OpenSprinkler/OpenSprinkler-Hardware/OSPi/enclsoure/3Dprint/ospi152/ospi152_transparent_frontpanel_sampel.jpg

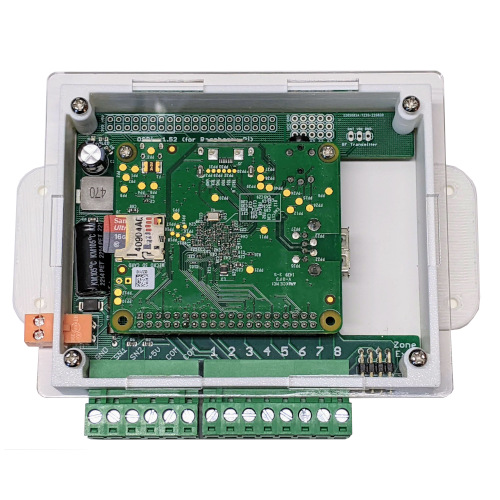
OSPi/enclsoure/3Dprint/ospi152/ospi152_transparent_frontpanel_sampel.jpg
