OpenSprinkler/OpenSprinkler-Hardware/OSPi/enclsoure/3Dprint/ospi152/ospi152_3denc_sample.jpg

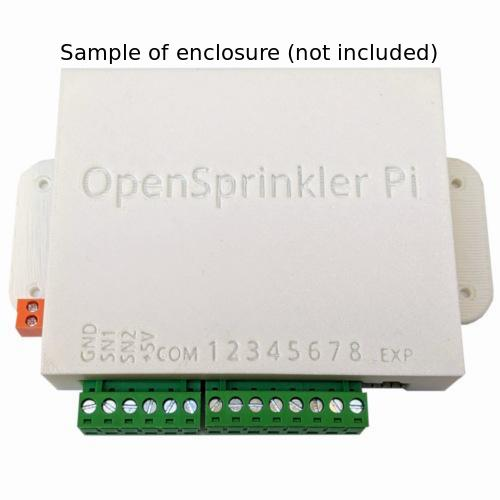
OSPi/enclsoure/3Dprint/ospi152/ospi152_3denc_sample.jpg
