OpenSprinkler/OpenSprinkler-Hardware/README.md

# OpenSprinkler-Hardware
OpenSprinkler Hardware and Enclosure files.
The .sch and .brd files are created in Eagle CAD.
