OpenSprinkler/OpenSprinkler-Hardware/OS/3.0-3.3/README.md

# OpenSprinkler 3.0-3.3
OpenSprinkler 3.0-3.3 used modularized design. It consists of two layers:
- Master Controller, based on ESP8266
- One of three types of drivers: AC, DC, or Latching
