OpenSprinkler/OpenSprinkler-Hardware/OS/3.0-3.3/DC_driver/README.md

- Original DC driver board 3.0 uses PCF8574 (8-channel) IO expander with PNP transistor per channel.

- DC driver 3.1 (i.e. revision 1) uses a PCA9555 (16-channel) IO expander.

- DC driver 3.2 (i.e. revision 2) matches master version 3.2 with support for wired Ethernet module.

- DC driver 3.3 (i.e. revision 3) replaces the 7805 linear regulator with XL2001 switching regulator for higher power conversion efficiency, ideal when using the controller with wired Ethernet.
