OpenSprinkler/OpenSprinkler-Hardware/OSPi/enclsoure/Lasercut/README.txt

The laser cut design assumes 3mm acrylic. 
Details on how the design was generated are in this blog post:
https://rayshobby.net/wordpress/eaglecad-script-for-laser-cut-enclosures/
