OpenSprinkler/OpenSprinkler-Hardware/Expander/3.0/AC/osexp31ac_brd.png

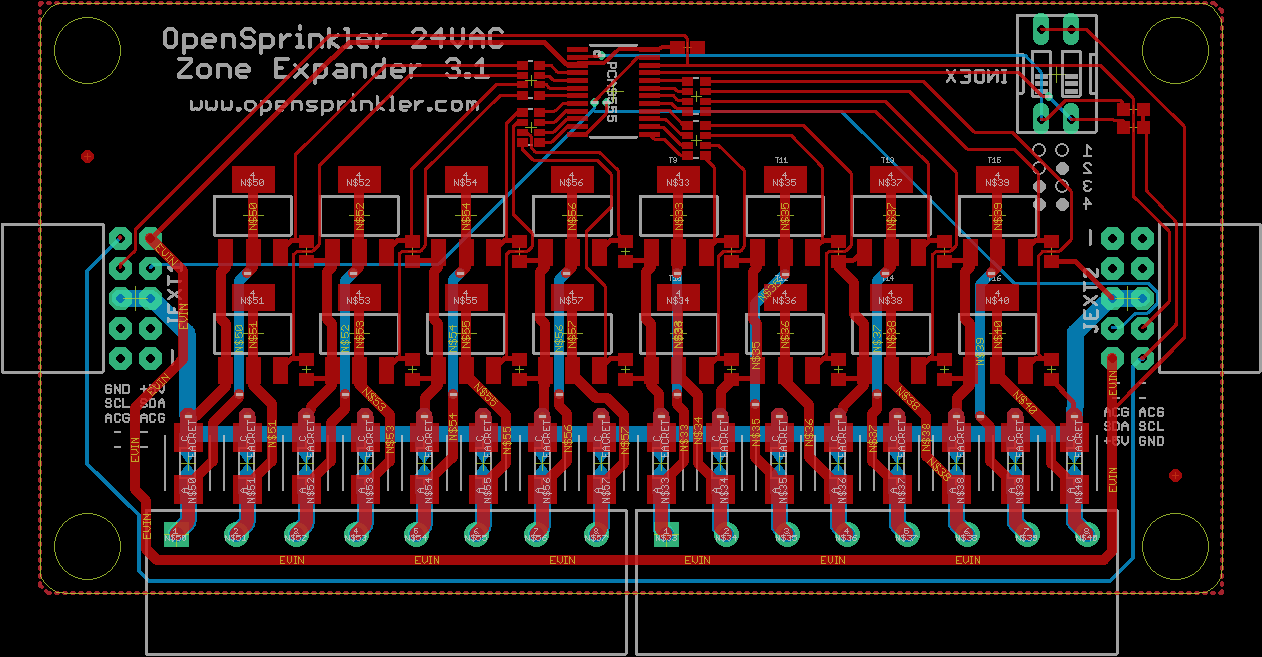
Expander/3.0/AC/osexp31ac_brd.png
