OpenSprinkler/OpenSprinkler-Hardware/Expander/3.0/AC/osexp31ac_sch.png

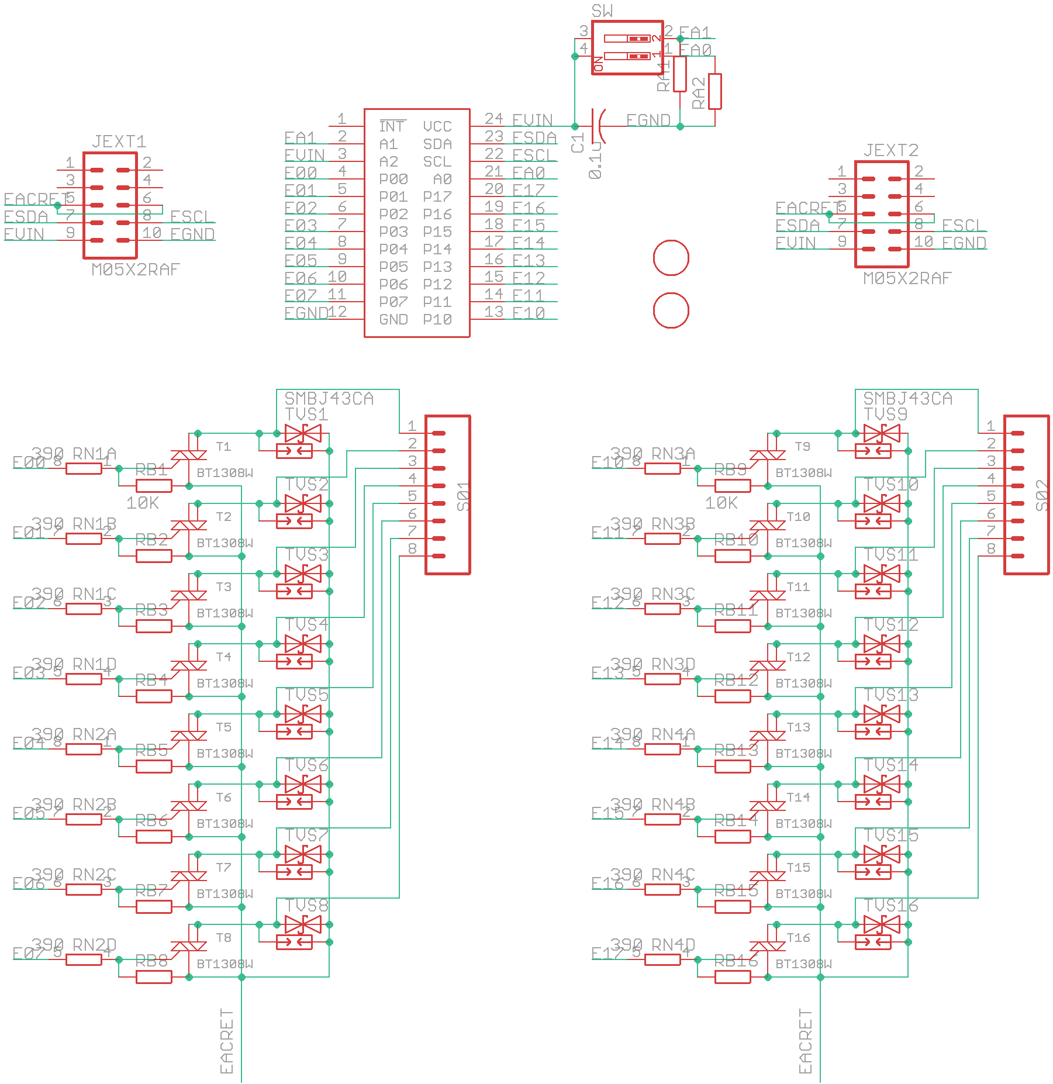
Expander/3.0/AC/osexp31ac_sch.png
