OpenSprinkler/OpenSprinkler-Hardware/Expander/3.0/DC/osexp31dc_brd.png

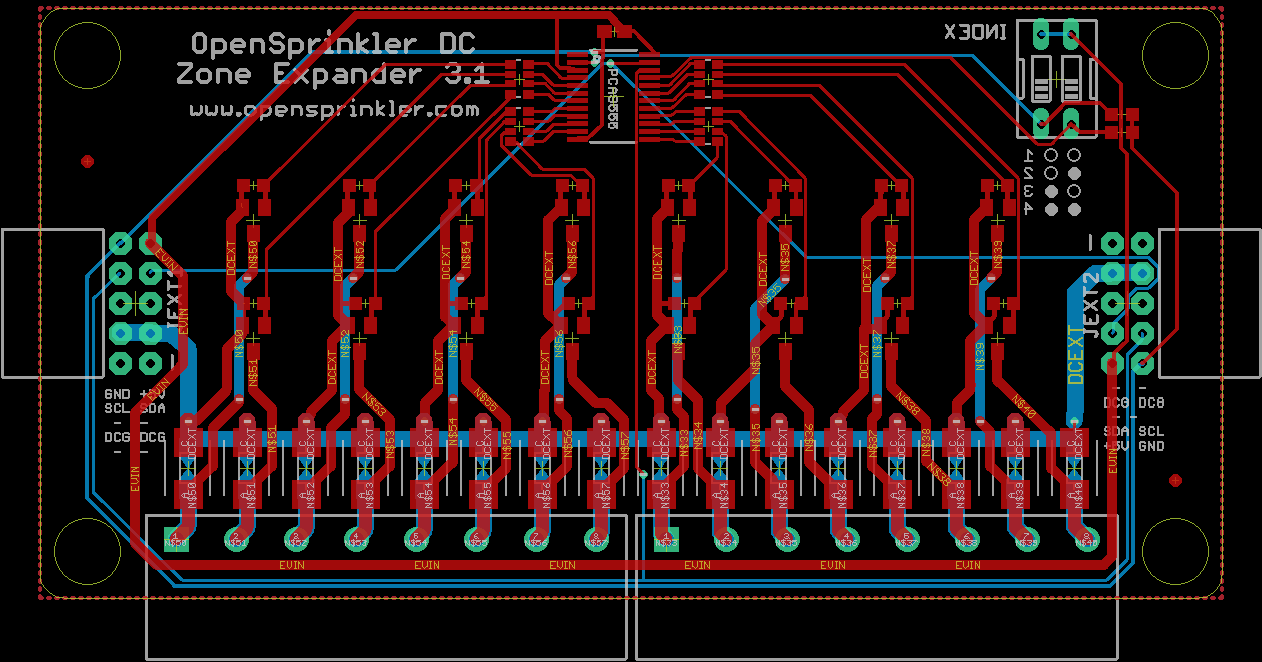
Expander/3.0/DC/osexp31dc_brd.png
