OpenSprinkler/OpenSprinkler-Hardware/Expander/3.0/DC/osexp31dc_sch.png

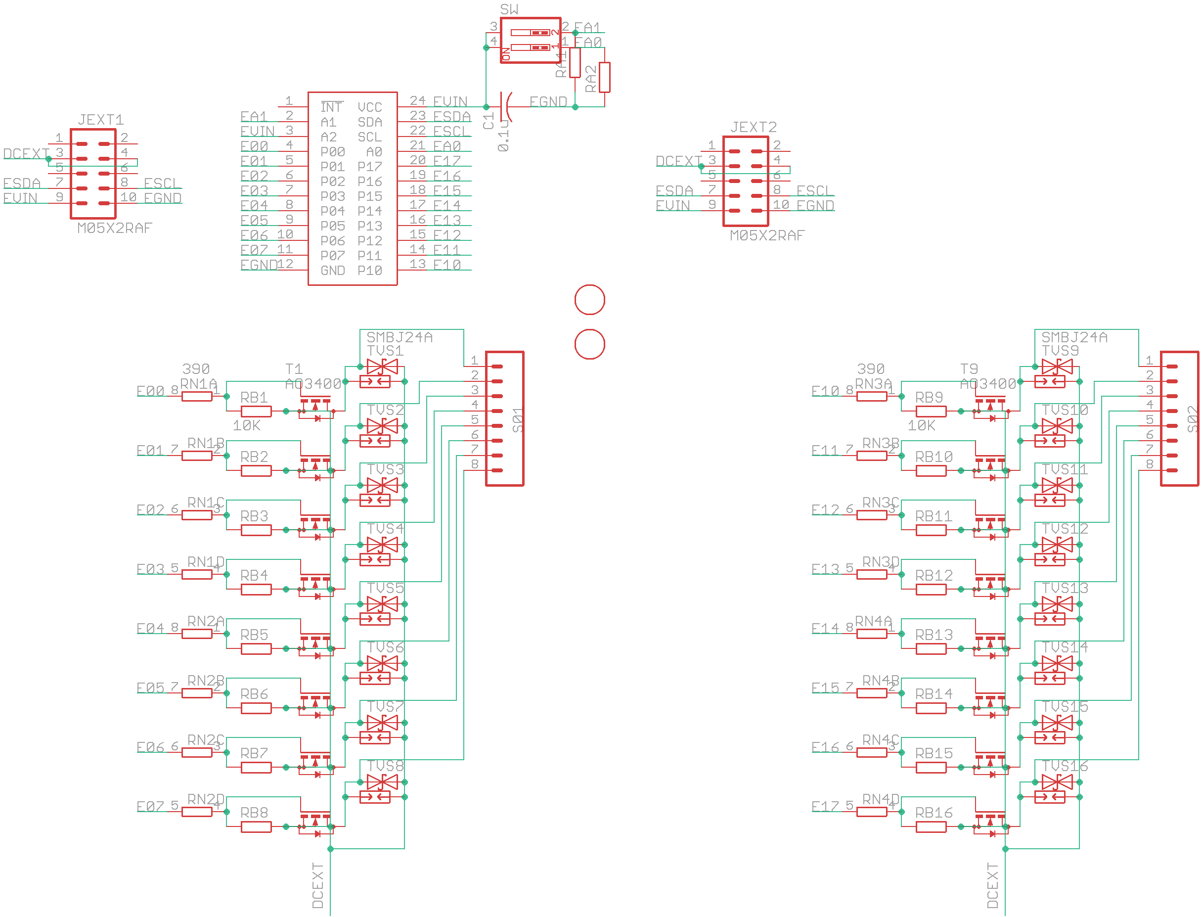
Expander/3.0/DC/osexp31dc_sch.png
