OpenSprinkler/OpenSprinkler-Hardware/OS/2.3/AC/os34ac_sch.png

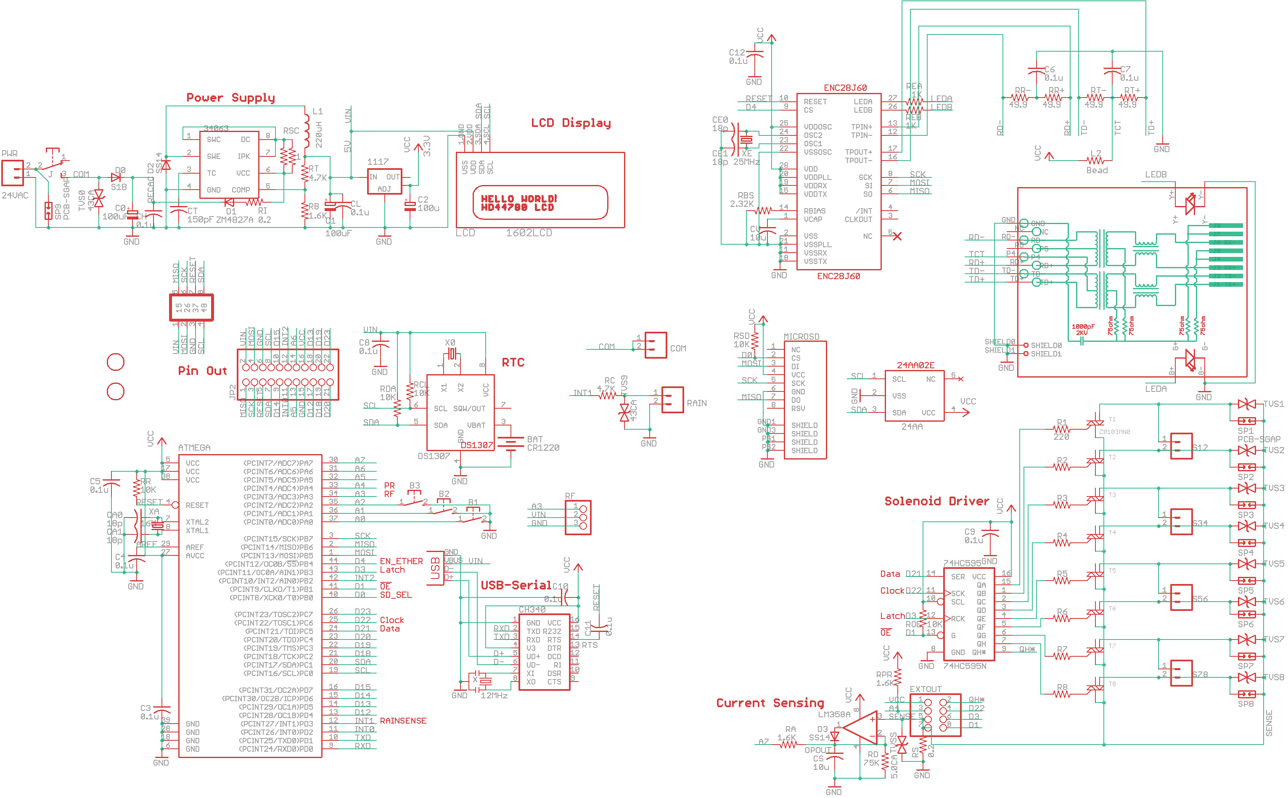
OS/2.3/AC/os34ac_sch.png
