OpenSprinkler/OpenSprinkler-Hardware/OS/2.3/DC/os34dc_sch.png

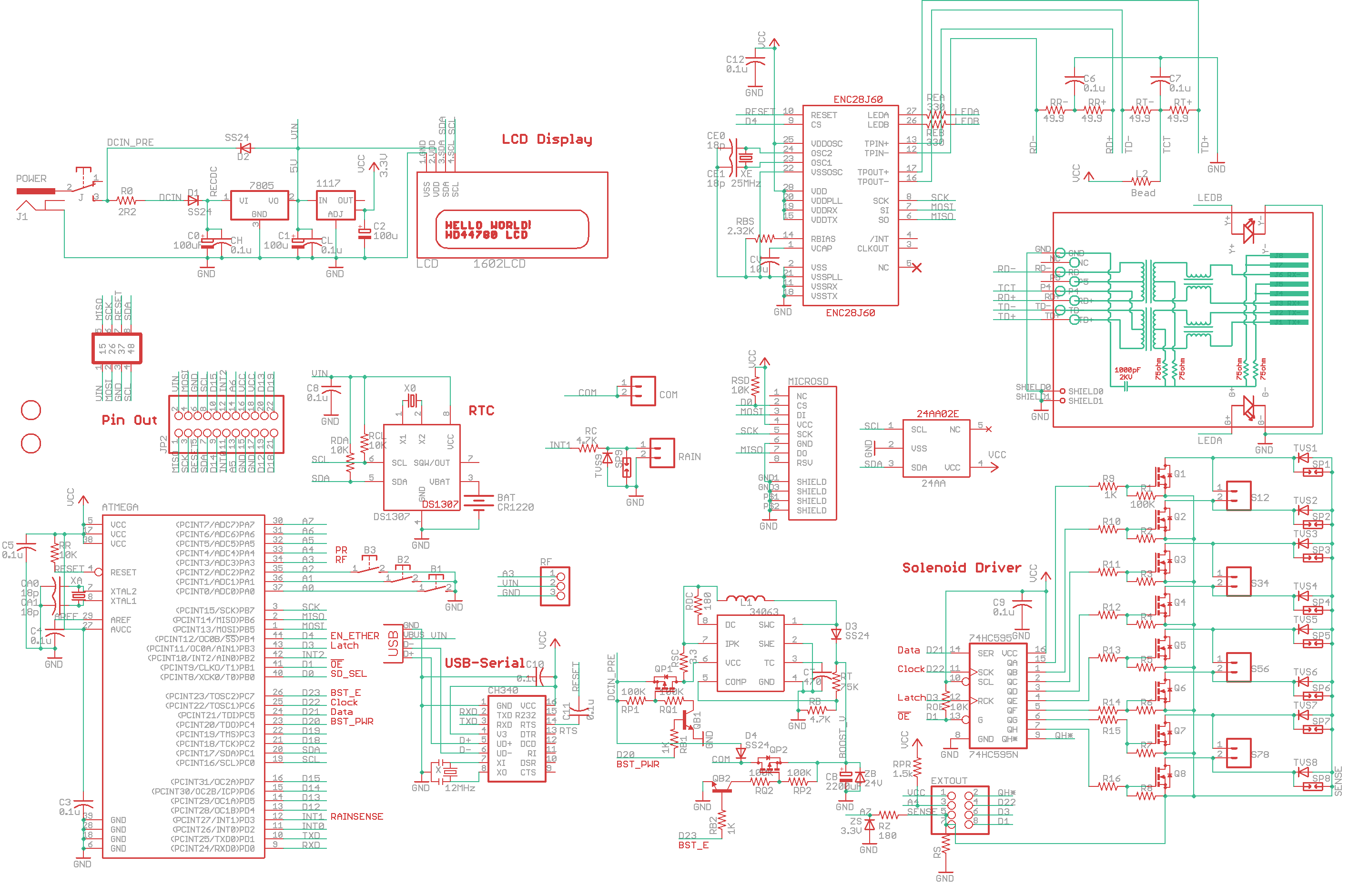
OS/2.3/DC/os34dc_sch.png
