OpenSprinkler/OpenSprinkler-Hardware/OS/3.0-3.3/AC_driver/acdr_3.2.png

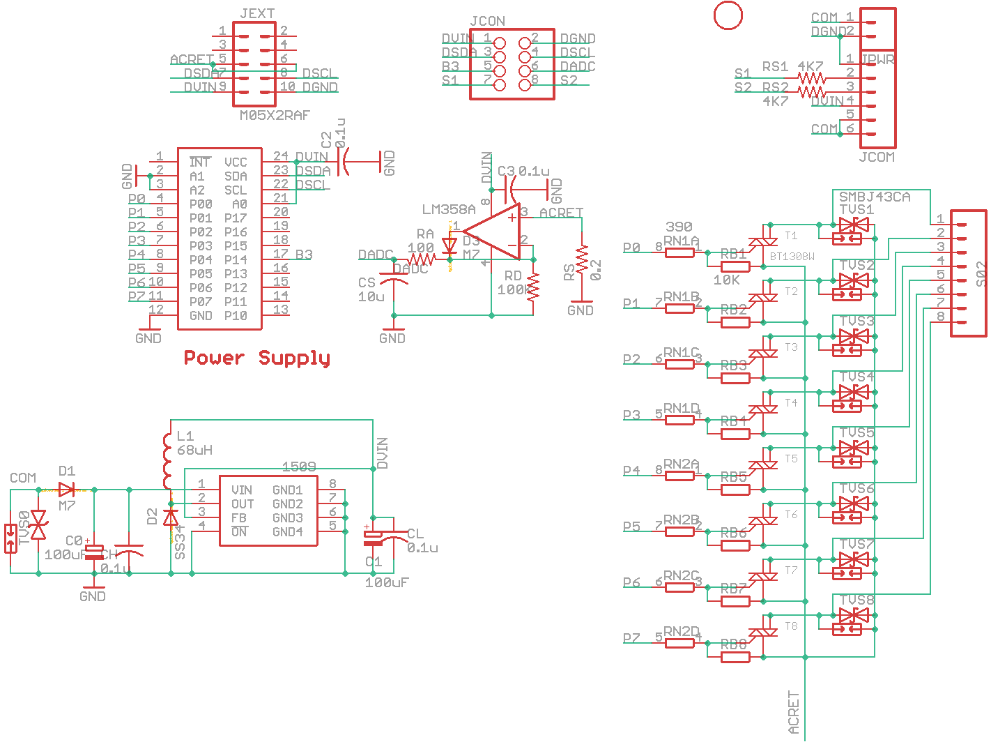
OS/3.0-3.3/AC_driver/acdr_3.2.png
