OpenSprinkler/OpenSprinkler-Hardware/OS/3.0-3.3/DC_driver/dcdr_3.3.png

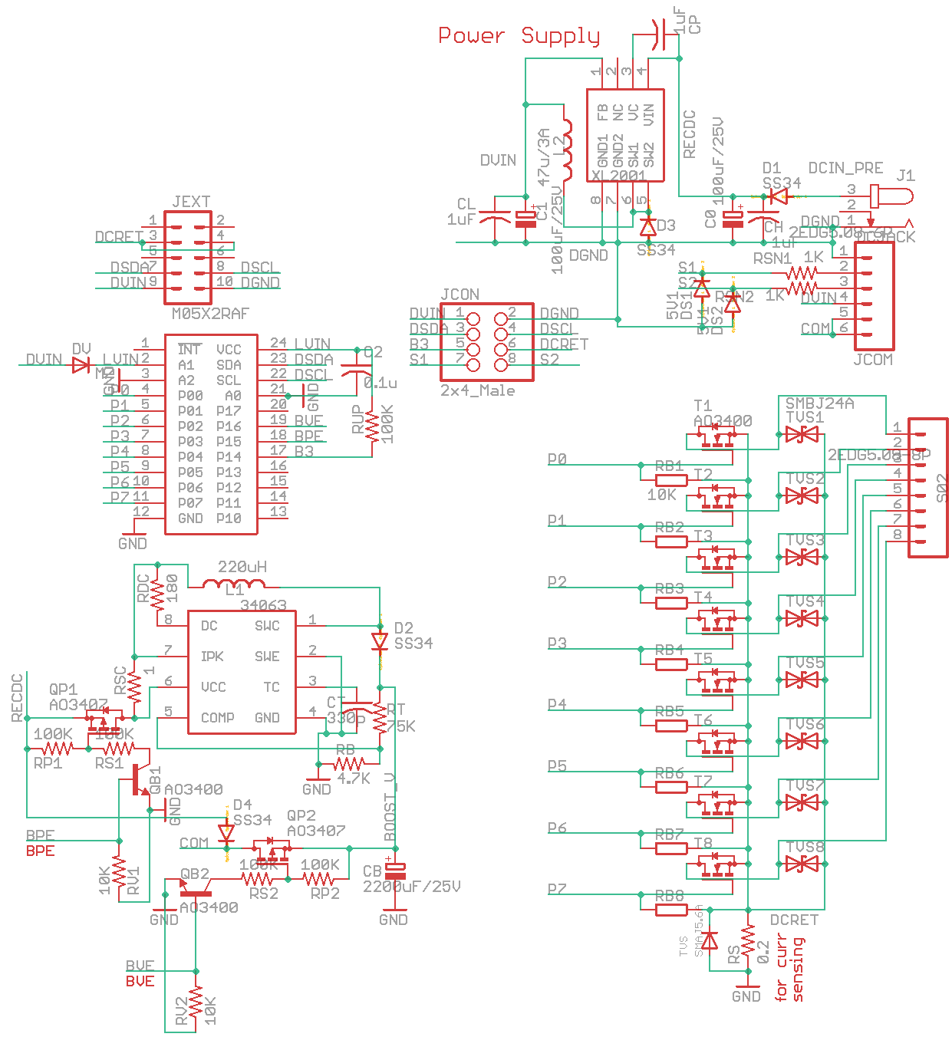
OS/3.0-3.3/DC_driver/dcdr_3.3.png
