OpenSprinkler/OpenSprinkler-Hardware/OS/3.0-3.3/LA_driver/latdr32.png

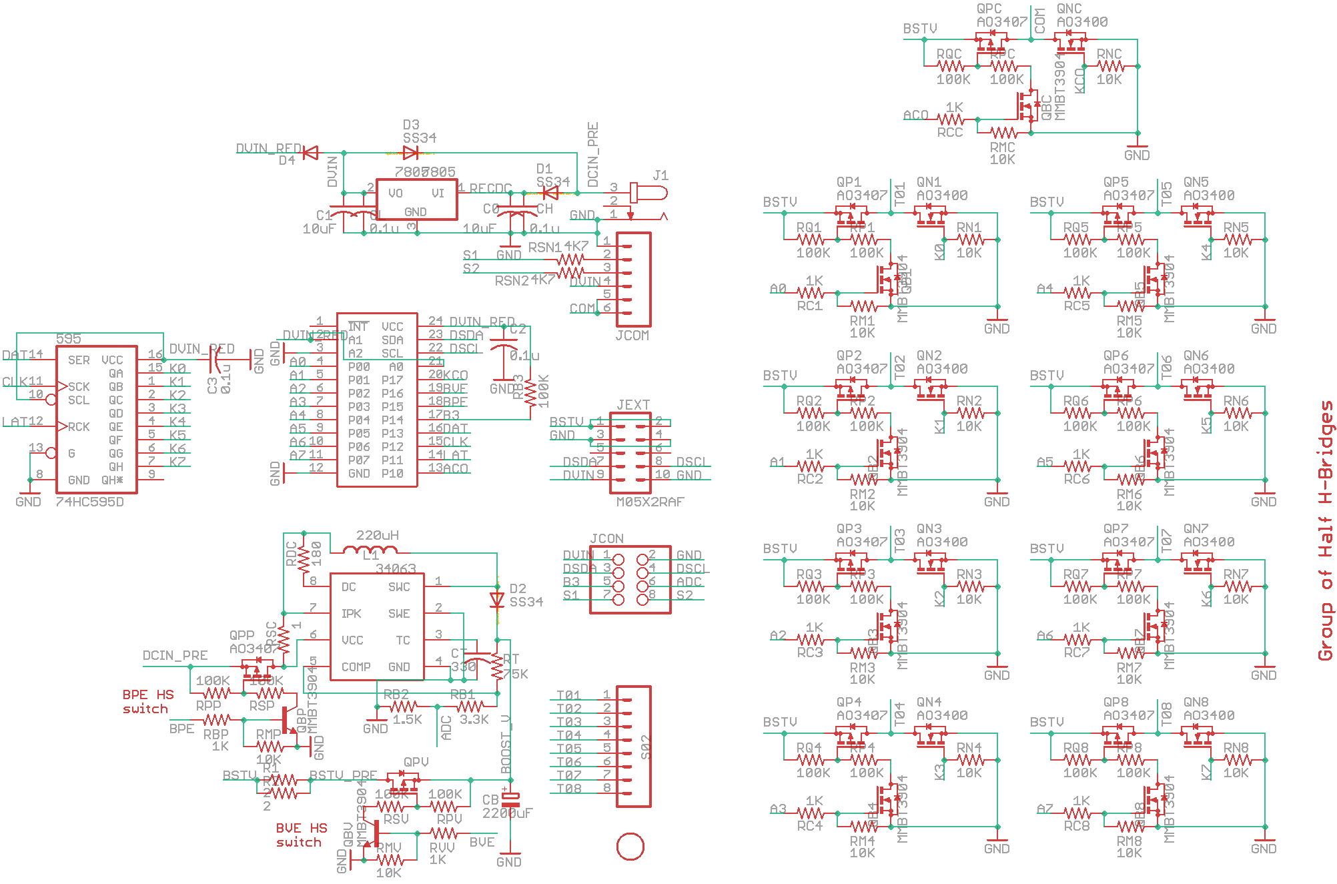
OS/3.0-3.3/LA_driver/latdr32.png
