OpenSprinkler/OpenSprinkler-Hardware/OS/3.0-3.3/Master/os33_master.png

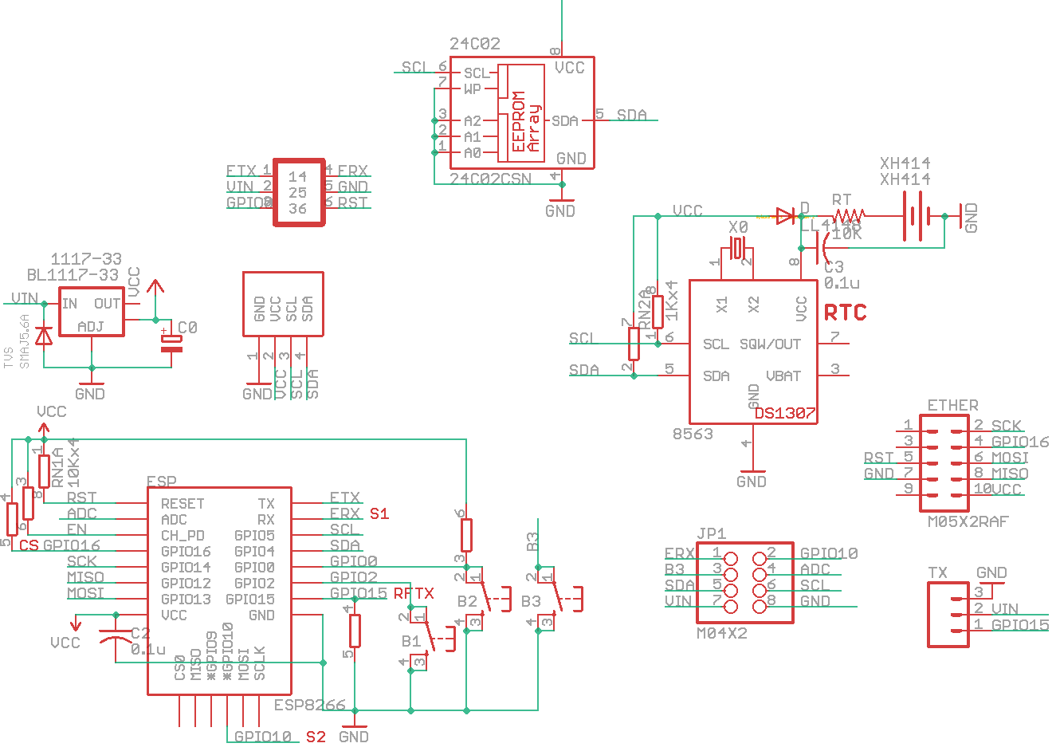
OS/3.0-3.3/Master/os33_master.png
