OpenSprinkler/OpenSprinkler-Hardware/OS/3.4/AC/OS34AC_rendering.png

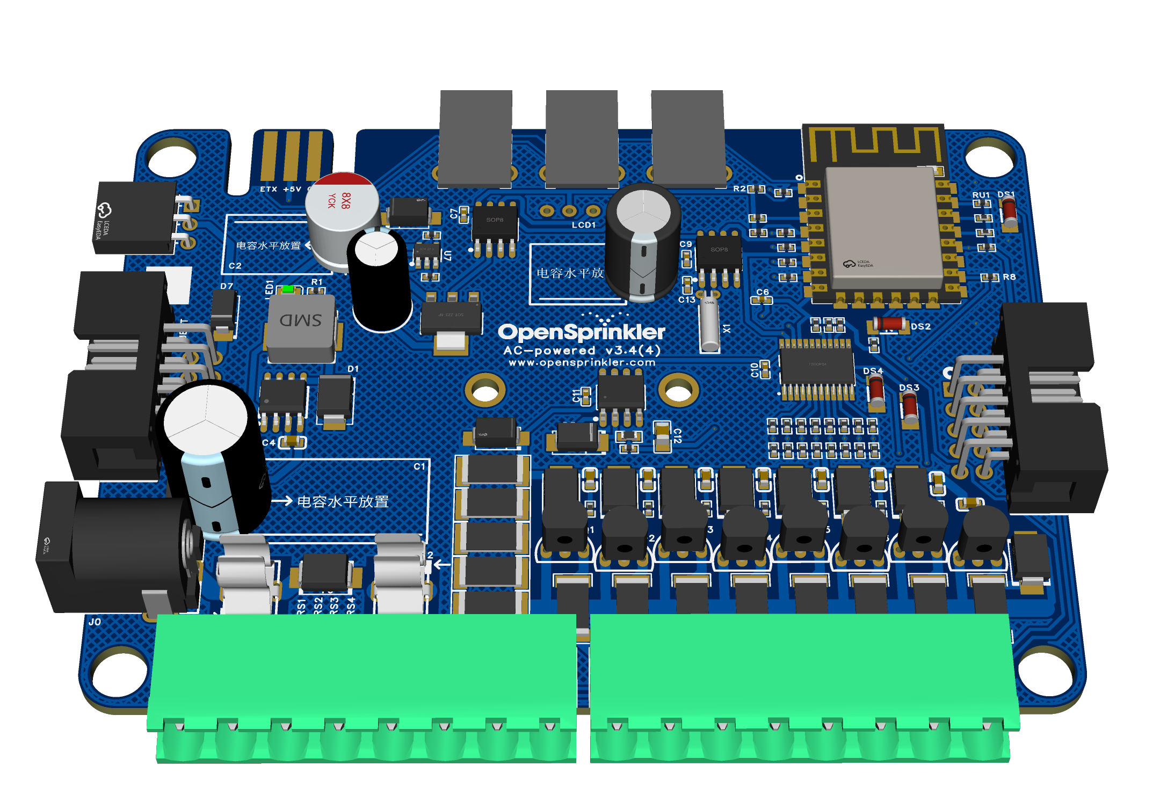
OS/3.4/AC/OS34AC_rendering.png
