OpenSprinkler/OpenSprinkler-Hardware/OS/3.4/DC/OS34DC_rendering.png

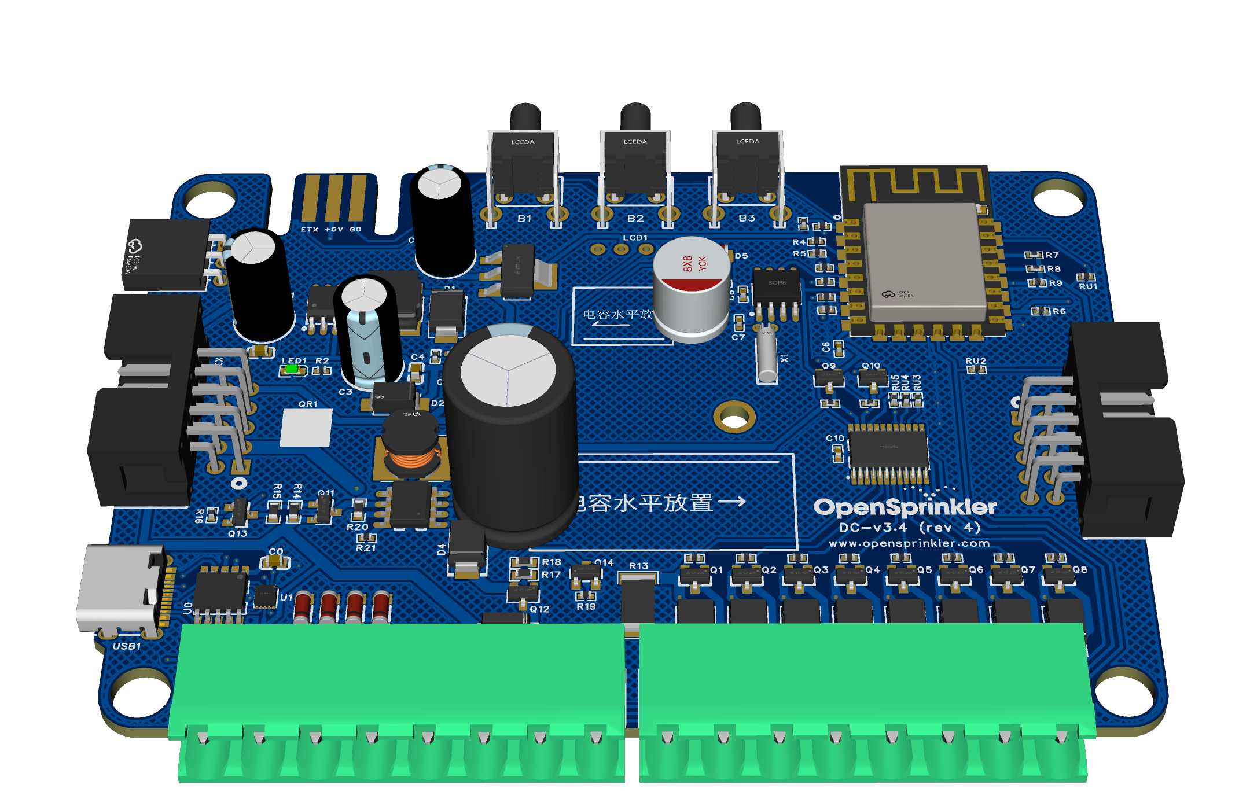
OS/3.4/DC/OS34DC_rendering.png
