OpenSprinkler/OpenSprinkler-Hardware/OSPi/1.51/ospi151_sch.png

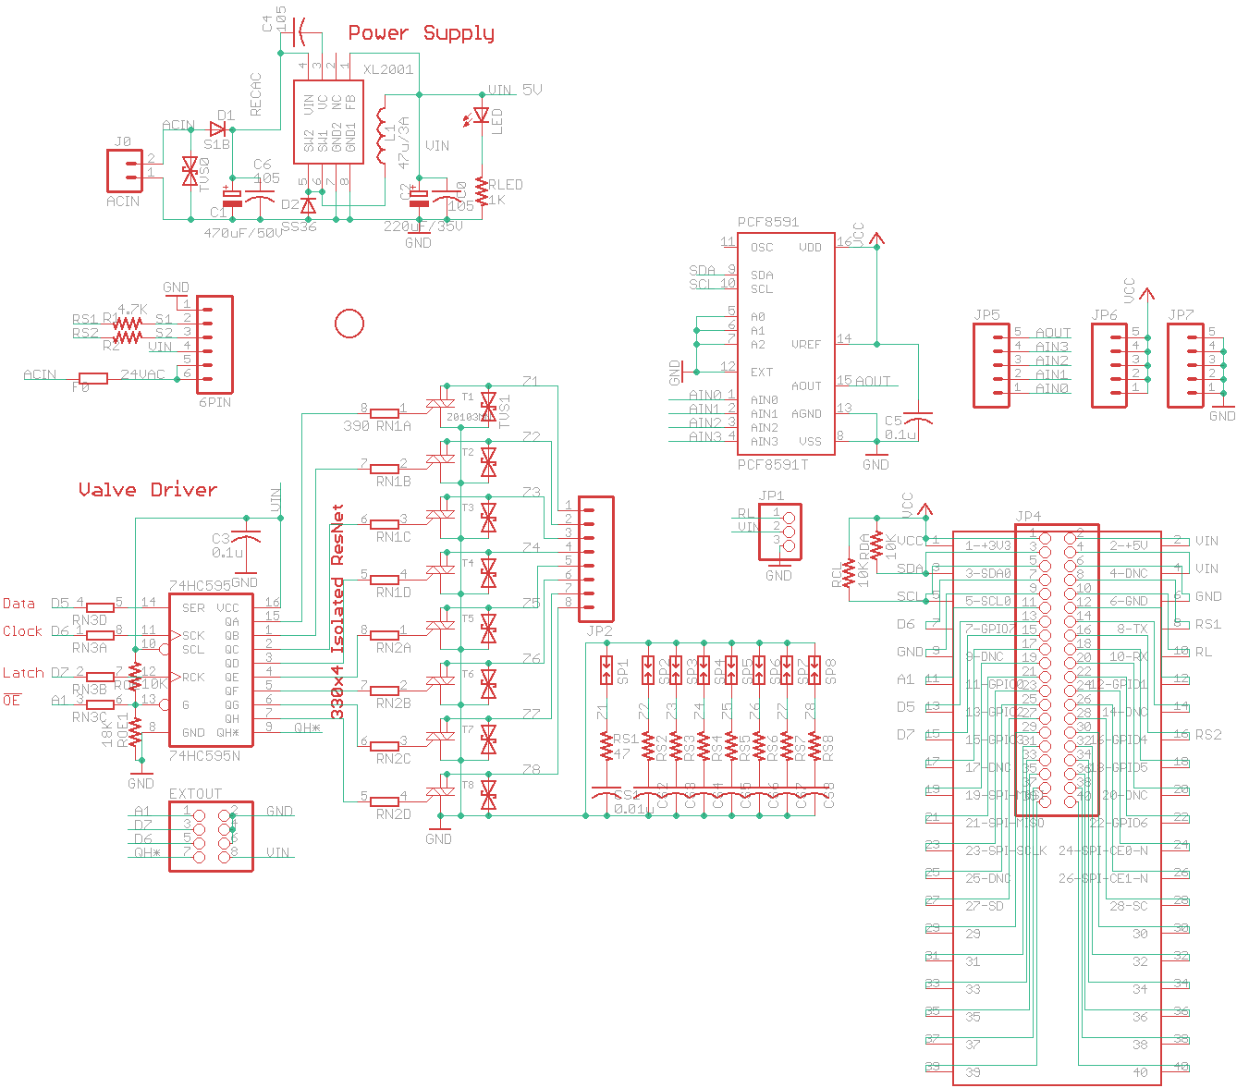
OSPi/1.51/ospi151_sch.png
