OpenSprinkler/OpenSprinkler-Hardware/OSPi/1.52/ospi152_sch.png

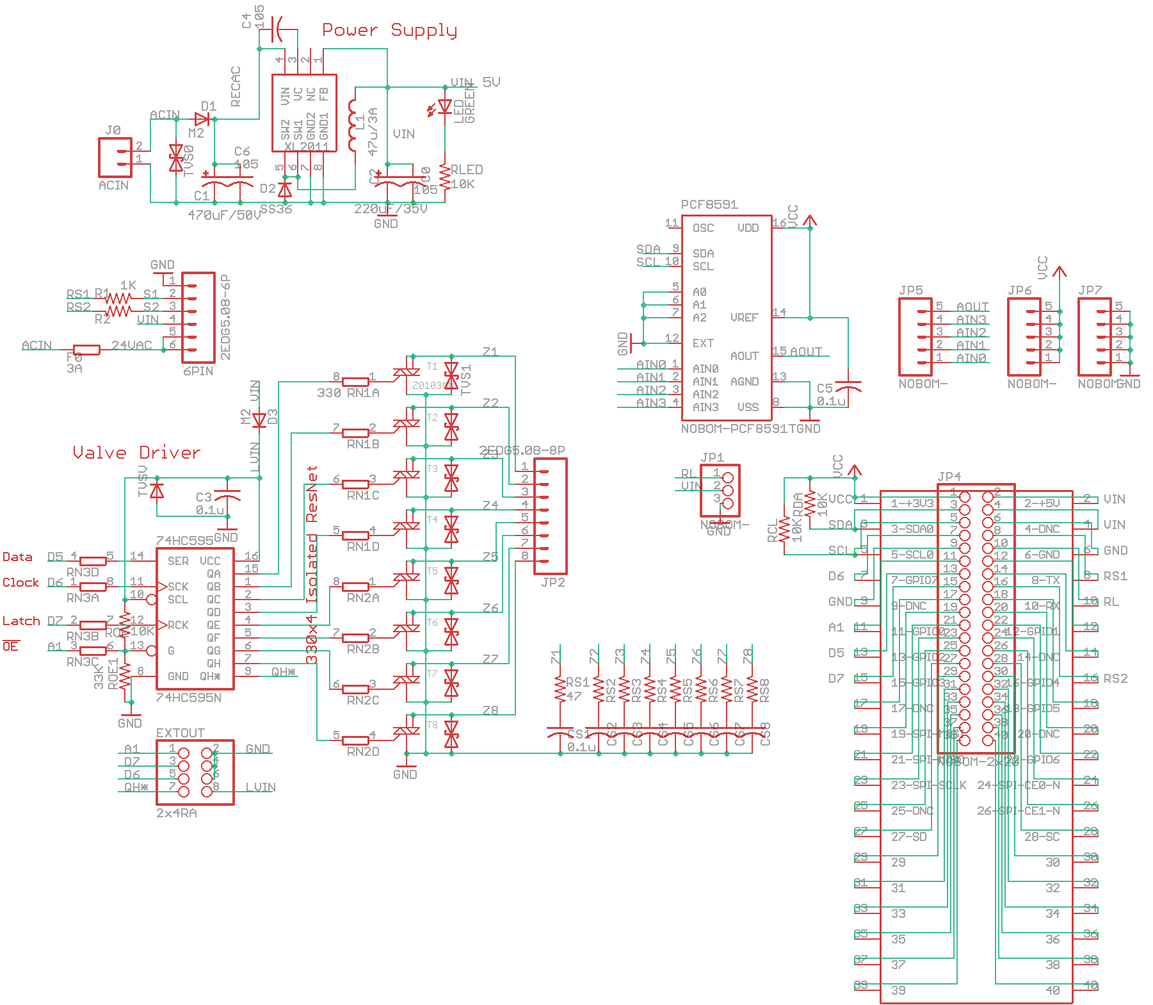
OSPi/1.52/ospi152_sch.png
