OpenSprinkler/OpenSprinkler-Hardware/OSPi/1.60/ospi160_sch.png

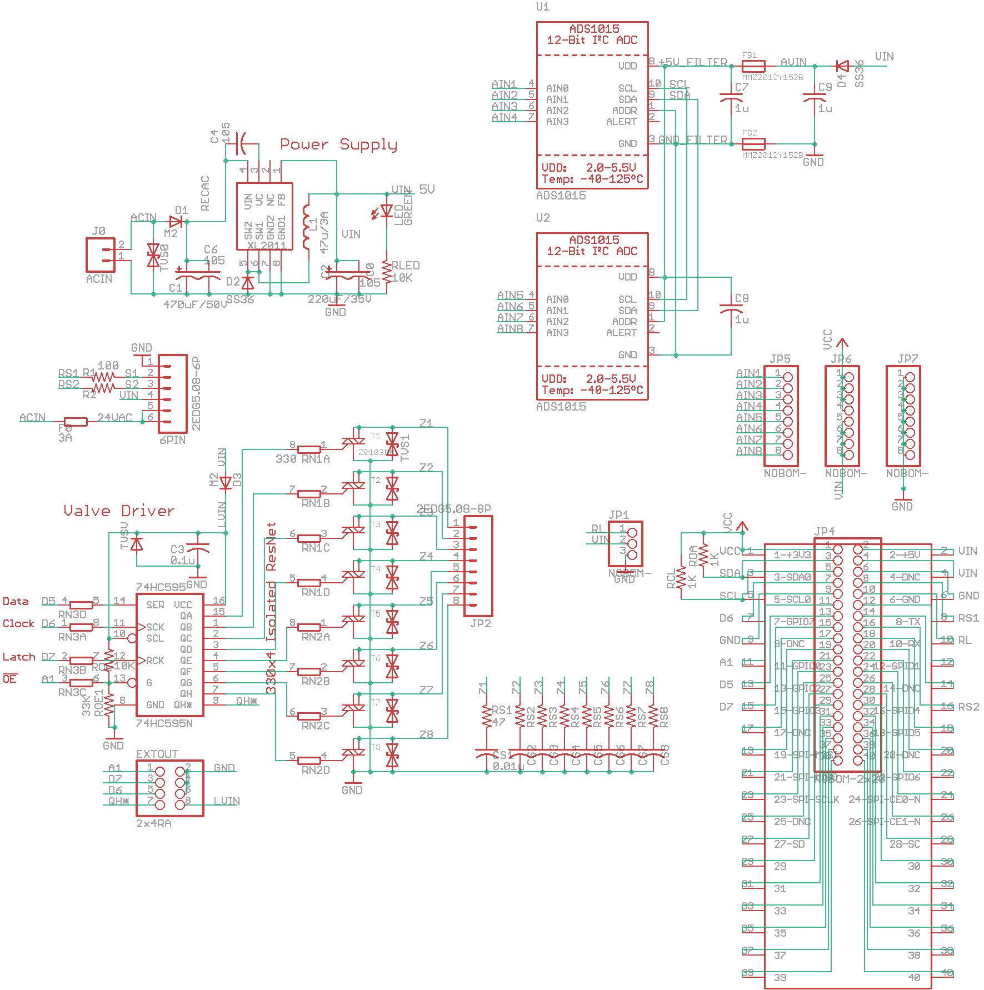
OSPi/1.60/ospi160_sch.png
