OpenSprinkler/OpenSprinkler-Hardware/OSPi/2.0/ospi20_pcb_rendering.png

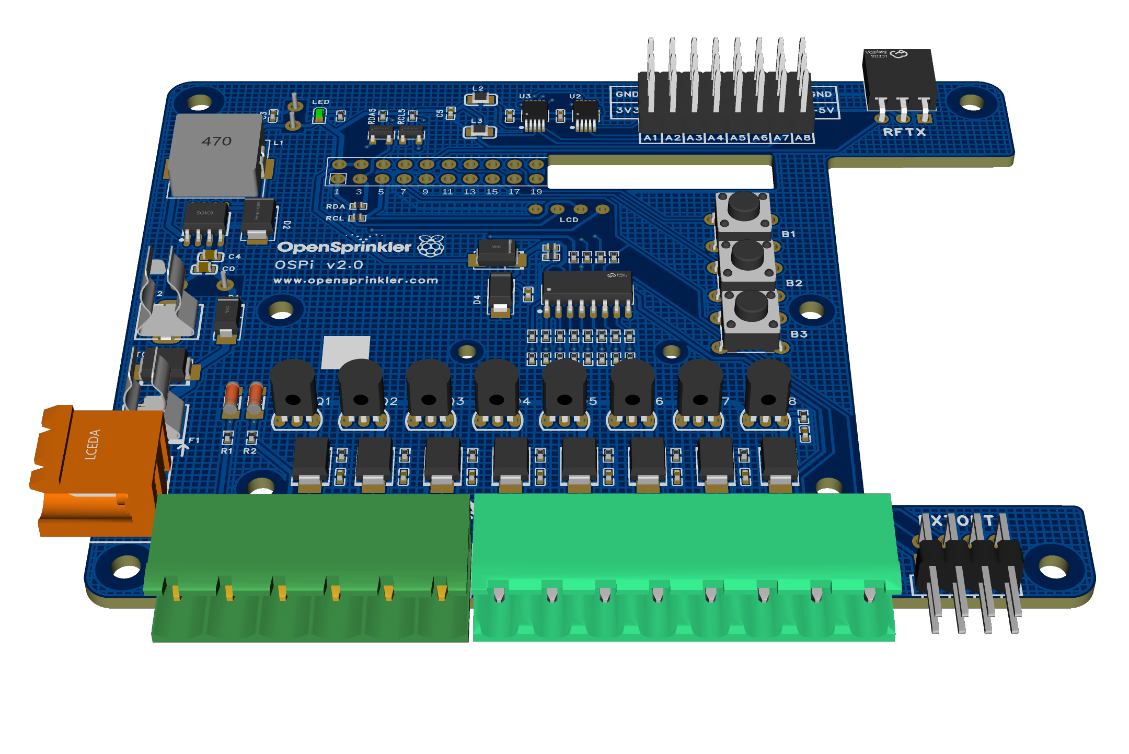
OSPi/2.0/ospi20_pcb_rendering.png
