OpenSprinkler/OpenSprinkler-Hardware/OSPi/2.0/ospi20_bom.xlsx

Designator | Quantity | Comment | Footprint | Value
B1,B2,B3 | 3 | Key_TH_6x6x6 | SW-TH_4P-L6.0-W6.0-P4.50-LS6.5
C0,C4 | 2 | 1uF | C0603 | 1uF
C1 | 1 | 470uF/50V | CAP-TH_BD10.0-P5.00-D1.0-FD | 470uF/50V
C2 | 1 | 220uF/35V | CAP-TH_BD8.0-P3.50-D0.6-FD | 220uF/35V
C3,C5,C6,C7 | 4 | 1u | C0402 | 1u
CC | 1 | 100n | C0402 | 100n
CS1,CS2,CS3,CS4,CS5,CS6,CS7,CS8 | 8 | 10n | C0402 | 10n
D1,D3 | 2 | M7 | SMA_L4.3-W2.6-LS5.2-RD
D2 | 1 | SS36B | SMB_L4.6-W3.6-LS5.3-RD
D4 | 1 | SMAJ6.0A | SMA_L4.3-W2.6-LS5.1-RD
DS1,DS2 | 2 | ZMM5V6 | LL-34_L3.5-W1.5-RD-2
EXTOUT | 1 | 2.54R-8P | HDR-TH_8P-P2.54-H-M-R2-C4-S2.54
F1,F2 | 2 | 5x20Fuse | FUSE-TH_5X20RHOSFUSECLIP-SEAT
H1 | 1 | PZ254V-11-08P | HDR-TH_8P-P2.54-V-M
H2,H3 | 2 | PZ254V-11-08P | HDR-TH_8P-P2.54-V-M
J0 | 1 | 5.08-2P | CONN-TH_2P-P5.08_DB2ER-5.08-2P-OG
J1 | 1 | 2EDGER-5.08-6P | CONN-TH_6P-P5.08_WJ2EDGR-5.08-6P
J2 | 1 | 2EDGR-5.08-8P | CONN-TH_8P-P5.08_WJ2EDGR-5.08-8P
L1 | 1 | 47uH | IND-SMD_L10.8-W10.0_SLO1040H | 47uH
L2,L3 | 2 | MMZ2012Y202BT000 | L0805
LCD | 1 | SSD1306_OLED_I2C_PCB0.75C | SSD1306_OLED_I2C_0.75_C
LED | 1 | LED_0603-G | LED_0603
Q1,Q3,Q5,Q7 | 4 | MAC97 | TO-92-3_L4.8-W3.7-P1.27-L-BT131
Q2,Q4,Q6,Q8 | 4 | MAC97A8_C2831712 | TO-92-3_L4.8-W3.7-P1.27-L-BT131
R1,R2,RCK,RDT,RLA,ROE | 6 | 100 | R0402 | 100
RCL,RCL5,RDA,RDA5 | 4 | 1k | R0402 | 1k
RD1,RD2,RD3,RD4,RD5,RD6,RD7,RD8,RE1 | 9 | 10k | R0402 | 10k
RE2 | 1 | 33k | R0402 | 33k
RFTX | 1 | 254R-3 | HDR-TH_3P-P2.54-H-F-W10.3-N
RG1 | 1 | 330 | R0402 | 330
RG2,RG3,RG4,RG5,RG6,RG7,RG8 | 7 | Res_0402 | R0402
RLED | 1 | 4.7k | R0402 | 4.7k
RPI | 1 | RPIB+10_ | RPIB+-10
RS1,RS2,RS3,RS4,RS5,RS6,RS7,RS8 | 8 | 47 | R0402 | 47
T0,T1,T2,T3,T4,T5,T6,T7 | 8 | SMBJ43CA | SMB_L4.6-W3.6-LS5.3-BI
T8 | 1 | SMBJ43CA | SMB_L4.6-W3.6-LS5.3-BI | SMBJ43CA
T9,T10 | 2 | BSS138 | SOT-23-3_L2.9-W1.3-P1.90-LS2.4-BR
U1 | 1 | XL2011 | SOIC-8_L5.0-W4.0-P1.27-LS6.0-BL
U2,U3 | 2 | ADS1115IDGSR | MSOP-10_L3.0-W3.0-P0.50-LS5.0-BL
U4 | 1 | 74HC595D | SOIC-16_L9.9-W3.9-P1.27-LS6.0-BL
