OpenSprinkler/OpenSprinkler-Hardware/OS/3.0-3.3/Enclosure/os33_top.stl

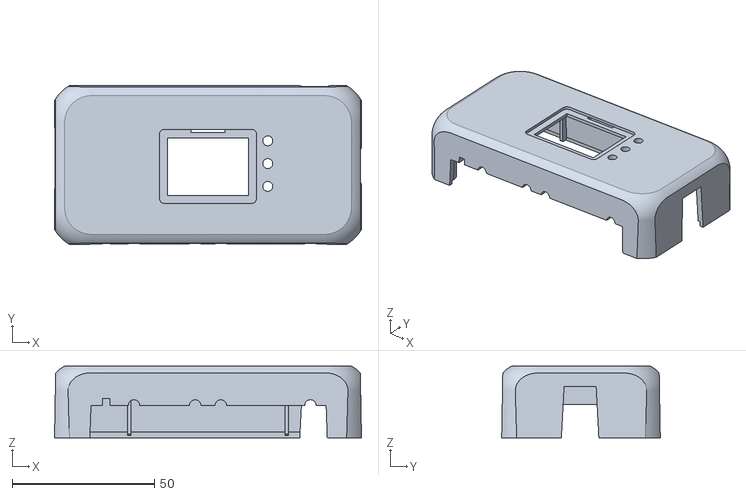
[picture p21: CAD file, 2025-09-22]
OS/3.0-3.3/Enclosure/os33_top.stl
107.9 x 55.7 x 25.2
