OpenSprinkler/OpenSprinkler-Hardware/OSPi/enclsoure/3Dprint/ospi152/OSPi152.stl

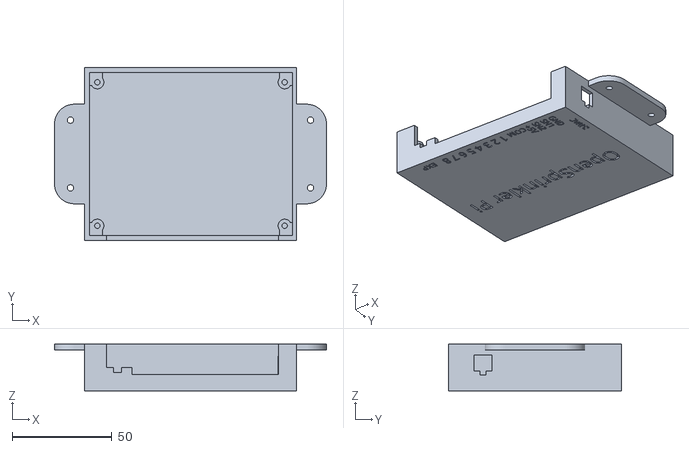
[picture p22: CAD file, 2022-09-12]
OSPi/enclsoure/3Dprint/ospi152/OSPi152.stl
136.5 x 87.0 x 23.5
