OpenSprinkler/OpenSprinkler-Hardware/OSPi/enclsoure/3Dprint/ospi20/ospi20_tight.stl

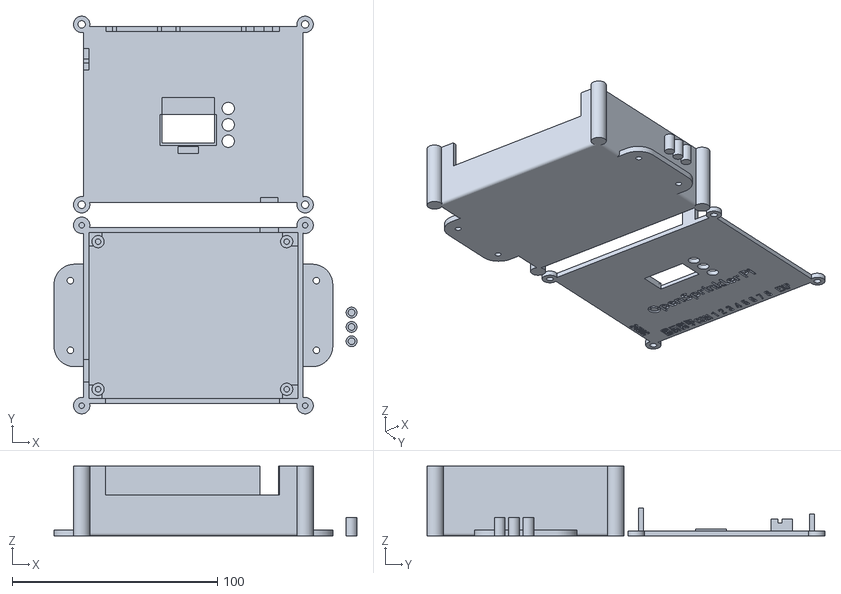
[picture p23: CAD file, 2024-09-27]
OSPi/enclsoure/3Dprint/ospi20/ospi20_tight.stl
147.8 x 194.0 x 34.1
