OpenSprinkler/OpenSprinkler-Hardware/OS/3.0-3.3/Enclosure/os33_bottom.stl

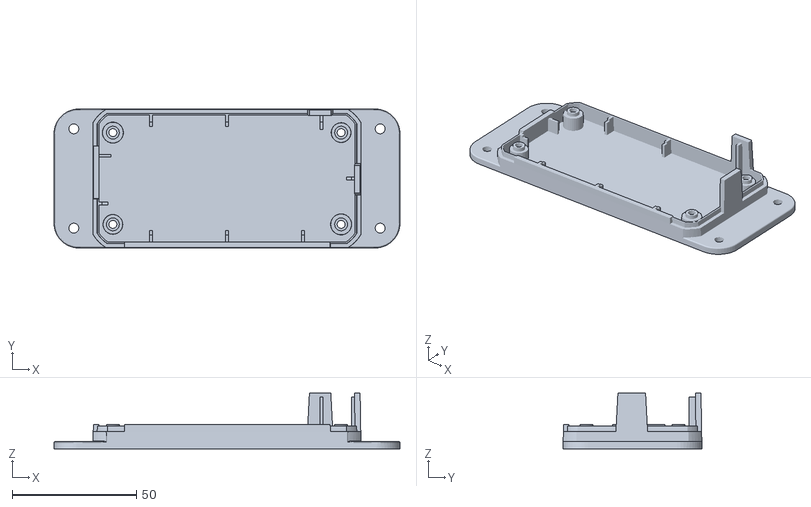
[picture p24: CAD file, 2025-09-22]
OS/3.0-3.3/Enclosure/os33_bottom.stl
139.5 x 56.0 x 22.4
