OpenSprinkler/OpenSprinkler-Hardware/OSPi/enclsoure/3Dprint/ospi152/OSPi152_no_frontpanel.stl

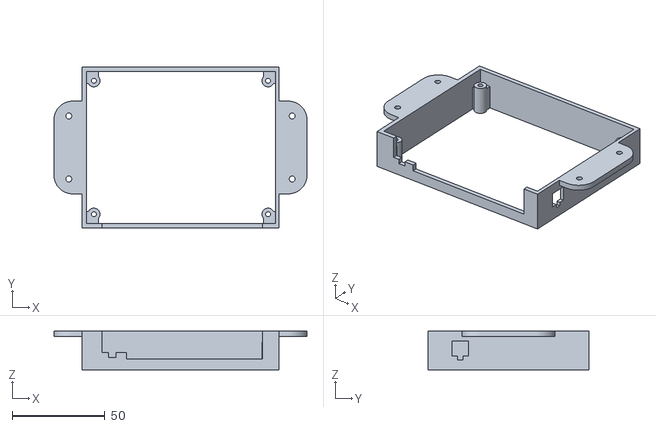
[picture p25: CAD file, 2022-09-12]
OSPi/enclsoure/3Dprint/ospi152/OSPi152_no_frontpanel.stl
136.5 x 87.0 x 21.0
