OpenSprinkler/OpenSprinkler-Hardware/OSPi/enclsoure/3Dprint/ospi20/ospi20_colored_print.3mf

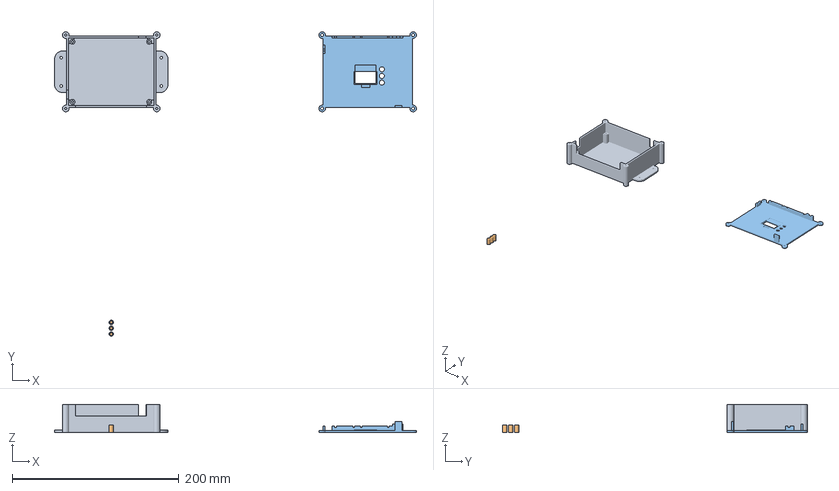
[picture p26: CAD file, 2024-09-27]
OSPi/enclsoure/3Dprint/ospi20/ospi20_colored_print.3mf
433.7 x 364.8 x 34.1 mm
OSPiv20ENC.stl
OSPiv20ENC (1).stl
OSPiv20ENC (3)
