OpenSprinkler/OpenSprinkler-Hardware/(threads)

Thread 1 (2017-10-07):

Able to include a BOM?

dwjp, 2017-10-07:
Is it possible to include a BOM with component manufacturer and part numbers (and ideally distributor, e.g. Digikey, part number) for V3? I can probably figure out most details from schematic, but it'd be great to have something concrete.

adrian78666, 2017-10-07:
I second this request.

giig1967g, 2018-04-02:
i would like it too

laurentopia, 2018-08-21:
Have you folks figured out the BOM?

rubengr, 2019-12-09:
Is not public the BOM?

laurentopia, 2019-12-14:
here is the BOM so far, I gave up
https://docs.google.com/spreadsheets/d/11xkz92zQxZZgTctV5IspjD9BH1N4TvmNcIJ9ATqKawM/edit?usp=sharing

Egyras, 2020-01-17:
who can share AC ver. gerber file ?

Egyras, 2020-01-30:
> here is the BOM so far, I gave up
> https://docs.google.com/spreadsheets/d/11xkz92zQxZZgTctV5IspjD9BH1N4TvmNcIJ9ATqKawM/edit?usp=sharing

Hi, who has AC ver. BOM file ?

rayshobby, 2024-05-15:
1) We use a Chinese factory to manufacture the boards and they source the parts for us locally from China. So we don't have parts numbers in Digikey or Mouser because they don't buy parts from them.
2) The schematic has part values. Almost all parts are very common resistors, capacitors, diodes, transistors. A few ICs are not as common (like XL2001 switching regulator), but those parts are also clearly defined in the schematic.

Thread 2 (2018-08-04):

It would be great to have photos of how things look.

laurentopia, 2018-08-04:
I will build this project as a way to learn how to build circuits.
I can create a BOM in eagle but some items are not recognized, the switches and the plugs for example, that would be great to have your BOM in .csv format that mouser recognizes. Or maybe you use another store for your SMD? Also it would be great to have photos of how the parts fit.

laurentopia, 2018-08-04:
I tried to auto BOM->excell cleanup->mouser and got this list ;)
https://www.mouser.com/bom/edit?bomId=f5f01cde-92ca-4a33-b411-7b9ec5b9296c

rayshobby, 2020-06-19:
this cart link is your private link and is not publicly accessible.

laurentopia, 2020-06-19:
this works:
https://www.mouser.com/ProjectManager/ProjectDetail.aspx?AccessID=b38ef469f6

Closed 2020-06-19.

Thread 4 (2019-09-16):

Files unreadable in current version of Eagle 9.5.0

bdlabitt, 2019-09-16:
Eagle-9.5.0 (linux) downloaded today cannot read either the brd or sch files.  Message is:

Loading /home/bruce/Apps/eagle-9.5.0/ospi143.sch ...
Error:
line 8, column 16: This is not an EAGLE file.

Loading /home/bruce/Apps/eagle-9.5.0/ospi143.brd ...
Error:
line 8, column 16: This is not an EAGLE file.

Is there a reader that can view these files?  Otherwise, this HW repo may not be useful anymore, except to those with old versions of SW.

bdlabitt, 2019-09-16:
Closed.  Can import into KiCad.  Had a bad download from github.  It downloaded the html on the page, not the file contents.

bdlabitt, 2019-09-16:
my mistake for not actually opening the files and seeing it was a bad download.

Closed 2019-09-16.

Thread 6 (2020-10-15):

Schematics in PDF?

ilium007, 2020-10-15:
Hi - I don't have or use Eagle. Would it be possible to see the schematics in PDF format? Cheers.

ilium007, 2021-06-22:
Came here looking for PDF's schematics again and realised I already raised an issue for them! Any chance of PDF schematics?

lbussy, 2021-06-22:
Eagle has a [free version](https://www.autodesk.com/products/eagle/free-download) which I use for all of my designs.  You can [download it](https://www.autodesk.com/products/eagle/free-download), install, and [print the schematic to PDF](https://www.digitaltrends.com/computing/print-pdf-windows/) (part of Windows) in about as much time as it took me to respond to this.

ilium007, 2021-06-29:
I realise this but the schematic had no parts values, I just thought it might be easier to have a PDF included in the source files as is done on so many other projects I follow. I use KiCAD not Eagle so I don't have it installed locally.

rob040, 2022-07-19:
I second the request.
Or better, add PNG of schematic and pcb's and add full BOM, especially when schematic don't come with component values.

The @[lbussy](https://github.com/lbussy) suggestion to download Eagle yourself is not as straightforward as it sounds. First, you have to register at Autodesk and part with your privacy to be able to use it. Next, there is issue #6, where it is reported that files can't be opened.

Therefore, the request to the team to make schematics, PCB prints and bom also available in general readable formats.

rayshobby, 2024-05-15:
All current versions of board designs have PNG exports included in the folders.

Closed 2024-05-15.

Thread 7 (2021-02-15):

Can't open .brd or .sch files

martinpala, 2021-02-15:
Using EAGLE 9.6.2. education
Error when opening dcdr_3.2.brd
Error when opening other files as well
errorcode:
line 8, column 16: This is not an EAGLE file.

Thanks.

DKCroCo, 2021-02-25:
I have the same issue.

WhiteCarcosa, 2021-09-20:
> I have the same issue.

You may need be altering the file during the save process like i was. Right clicking the RAW button and saving fixed the issue for me.

rayshobby, 2024-05-15:
I just tried opening these files in Eagle 9.6.2. They opened just fine. No problem with them. You can try to download the entire repository and unzip it, instead of downloading a single file.

Thread 10 (2022-10-31):

Enhancement suggestion for OSPi152.stl

daz10000, 2022-10-31:
Small suggestion but making a perforation or opening for the ethernet port would be handy - I guess people just deploy these things on wifi, but if you want to do a wired connection you need a drill :) - I should have thought of this before printing and just made a hole - my bad.
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

Sputnick85, 2024-01-03:
It would be great to have access to the USB Ports as well :)

rayshobby, 2024-09-07:
I will have to leave this for the user to modify the 3D model themselves. Different RPis may have different ports and positions (for example, the USB and Ethernet jack on RPi 4 and RPi 5 are not the same). Since I don't own all versions of RPis, I won't be able to create one variant for each RPi.

Closed 2024-09-07.

Thread 11 (2023-01-14):

Burned Transistor Reeplacement

PipeDeveloper, 2023-01-14:
Hello @rayshobby

Yesterday one of the station of my OpenSprinkler Pi stopped working suddenly.
After check the wiring and the valve then i move to check the OSPi board and i see a burned component on the board. (evident)

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

After some measuring 24v (AC) and a average consumtion of 0.23 - 0.25 A (per valve individually) i have no idea what could happen.
I dont know if the time of use is important on that case but specifically most of valves works about 20minutes per day except that station that usuay works for 3hours per day.

I would like to reeplace that component, but i could not find any information bout the part number, model, etc...
I apreciate your help in provide that information and maybe an alternative (that supports more current) to extend the life of the board.

Thank you in advance!

Henrik99, 2023-05-16:
By some google search I believe the component is the ST Z0103MN 6AA4. You can see the ST logo on the Triac, ST uses the Z3M as the marking for it (see page 14 https://www.mouser.de/datasheet/2/389/z01-1594011.pdf) I could be wrong tho.

rayshobby, 2024-05-15:
The triac is of type Z0103MN. There are several subtypes, but Z0103MN 5AA4 are quite common and widely available. If your hardware order was within 1 year, it's covered under warranty and we can replace it free of charge. For support questions please go to support.openspirnkler.com and file a support ticket there.

Closed 2024-05-15.

Thread 12 (2024-09-01):

v1.6 missing?

themikem, 2024-09-01:
Hi,

I recently purchased an OpenSprinkler Pi board which is labeled as v1.60. However I don’t see the v1.60 schematics in this repo.

I’m trying to determine how to disconnect the voltage regulator that feeds the pi, as when both the USB-C and 24v ac connectors are attached, the Pi will not boot. (Using a pi 5)

is there somewhere else I should look for a newer version? Having a matching schematic would be a big help at the moment.

Thanks!

rayshobby, 2024-09-07:
I've just added v1.60 design files. The main difference is v1.6 has changed the ADC chip from the previous PCF8591 (obsolete part) to ADS1115. That said, the OpenSprinkler firmware doesn't support OSPi ADC at the moment yet, so this change is really only meant for the future when ADS support will be added.

I am a bit surprised that your RPi can't boot when having both USB-C and 24V connected. Generally this should work just fine. If you want to disconnect OSPi's 5V to RPi, there are a few possible approaches:

1. On the OSPi board, cut the +5V trace that goes to the two +5V pins on the 2x20 female pin header (this trace is on the back of the board).
2. If you'd rather not cut the trace, here is another way: at the 24VAC orange terminal block, the top pin is GND, the bottom pin is 24VAC. Remove the bottom pin from the orange terminal block, also remove the common wire from the COM terminal, then directly connect these two wires together (i.e. the original 24VAC wire goes straight to common wire without any terminal block). This way, the OSPi board won't be powered from 24VAC, but 24VAC will still be used to power the solenoids.

Closed 2024-09-07.

Thread 13 (2025-04-06):

Updated Eagle Files or migrate to KiCad

AUPoolUser, 2025-04-06:
Hi

it appears that the eagle files for the hardware are in the old binary format which are no longer supported by autodesk. Nor does KiCad appear to be able to import them into its latest version.

Any chance that the files can be updated to the latest format now that Eagle is practically dead unless you buy the full Fusion subscription. Alternatively kiCad would be great.

Or can you point me to an eagle download that is compatible?

Thanks + Regards

rayshobby, 2025-05-12:
Which specific hardware design files is this referring to? Most of the recent hardware designs are in ASCII/human-readable formats.

rayshobby, 2025-05-14:
https://eagle-updates.circuits.io/downloads/latest.html
Version 9.6.2 does not require a paid license. It has limitations but the OpenSprinkler circuits are all below the limitations so can open just fine.

Closed 2025-05-14.
