OpenSprinkler/OpenSprinkler-Hardware/OSPi/2.0/ospi20_schematic.pdf

# Power Supply ADC

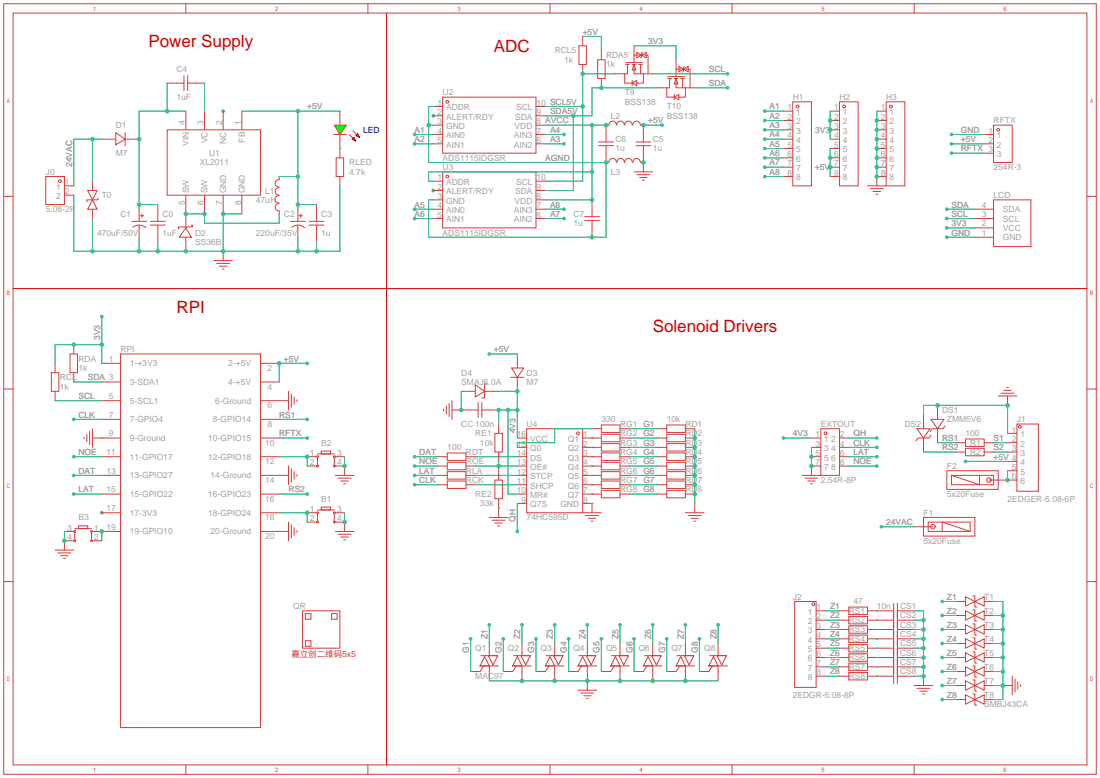
[picture p27: page 1]

7-GPIO4 7 | RS1
9-Ground 9 | RFTX

MR# 10 SHCP 11 STCP 12 OE# 13 DS 14 Q0 15 VCC 16
