OpenSprinkler/OpenSprinkler-Hardware/OS/3.4/AC/OS34AC_Schematic.pdf

# Power Supply ESP8266

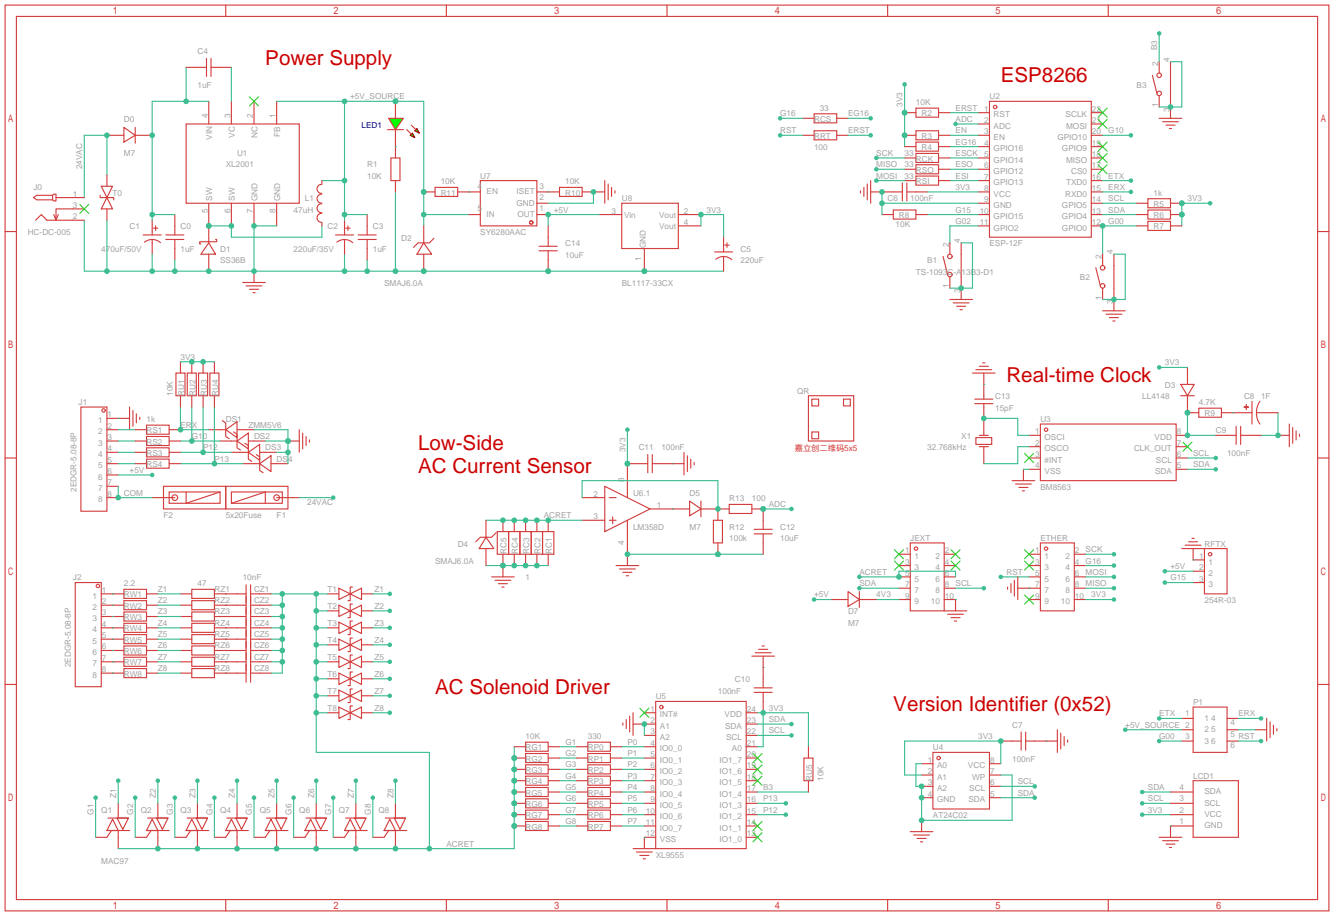
[picture p28: page 1]
