OpenSprinkler/OpenSprinkler-Hardware/OS/3.4/DC/OS34DC_schematic.pdf

# Power Supply

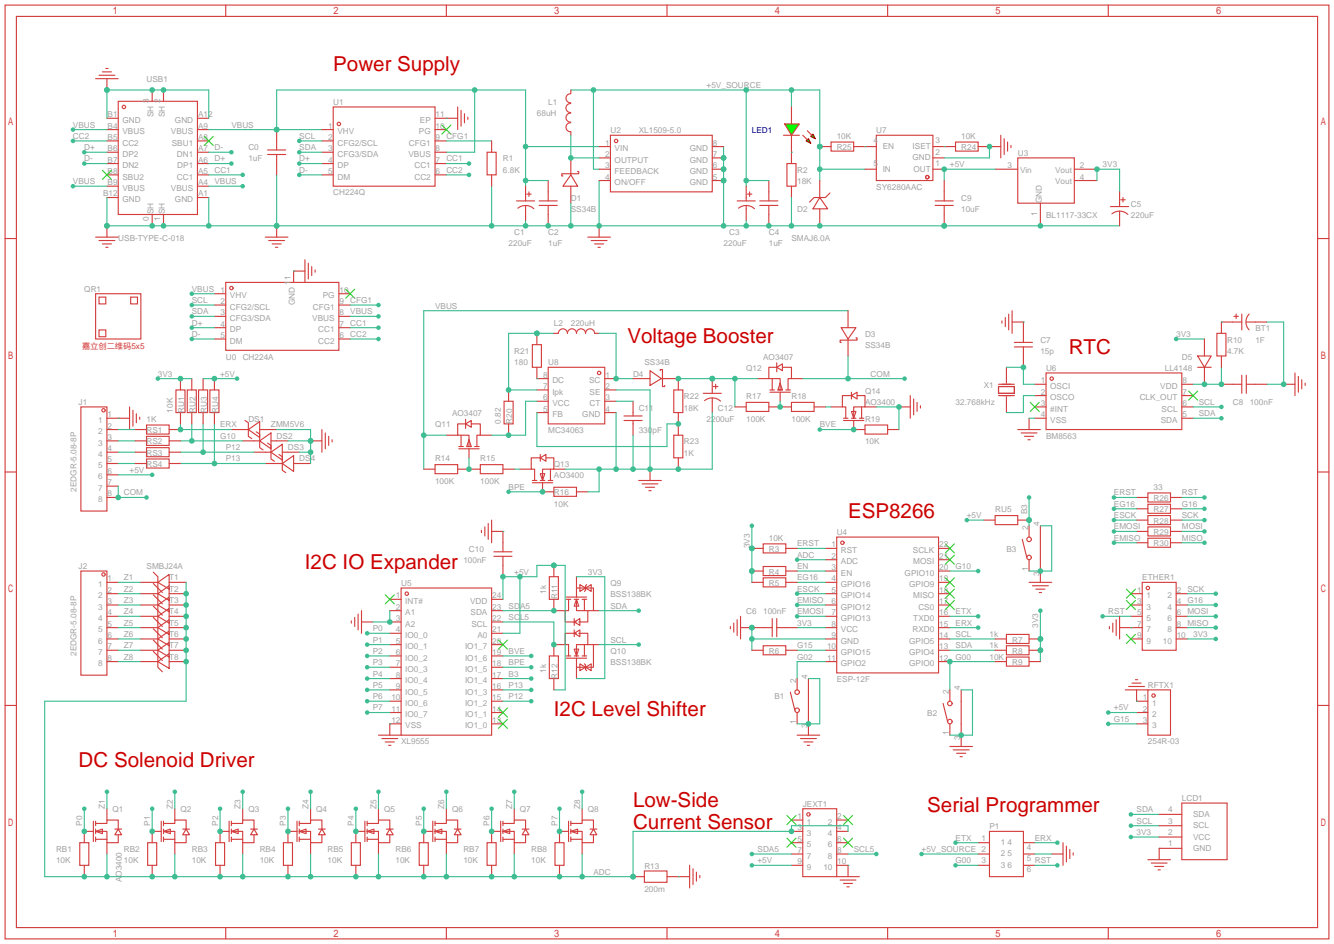
[picture p29: page 1]
