OpenSprinkler/OpenSprinkler-Hardware/OSPi/2.0/ospi20_pcb.pdf

## RFTX

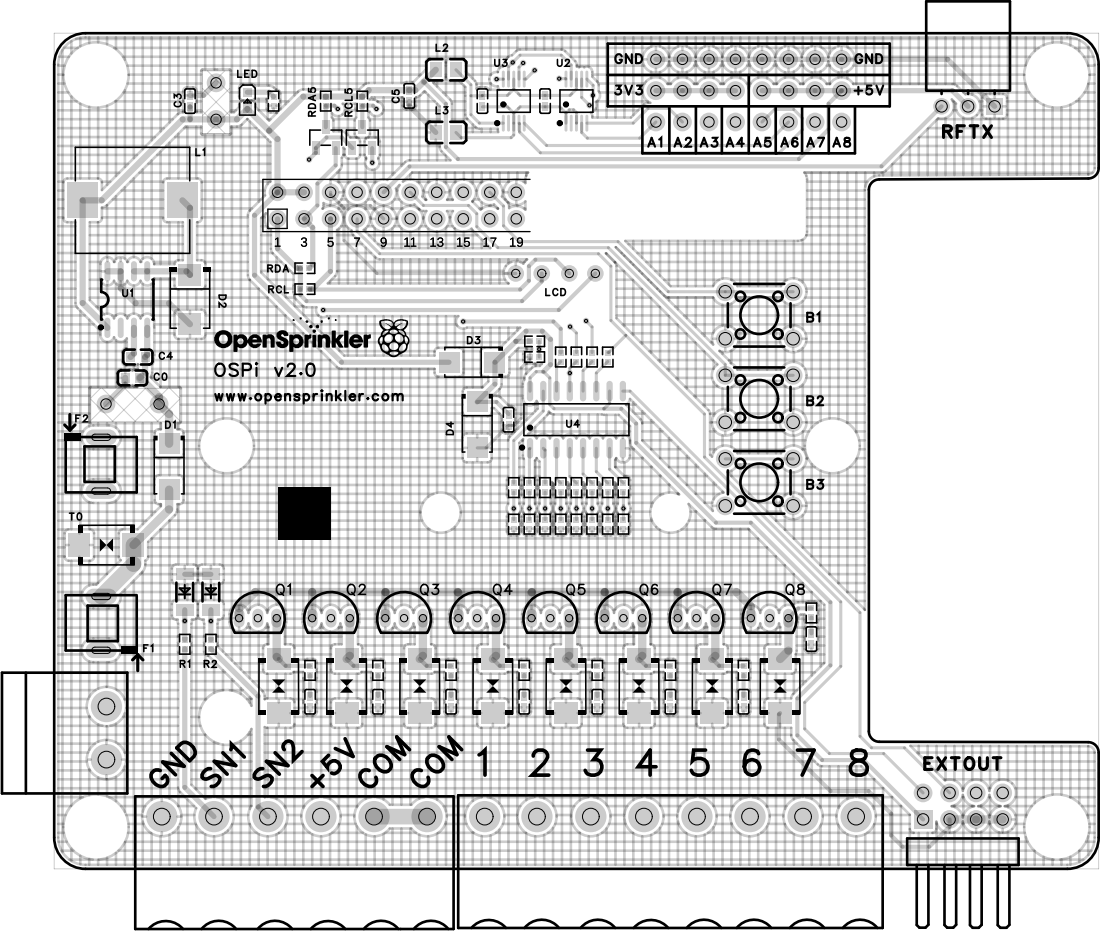
[picture p30: page 1]

GND | GND
3V3 | +5V

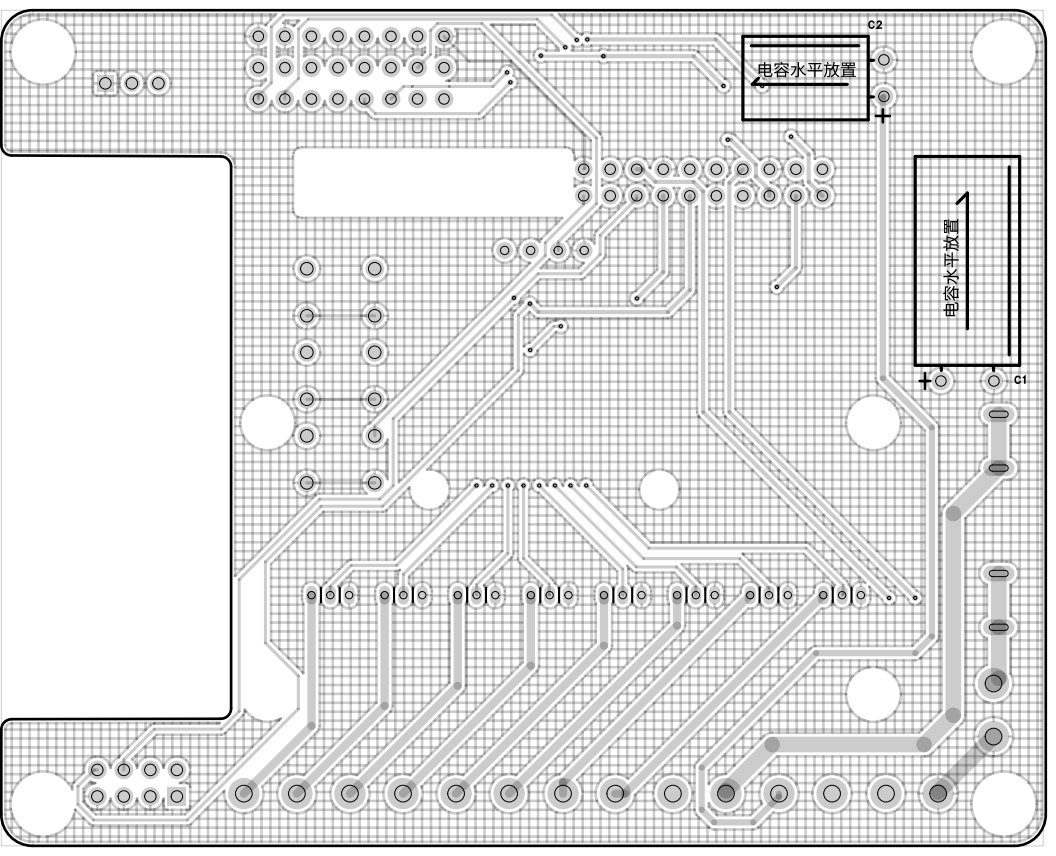
[picture p31: page 2]

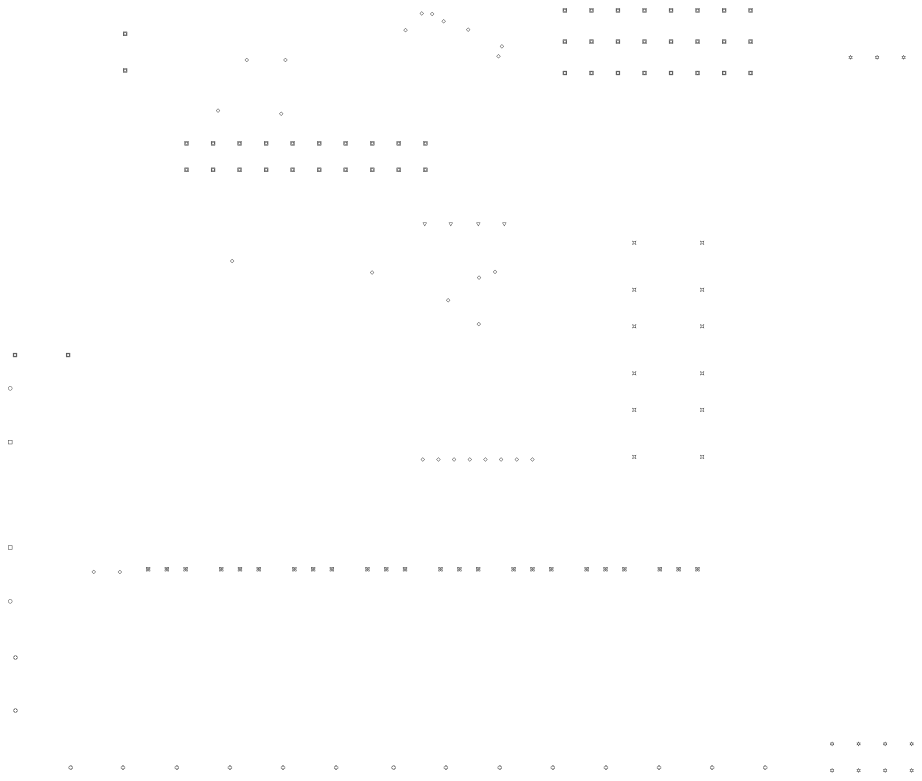
[picture p32: page 3]
