OpenSprinkler/OpenSprinkler-Hardware/OS/3.4/AC/OS34AC_pcb.pdf

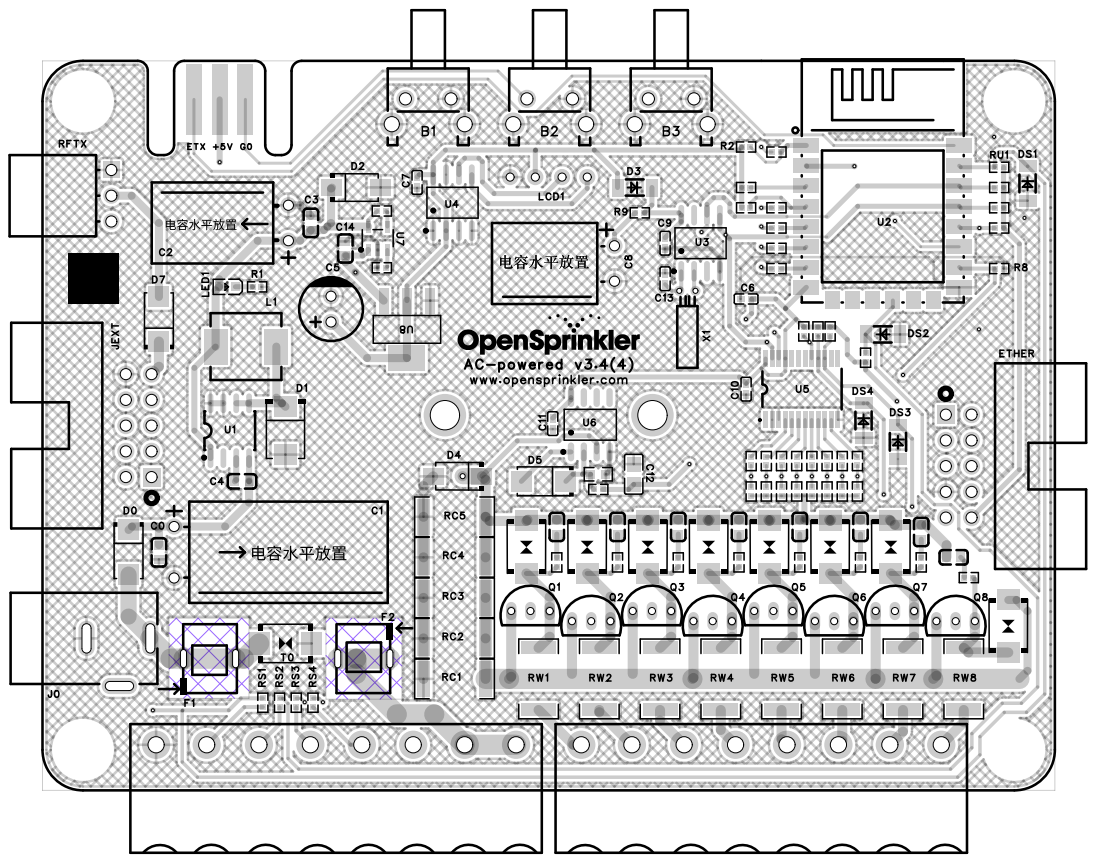
[picture p33: page 1]
