OpenSprinkler/OpenSprinkler-Hardware/OS/3.4/DC/OS34DC_pcb.pdf

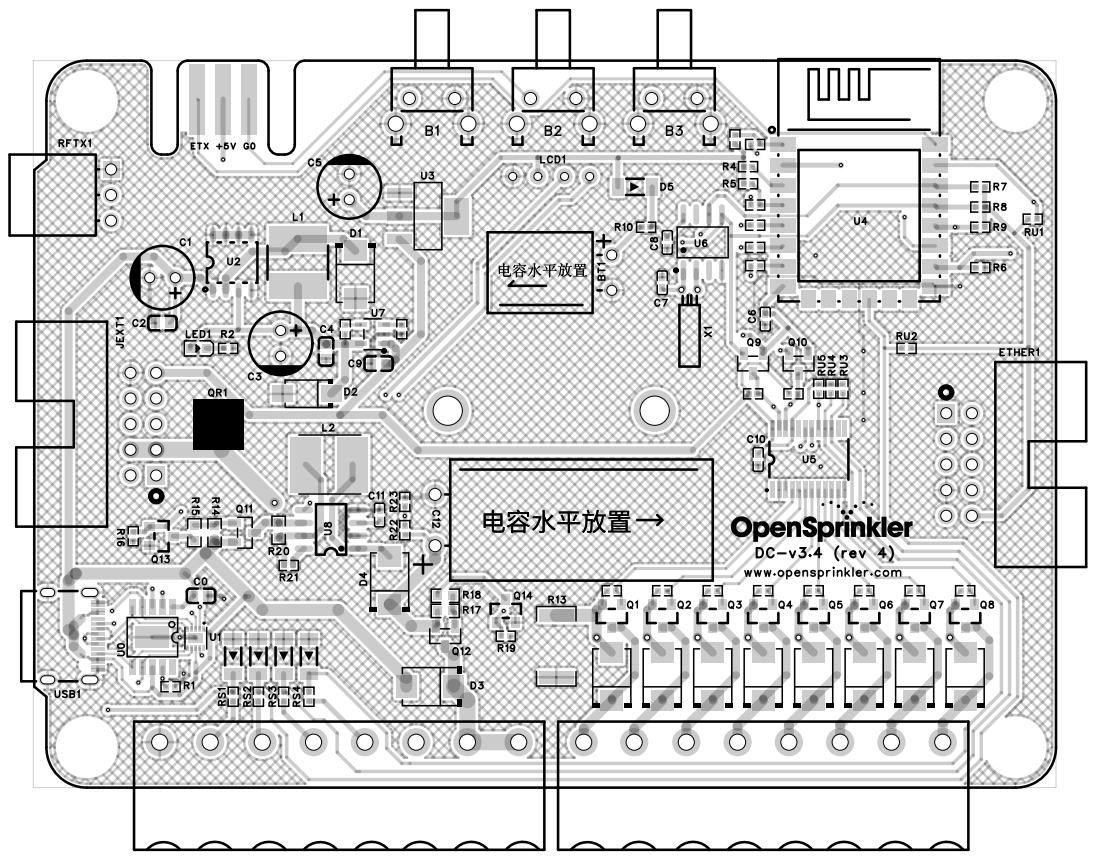
[picture p34: page 1]
