OpenSprinkler/OpenSprinkler-Hardware/OS/3.0-3.3/Master/os32_master.brd

## EAGLE design OS/3.0-3.3/Master/os32_master.brd (2019-06-13)

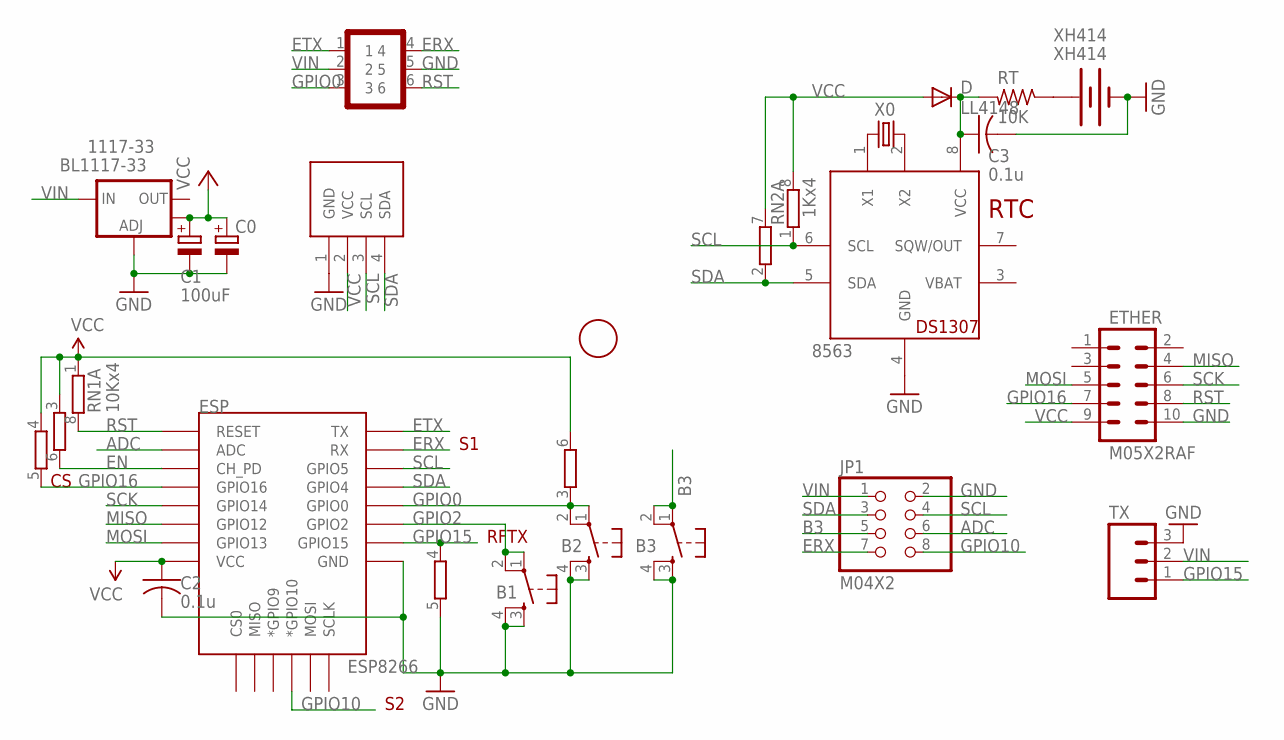
[picture p37: schematic os32_master.sch]

Parts:
1F: FIDUCIAL; FIDUCIAL_1MM
1117-33: BL1117-33; SOT223
8563: PCF8563; SO08
B1, B2, B3: SPST_TACTEVQQ2; EVQ-Q2
C0: CPOL-EUE2.5-5; E2,5-5
C1: 100uF; CT3528
C2, C3: 0.1u; C0603
D: LL4148; MINIMELF
ESP: ESP8266; ESP12E-SMD
ETHER: M05X2RAF; 2X5-RAF
JP1: M04X2; 2X04
LCD: SSD1306_OLED_I2CSMD3; SSD1306_OLED_I2C_SMD3
RN1: 10Kx4; EXB38V
RN2: 1Kx4; EXB38V
RT: 10K; R0603
TX: M03LOCK; 1X03_LOCK
U$3: GOLDFINGER_2X3
X0: 32.768kHz; MM20SS1
XH414: XH414; BATTCON_XH414

Connections:
ADC: ESP.ADC, JP1.6
B3: B3.1, B3.2, JP1.5
EN: ESP.CH_PD, RN1.6 (2)
ERX: ESP.RXD0 (RX), JP1.7, U$3.4
ETX: ESP.TXD0 (TX), U$3.1
GND: 1117-33.1 (ADJ), 8563.4 (GND), B1.3, B1.4, B2.3, B2.4, B3.3, B3.4, C0.-, C1.+ (-), C2.2, C3.2, ESP.GND, ETHER.10, JP1.2, LCD.1 (GND), RN2.5 (2), TX.3, U$3.5, XH414.P$1 (-)
GPIO0: B2.1, B2.2, ESP.GPIO0, RN2.3 (1), U$3.3
GPIO2: B1.1, B1.2, ESP.GPIO2
GPIO10: ESP.GPIO10 (*GPIO10), JP1.8
GPIO15: ESP.GPIO15, RN2.4 (1), TX.1
GPIO16: ESP.GPIO16, ETHER.7, RN1.5 (2)
MISO: ESP.GPIO12, ETHER.4
MOSI: ESP.GPIO13, ETHER.5
unnamed: 8563.1 (X1), X0.1
unnamed: 8563.8 (VCC), C3.1, D.C, RT.2
unnamed: 8563.2 (X2), X0.4 (2)
unnamed: RT.1, XH414.P$2 (+)
RST: ESP.RESET, ETHER.8, RN1.8 (2), U$3.6
SCK: ESP.GPIO14, ETHER.6
SCL: 8563.6 (SCL), ESP.GPIO5, JP1.4, LCD.3 (SCL), RN2.1
SDA: 8563.5 (SDA), ESP.GPIO4, JP1.3, LCD.4 (SDA), RN2.2 (1)
VBAT: 8563.3 (VBAT)
VCC: 1117-33.4 (OUT), C0.+, C1.- (+), C2.1, D.A, ESP.VCC, ETHER.9, LCD.2 (VCC), RN1.1, RN1.3 (1), RN1.4 (1), RN2.6 (2), RN2.7 (2), RN2.8 (2)
VIN: 1117-33.3 (IN), JP1.1, TX.2, U$3.2

Notes on the sheet:
RTC
RFTX

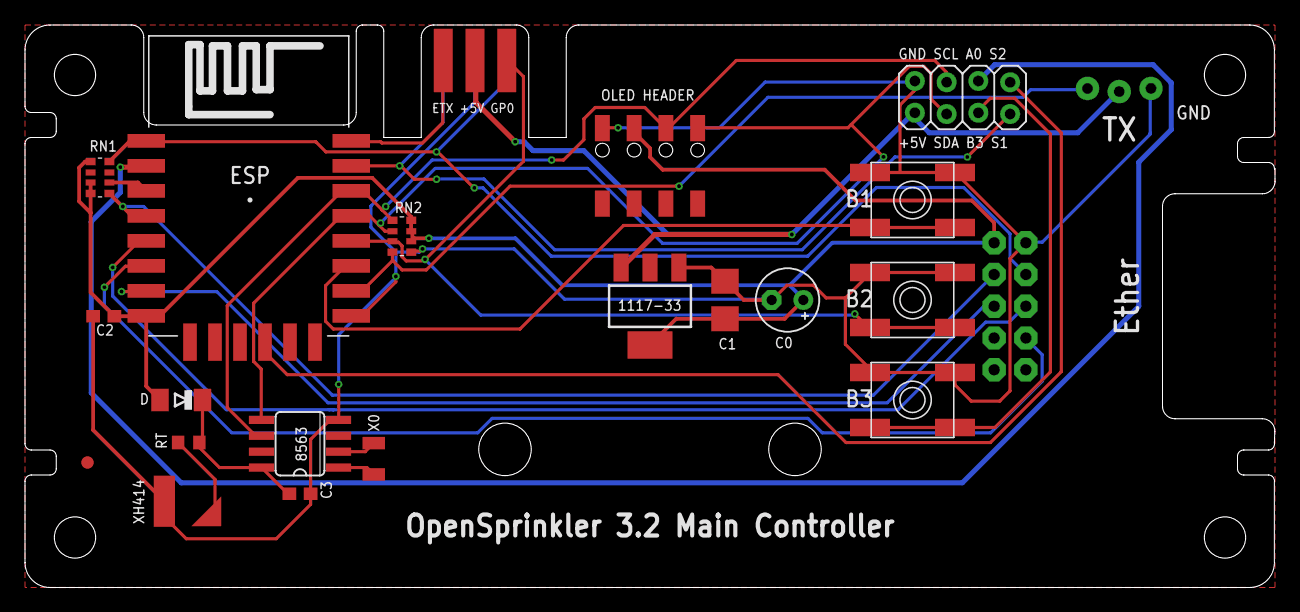
[picture p38: board os32_master.brd from above]

Board: 2 copper layers, 100.0 x 45.0 mm, 22 parts (1 on the bottom side), 23 nets.
