OpenSprinkler/OpenSprinkler-Hardware/OS/3.0-3.3/LA_driver/latdr32.brd

## EAGLE design OS/3.0-3.3/LA_driver/latdr32.brd (2025-05-08)

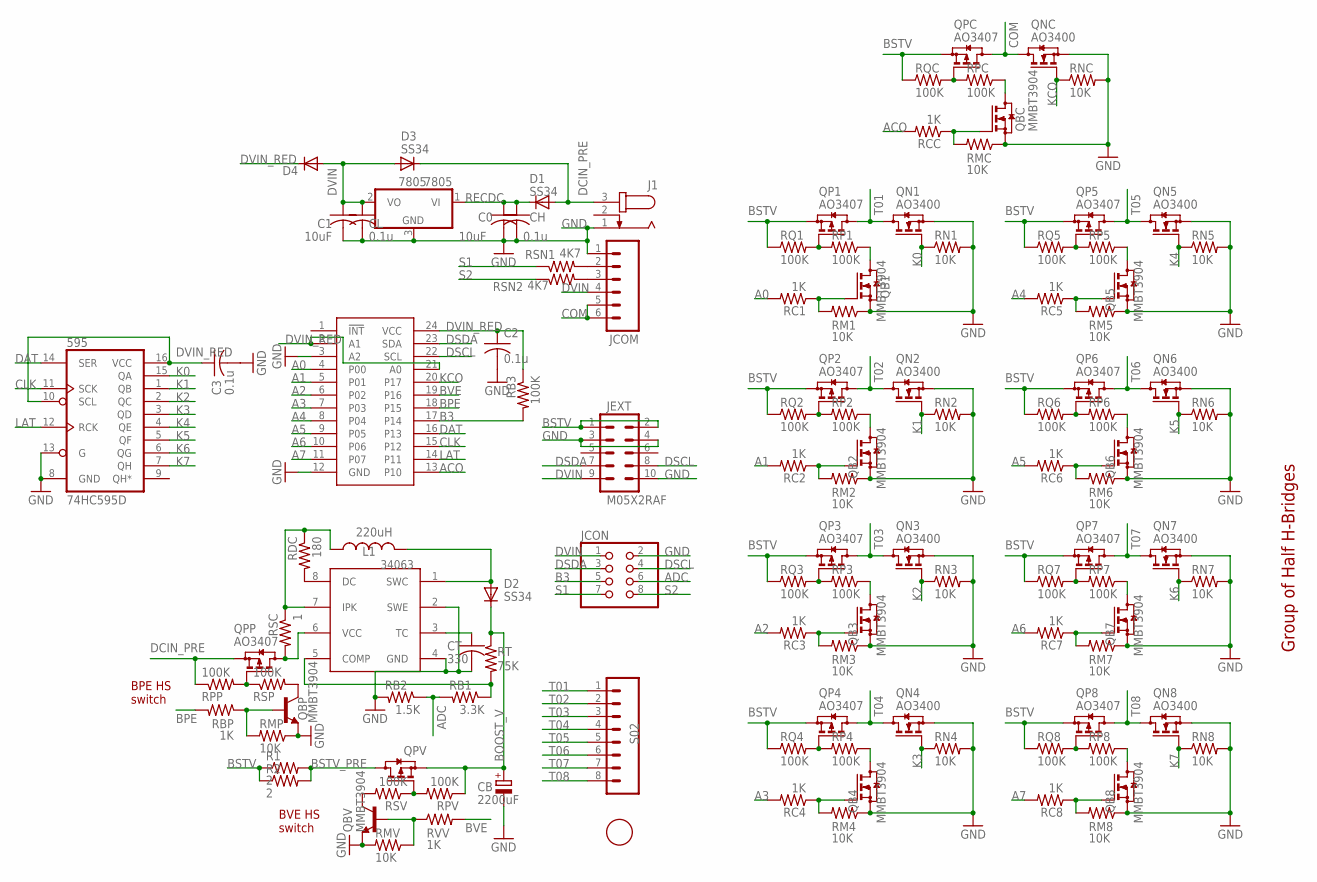
[picture p39: schematic latdr32.sch]

Parts:
1F: FIDUCIAL; FIDUCIAL_1MM
595: 74HC595D; SO16
7805: 7805; TO252
34063: MC34063; SO08
C0, C1: 10uF; C0805K
C2, C3: 0.1u; C0603
CB: 2200uF; E7,5-16
CH: 0.1u; C0603
CL: 0.1u; C0603
CT: 330; C0603K
D1, D2, D3: SS34; SMB
D4: DIODESMA; SMA-DIODE
J1: JACK-PLUG0; SPC4077
JCOM: M065MM; SCREWTERMINAL-5MM-6
JCON: PINHD-2X4; 2X04
JEXT: M05X2RAF; 2X5-RAF
L1: 220uH; CR54
PCA9555: PCA9555; TSSOP24
QB1, QB2, QB3, QB4, QB5, QB6, QB7, QB8: MMBT3904; SOT23
QBC: MMBT3904; SOT23
QBP: MMBT3904; SOT23-3
QBV: MMBT3904; SOT23-3
QN1, QN2, QN3, QN4, QN5, QN6, QN7, QN8: AO3400; SOT23
QNC: AO3400; SOT23
QP1, QP2, QP3, QP4, QP5, QP6, QP7, QP8: AO3407; SOT23
QPC: AO3407; SOT23
QPP: AO3407; SOT23
QPV: AO3407; SOT23
R1, R2: 2; R2512
RB1: 3.3K; R0603
RB2: 1.5K; R0603
RB3: 100K; R0603
RBP: 1K; R0603
RC1, RC2, RC3, RC4, RC5, RC6, RC7, RC8: 1K; R0603
RCC: 1K; R0603
RDC: 180; R0603
RM1, RM2, RM3, RM4, RM5, RM6, RM7, RM8: 10K; R0603
RMC: 10K; R0603
RMP: 10K; R0603
RMV: 10K; R0603
RN1, RN2, RN3, RN4, RN5, RN6, RN7, RN8: 10K; R0603
RNC: 10K; R0603
RP1, RP2, RP3, RP4, RP5, RP6, RP7, RP8: 100K; R0603
RPC: 100K; R0603
RPP: 100K; R0603
RPV: 100K; R0603
RQ1, RQ2, RQ3, RQ4, RQ5, RQ6, RQ7, RQ8: 100K; R0603
RQC: 100K; R0603
RSC: 1; R0603
RSN1, RSN2: 4K7; R0603
RSP: 100K; R0603
RSV: 100K; R0603
RT: 75K; R0603
RVV: 1K; R0603
S02: M085MM-8; SCREWTERMINAL-5MM-8

Connections:
A0: PCA9555.4 (P00), RC1.2
A1: PCA9555.5 (P01), RC2.2
A2: PCA9555.6 (P02), RC3.2
A3: PCA9555.7 (P03), RC4.2
A4: PCA9555.8 (P04), RC5.2
A5: PCA9555.9 (P05), RC6.2
A6: PCA9555.10 (P06), RC7.2
A7: PCA9555.11 (P07), RC8.2
ACO: PCA9555.13 (P10), RCC.2
ADC: JCON.6, RB1.2, RB2.1
B3: JCON.5, PCA9555.17 (P14), RB3.2
BOOST_V: CB.+, D2.C, QPV.2 (S), RPV.1, RT.1
BPE: PCA9555.18 (P15), RBP.2
BSTV: JEXT.1, JEXT.2, QP1.2 (S), QP2.2 (S), QP3.2 (S), QP4.2 (S), QP5.2 (S), QP6.2 (S), QP7.2 (S), QP8.2 (S), QPC.2 (S), R1.1, R2.1, RQ1.1, RQ2.1, RQ3.1, RQ4.1, RQ5.1, RQ6.1, RQ7.1, RQ8.1, RQC.1
BSTV_PRE: QPV.3 (D), R1.2, R2.2
BVE: PCA9555.19 (P16), RVV.2
CLK: 595.11 (SCK), PCA9555.15 (P12)
COM: JCOM.5, JCOM.6, QNC.3 (D), QPC.3 (D)
DAT: 595.14 (SER), PCA9555.16 (P13)
DCIN_PRE: D1.A, D3.C, J1.3, QPP.2 (S), RPP.1
DSCL: JCON.4, JEXT.8, PCA9555.22 (SCL)
DSDA: JCON.3, JEXT.7, PCA9555.23 (SDA)
DVIN: 7805.2 (VO), C1.1, CL.1, D3.A, D4.A, JCOM.4, JCON.1, JEXT.9
DVIN_RED: 595.10 (SCL), 595.16 (VCC), C2.1, C3.1, D4.C, PCA9555.2 (A1), PCA9555.21 (A0), PCA9555.24 (VCC), RB3.1
GND: 595.8 (GND), 595.13 (G), 7805.3 (GND), 34063.2 (SWE), 34063.4 (GND), C0.2, C1.2, C2.2, C3.2, CB.-, CH.2, CL.2, CT.2, J1.1, JCOM.1, JCON.2, JEXT.3, JEXT.4, JEXT.10, PCA9555.3 (A2), PCA9555.12 (GND), QB1.2 (S), QB2.2 (S), QB3.2 (S), QB4.2 (S), QB5.2 (S), QB6.2 (S), QB7.2 (S), QB8.2 (S), QBC.2 (S), QBP.2 (E), QBV.2 (E), QN1.2 (S), QN2.2 (S), QN3.2 (S), QN4.2 (S), QN5.2 (S), QN6.2 (S), QN7.2 (S), QN8.2 (S), QNC.2 (S), RB2.2, RM1.1, RM2.1, RM3.1, RM4.1, RM5.1, RM6.1, RM7.1, RM8.1, RMC.1, RMP.1, RMV.2, RN1.2, RN2.2, RN3.2, RN4.2, RN5.2, RN6.2, RN7.2, RN8.2, RNC.2
K0: 595.15 (QA), QN1.1 (G), RN1.1
K1: 595.1 (QB), QN2.1 (G), RN2.1
K2: 595.2 (QC), QN3.1 (G), RN3.1
K3: 595.3 (QD), QN4.1 (G), RN4.1
K4: 595.4 (QE), QN5.1 (G), RN5.1
K5: 595.5 (QF), QN6.1 (G), RN6.1
K6: 595.6 (QG), QN7.1 (G), RN7.1
K7: 595.7 (QH), QN8.1 (G), RN8.1
KCO: PCA9555.20 (P17), QNC.1 (G), RNC.1
LAT: 595.12 (RCK), PCA9555.14 (P11)
unnamed: 34063.1 (SWC), D2.A, L1.P$2 (2)
unnamed: JCOM.2, RSN1.2
unnamed: JCOM.3, RSN2.2
unnamed: QBC.3 (D), RPC.1
unnamed: QB1.3 (D), RP1.1
unnamed: QB2.1 (G), RC2.1, RM2.2
unnamed: QBC.1 (G), RCC.1, RMC.2
unnamed: QB5.3 (D), RP5.1
unnamed: QB2.3 (D), RP2.1
unnamed: QB3.3 (D), RP3.1
unnamed: QB1.1 (G), RC1.1, RM1.2
unnamed: QB4.1 (G), RC4.1, RM4.2
unnamed: QB3.1 (G), RC3.1, RM3.2
unnamed: QB6.3 (D), RP6.1
unnamed: QB7.3 (D), RP7.1
unnamed: QB4.3 (D), RP4.1
unnamed: 34063.3 (TC), CT.1
unnamed: QB8.3 (D), RP8.1
unnamed: QB5.1 (G), RC5.1, RM5.2
unnamed: QB6.1 (G), RC6.1, RM6.2
unnamed: 34063.8 (DC), RDC.2
unnamed: 34063.7 (IPK), L1.P$1 (1), RDC.1, RSC.1
unnamed: 34063.6 (VCC), QPP.3 (D), RSC.2
unnamed: QBP.1 (B), RBP.1, RMP.2
unnamed: 34063.5 (COMP), RB1.1, RT.2
unnamed: QPP.1 (G), RPP.2, RSP.1
unnamed: QB7.1 (G), RC7.1, RM7.2
unnamed: QBV.3 (C), RSV.2
unnamed: QBP.3 (C), RSP.2
unnamed: QPV.1 (G), RPV.2, RSV.1
unnamed: QB8.1 (G), RC8.1, RM8.2
unnamed: QBV.1 (B), RMV.1, RVV.1
unnamed: QPC.1 (G), RPC.2, RQC.2
unnamed: QP1.1 (G), RP1.2, RQ1.2
unnamed: QP2.1 (G), RP2.2, RQ2.2
unnamed: QP3.1 (G), RP3.2, RQ3.2
unnamed: QP4.1 (G), RP4.2, RQ4.2
unnamed: QP5.1 (G), RP5.2, RQ5.2
unnamed: QP6.1 (G), RP6.2, RQ6.2
unnamed: QP7.1 (G), RP7.2, RQ7.2
unnamed: QP8.1 (G), RP8.2, RQ8.2
RECDC: 7805.1 (VI), C0.1, CH.1, D1.C
S1: JCON.7, RSN1.1
S2: JCON.8, RSN2.1
T01: QN1.3 (D), QP1.3 (D), S02.1
T02: QN2.3 (D), QP2.3 (D), S02.2
T03: QN3.3 (D), QP3.3 (D), S02.3
T04: QN4.3 (D), QP4.3 (D), S02.4
T05: QN5.3 (D), QP5.3 (D), S02.5
T06: QN6.3 (D), QP6.3 (D), S02.6
T07: QN7.3 (D), QP7.3 (D), S02.7
T08: QN8.3 (D), QP8.3 (D), S02.8

Notes on the sheet:
BPE HS switch
BVE HS switch
Group of Half H-Bridges

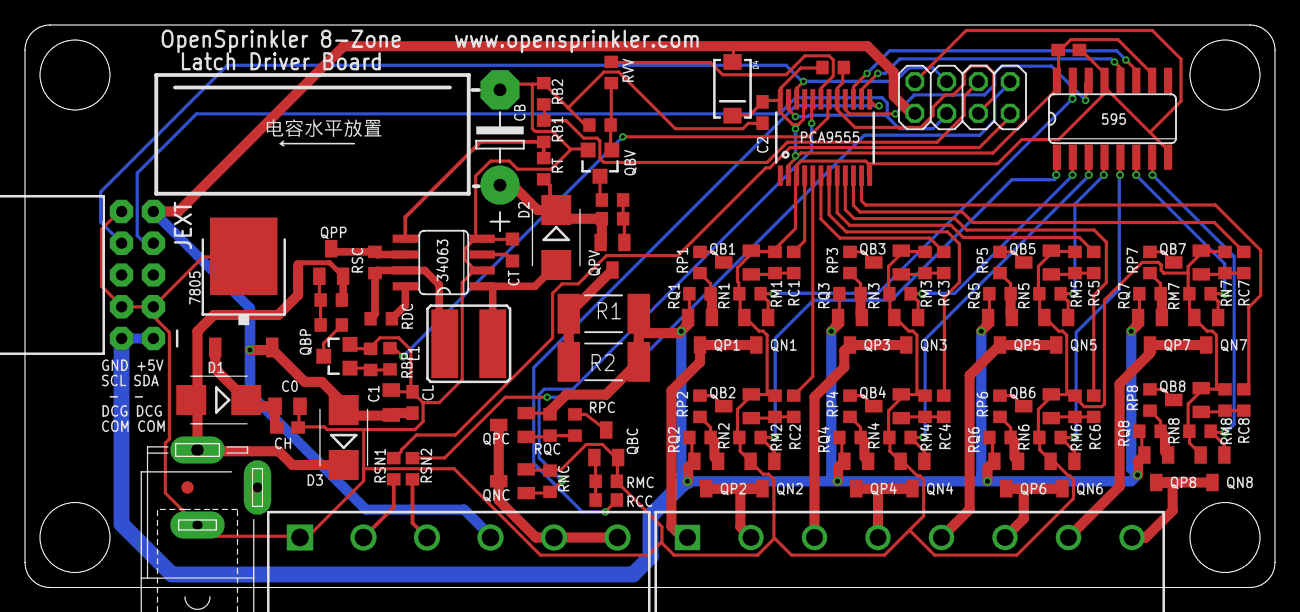
[picture p40: board latdr32.brd from above]

Board: 2 copper layers, 100.0 x 45.0 mm, 117 parts (0 on the bottom side), 87 nets.
