OpenSprinkler/OpenSprinkler-Hardware/OS/3.0-3.3/Master/os30_master.brd

## EAGLE design OS/3.0-3.3/Master/os30_master.brd (2017-06-06)

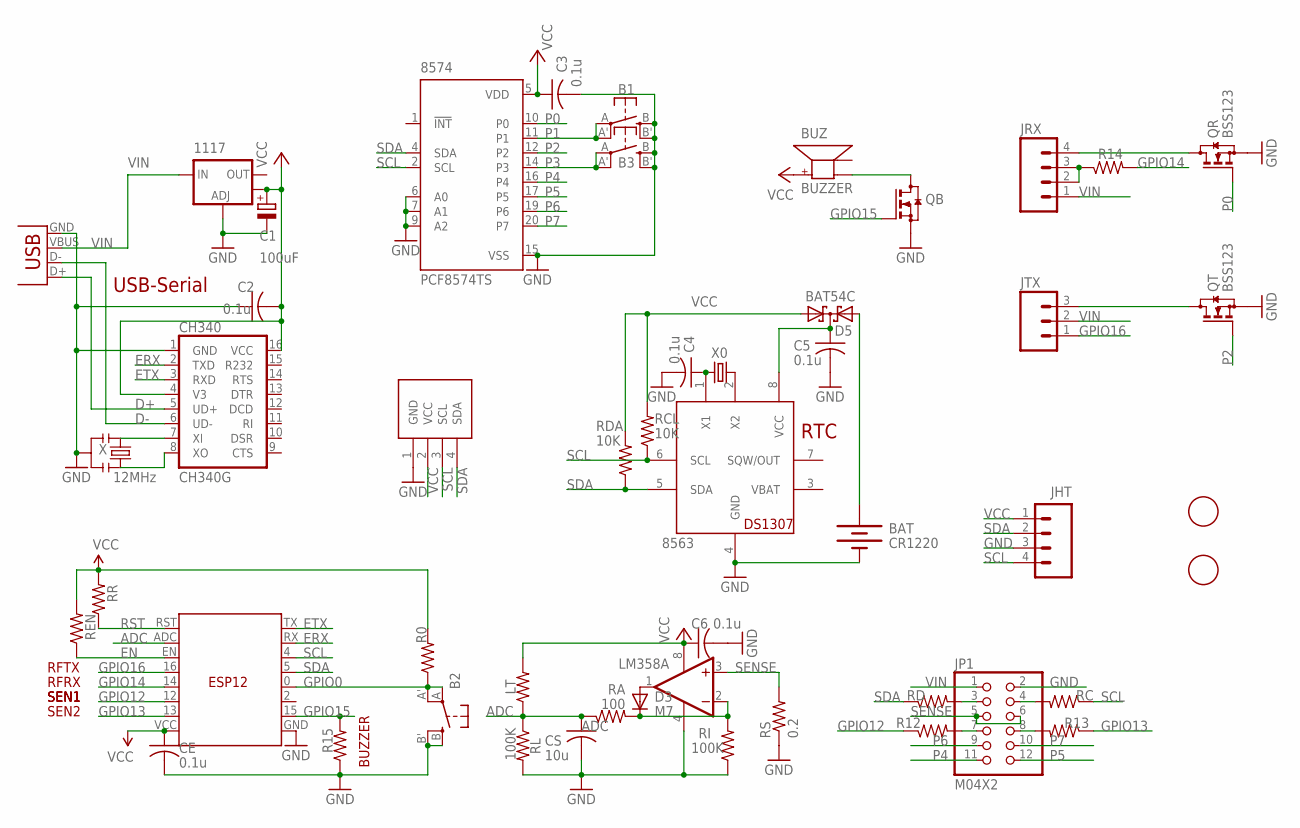
[picture p41: schematic os30_master.sch]

Parts:
1117: V_REG_LM1117SOT223; SOT223
8563: PCF8563; SO08
8574: PCF8574TS; SSOP20
B1, B2, B3: SPST_TACT-EVQQ2; EVQ-Q2
BAT: CR1220; BATTCON_12MM_SMT
BUZ: BUZZER; SMT-8585-BUZZER
C1: 100uF; PANASONIC_D
C2, C3, C4, C5, C6: 0.1u; C0603
CE: 0.1u; C0603
CH340: CH340G; SO16
CS: 10u; C0805K
D3: M7; DO-214AC
D5: BAT54C; SOT23
ESP: ESP; ESP12_WES
JHT: M04NARROW; 1X04-NARROW
JP1: M04X2; 2X06
JRX: M04PTH; 1X04
JTX: M03PTH; 1X03
LCD: SSD1306_OLED_I2CSMD3; SSD1306_OLED_I2C_SMD3
LM358: OP262D; SO08
LT: 100K; R1206
QB: AO3400; SOT23
QR: BSS123; SOT23
QT: BSS123; SOT23
R0: 10k; R0603
R12, R13: 4.7k; R0603
R14: 1K; R0603
R15: 10K; R0603
RA: 100; R0603
RC: 4.7k; R0603
RCL: 10K; R0603
RD: 330; R0603
RDA: 10K; R0603
REN: 10k; R0603
RI: 100K; R0603
RL: 100K; R0603
RR: 10k; R0603
RS: 0.2; R2512
U$1, U$2: FIDUCIAL; FIDUCIAL_1MM
USB: USBMICROB2; USB-MICROB2
X: 12MHz; RESONATOR-SMD
X0: 32.768kHz; MM20SS1

Connections:
ADC: CS.1, ESP.ADC, LT.1, RA.1, RL.1
D+: CH340.5 (UD+), USB.D+
D-: CH340.6 (UD-), USB.D-
EN: ESP.EN, REN.1
ERX: CH340.2 (TXD), ESP.RX
ETX: CH340.3 (RXD), ESP.TX
GND: 1117.1 (ADJ), 8563.4 (GND), 8574.6 (A0), 8574.7 (A1), 8574.9 (A2), 8574.15 (VSS), B1.B (S), B1.B' (S1), B2.B (S), B2.B' (S1), B3.B (S), B3.B' (S1), BAT.P$1 (-), C1.-, C2.1, C3.2, C4.2, C5.2, C6.2, CE.2, CH340.1 (GND), CS.2, ESP.GND, JHT.3, JP1.2, LCD.1 (GND), LM358.4 (V-), QB.2 (S), QR.2 (S), QT.2 (S), R15.1, RI.1, RL.2, RS.1, USB.GND, X.2
GPIO0: B2.A, B2.A' (P1), ESP.0 (G0), R0.1
GPIO12: ESP.12 (G12), R12.1
GPIO13: ESP.13 (G13), R13.1
GPIO14: ESP.14 (G14), R14.2
GPIO15: ESP.15 (G15), QB.1 (G), R15.2
GPIO16: ESP.16 (G16), JTX.1
unnamed: 8563.1 (X1), C4.1, X0.1
unnamed: BUZ.-, QB.3 (D)
unnamed: JP1.3, RD.2
unnamed: JP1.4, RC.2
unnamed: JP1.7, R12.2
unnamed: JP1.8, R13.2
unnamed: D3.C, LM358.2 (-IN), RA.2, RI.2
unnamed: 8563.8 (VCC), C5.1, D5.3 (CC)
unnamed: CH340.7 (XI), X.1
unnamed: JRX.2, JRX.3, R14.1
unnamed: JTX.3, QT.3 (D)
unnamed: JRX.4, QR.3 (D)
unnamed: 8563.2 (X2), X0.4 (2)
unnamed: BAT.P$2 (+), D5.2 (A2)
unnamed: CH340.8 (XO), X.3
unnamed: D3.A, LM358.1 (OUT)
P0: 8574.10 (P0), QR.1 (G)
P1: 8574.11 (P1), B1.A, B1.A' (P1)
P2: 8574.12 (P2), QT.1 (G)
P3: 8574.14 (P3), B3.A, B3.A' (P1)
P4: 8574.16 (P4), JP1.11
P5: 8574.17 (P5), JP1.12
P6: 8574.19 (P6), JP1.9
P7: 8574.20 (P7), JP1.10
RST: ESP.RST, RR.1
SCL: 8563.6 (SCL), 8574.2 (SCL), ESP.4 (G4), JHT.4, LCD.3 (SCL), RC.1, RCL.1
SDA: 8563.5 (SDA), 8574.4 (SDA), ESP.5 (G5), JHT.2, LCD.4 (SDA), RD.1, RDA.1
SENSE: JP1.5, JP1.6, LM358.3 (+IN), RS.2
VBAT: 8563.3 (VBAT)
VCC: 1117.4 (OUT), 8574.5 (VDD), BUZ.+, C1.+, C2.2, C3.1, C6.1, CE.1, CH340.4 (V3), CH340.16 (VCC), D5.1 (A1), ESP.VCC, JHT.1, LCD.2 (VCC), LM358.8 (V+), LT.2, R0.2, RCL.2, RDA.2, REN.2, RR.2
VIN: 1117.3 (IN), JP1.1, JRX.1, JTX.2, USB.VBUS

Notes on the sheet:
RTC
USB-Serial
SEN1
SEN2
RFRX
BUZZER
RFTX

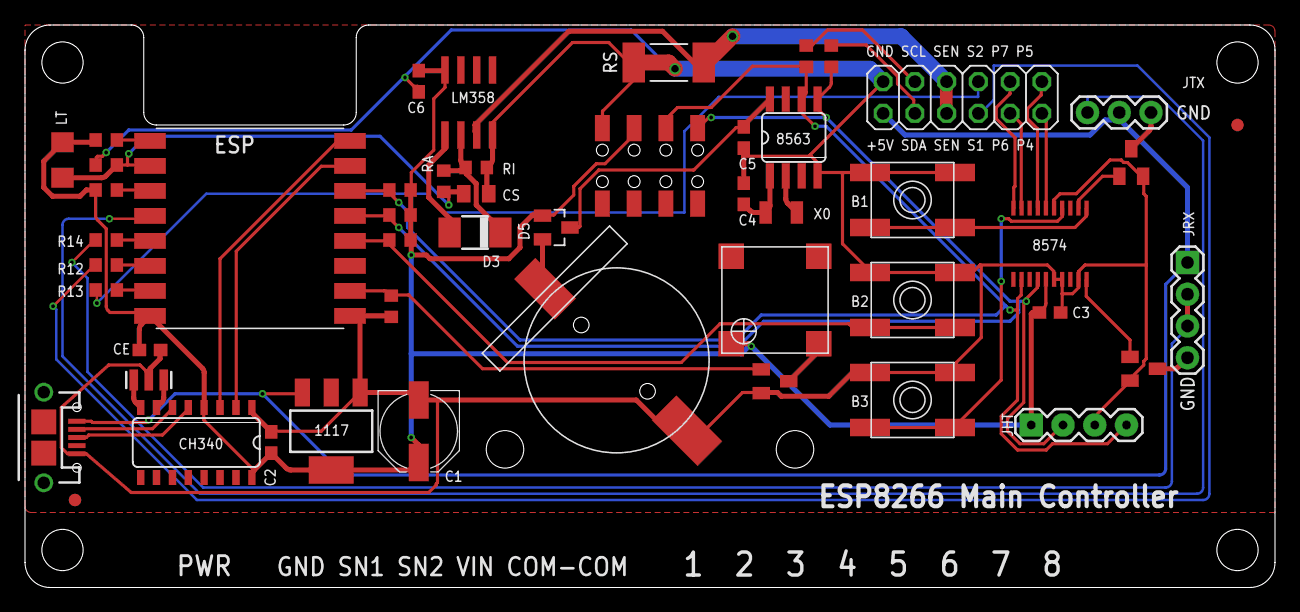
[picture p42: board os30_master.brd from above]

Board: 2 copper layers, 100.0 x 45.0 mm, 50 parts (0 on the bottom side), 43 nets.
