OpenSprinkler/OpenSprinkler-Hardware/OS/3.0-3.3/Master/os33_master.brd

## EAGLE design OS/3.0-3.3/Master/os33_master.brd (2023-12-19)

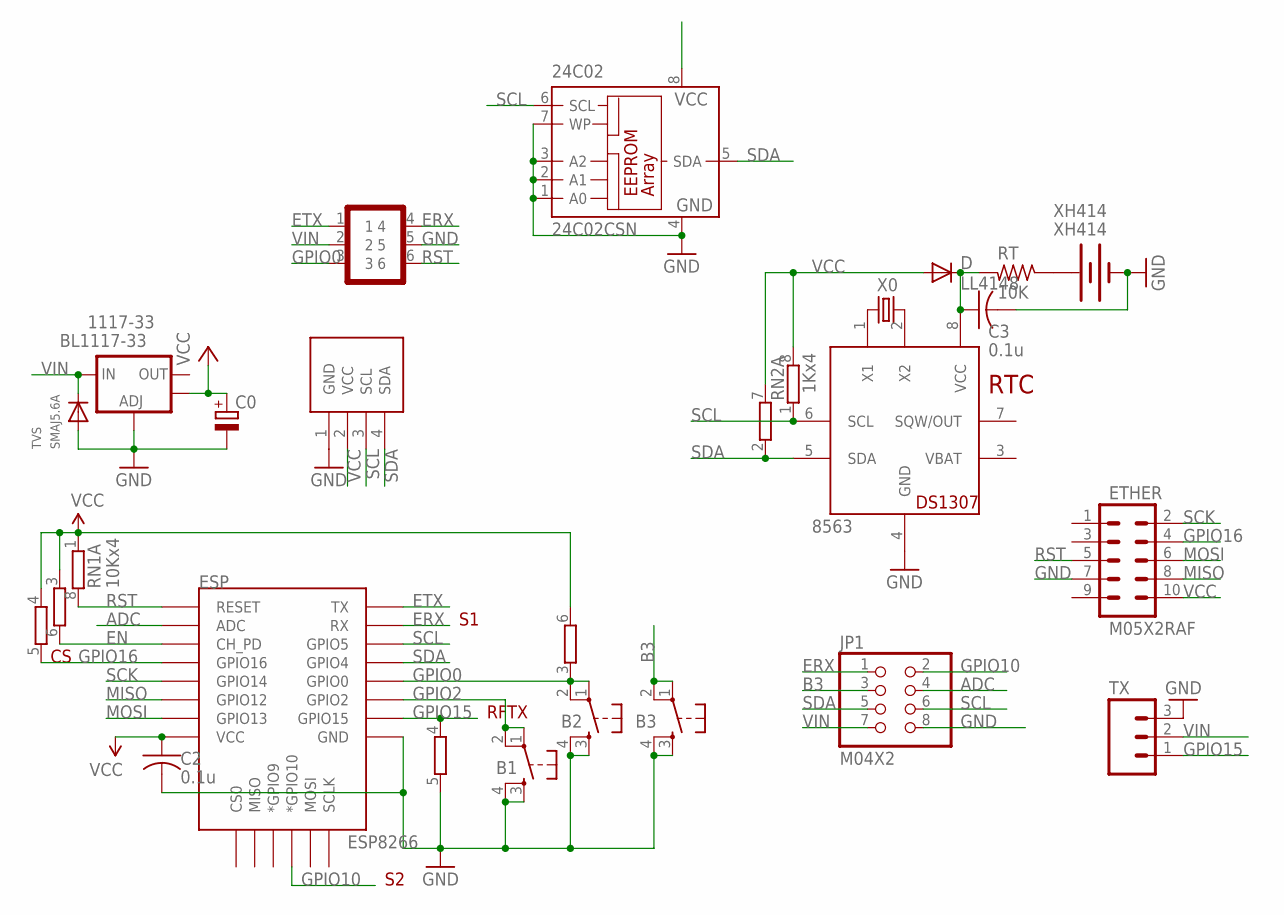
[picture p43: schematic os33_master.sch]

Parts:
24C02: 24C02CSN; SO-08
1117-33: BL1117-33; SOT223
8563: PCF8563; SO08
B1, B2, B3: SPST_TACTEVQQ2; EVQ-Q2
C0: CPOL-EUC; PANASONIC_C
C2, C3: 0.1u; C0603
D: LL4148; MINIMELF
ESP: ESP8266; ESP12E-SMD
ETHER: M05X2RAF; 2X5-RAF
JP1: M04X2; 2X04
LCD: SSD1306_OLED_I2CPCB0.75BB; SSD1306_OLED_I2C_PCB_0.75BB
RN1: 10Kx4; EXB38V
RN2: 1Kx4; EXB38V
RT: 10K; R0603
TVS: SMAJ5.6A; SMADIODE
TX: M03LOCK; 1X03_LOCK
U$3: GOLDFINGER_2X3
X0: 32.768kHz; TC26H
XH414: XH414; BATTCON_XH414

Connections:
ADC: ESP.ADC, JP1.4
B3: B3.1, B3.2, JP1.3
EN: ESP.CH_PD, RN1.6 (2)
ERX: ESP.RXD0 (RX), JP1.1, U$3.4
ETX: ESP.TXD0 (TX), U$3.1
GND: 24C02.1 (A0), 24C02.2 (A1), 24C02.3 (A2), 24C02.4 (GND), 24C02.7 (WP), 1117-33.1 (ADJ), 8563.4 (GND), B1.3, B1.4, B2.3, B2.4, B3.3, B3.4, C0.-, C2.2, C3.2, ESP.GND, ETHER.7, JP1.8, LCD.1 (GND), RN2.5 (2), TVS.A, TX.3, U$3.5, XH414.P$1 (-)
GPIO0: B2.1, B2.2, ESP.GPIO0, RN2.3 (1), U$3.3
GPIO2: B1.1, B1.2, ESP.GPIO2
GPIO10: ESP.GPIO10 (*GPIO10), JP1.2
GPIO15: ESP.GPIO15, RN2.4 (1), TX.1
GPIO16: ESP.GPIO16, ETHER.4, RN1.5 (2)
MISO: ESP.GPIO12, ETHER.8
MOSI: ESP.GPIO13, ETHER.6
unnamed: 8563.1 (X1), X0.2
unnamed: 8563.2 (X2), X0.1
unnamed: 8563.8 (VCC), C3.1, D.C, RT.2
unnamed: RT.1, XH414.P$2 (+)
RST: ESP.RESET, ETHER.5, RN1.8 (2), U$3.6
SCK: ESP.GPIO14, ETHER.2
SCL: 24C02.6 (SCL), 8563.6 (SCL), ESP.GPIO5, JP1.6, LCD.3 (SCL), RN2.1
SDA: 24C02.5 (SDA), 8563.5 (SDA), ESP.GPIO4, JP1.5, LCD.4 (SDA), RN2.2 (1)
VBAT: 8563.3 (VBAT)
VCC: 24C02.8 (VCC), 1117-33.4 (OUT), C0.+, C2.1, D.A, ESP.VCC, ETHER.10, LCD.2 (VCC), RN1.1, RN1.3 (1), RN1.4 (1), RN2.6 (2), RN2.7 (2), RN2.8 (2)
VIN: 1117-33.3 (IN), JP1.7, TVS.C, TX.2, U$3.2

Notes on the sheet:
RTC
RFTX

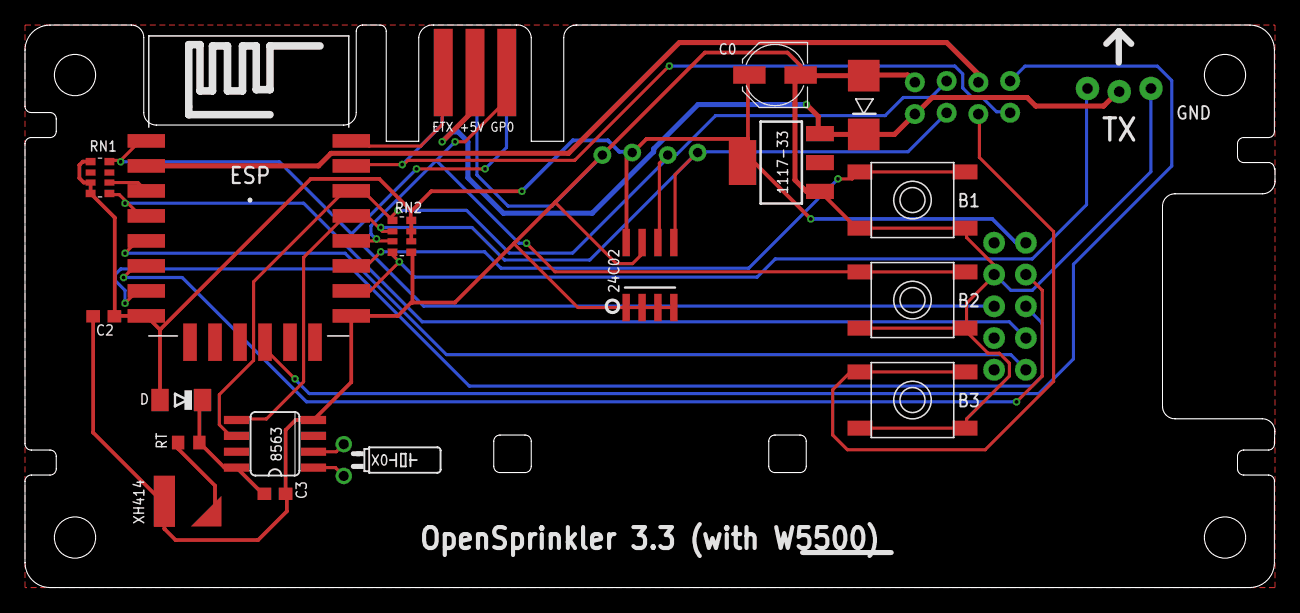
[picture p44: board os33_master.brd from above]

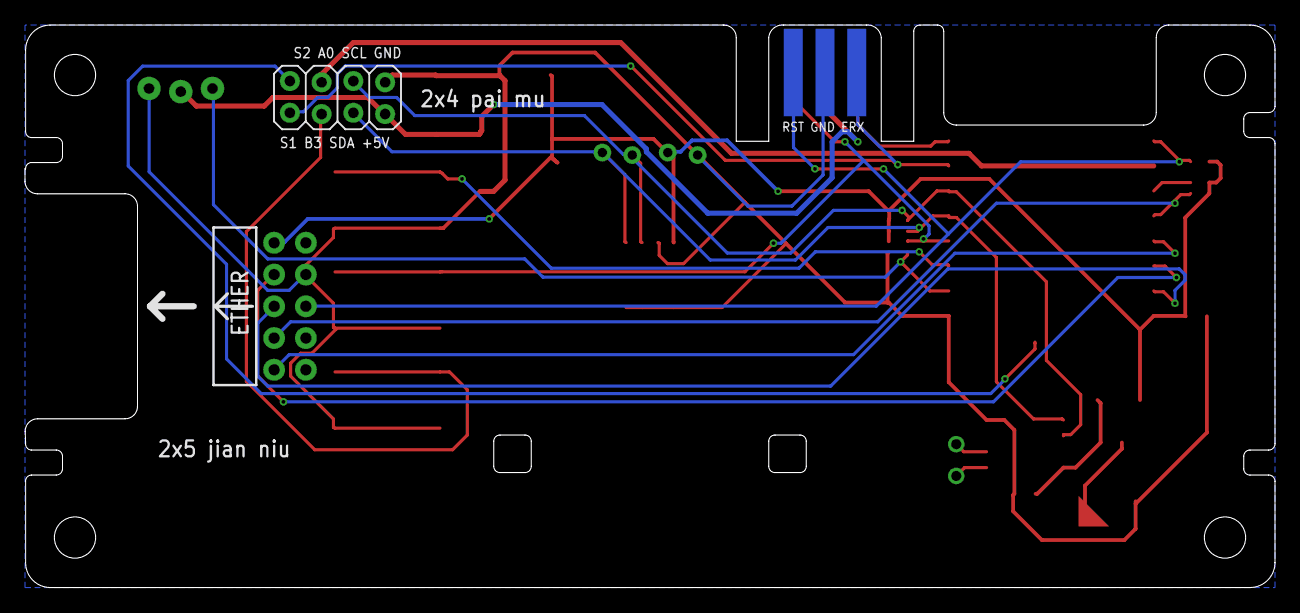
[picture p45: board os33_master.brd from below]

Board: 2 copper layers, 100.0 x 45.0 mm, 22 parts (2 on the bottom side), 23 nets.
