OpenSprinkler/OpenSprinkler-Hardware/OS/3.0-3.3/DC_driver/dcdr_3.2.brd

## EAGLE design OS/3.0-3.3/DC_driver/dcdr_3.2.brd (2021-10-09)

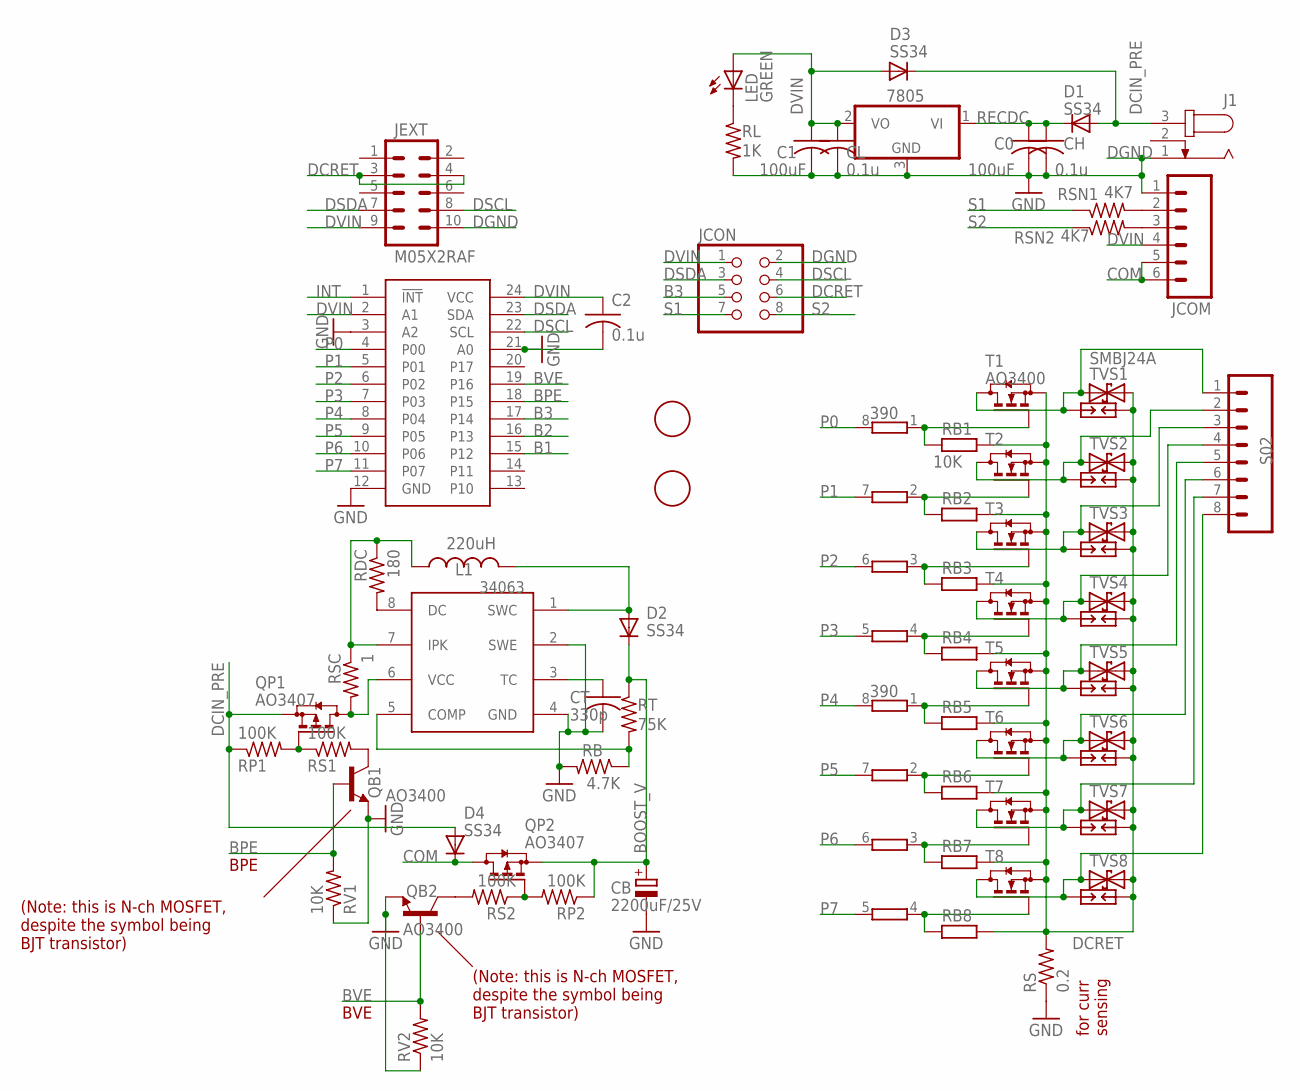
[picture p46: schematic dcdr_3.2.sch]

Parts:
7805: 7805DT; TO252
34063: MC34063; SO08
C0, C1: 100uF; C0805K
C2: 0.1u; C0603
CB: 2200uF/25V; E7,5-16
CH: 0.1u; C0603
CL: 0.1u; C0603
CT: 330p; C0603K
D1, D2, D3, D4: SS34; SMB
J1: JACK-PLUG0; SPC4077
JCOM: M065MM; SCREWTERMINAL-5MM-6
JCON: PINHD-2X4; 2X04
JEXT: M05X2RAF; 2X5-RAF
L1: 220uH; CR54
LED: GREEN; CHIPLED_0805
PCA9555: PCA9555; TSSOP24
QB1, QB2: AO3400; SOT23-3
QP1, QP2: AO3407; SOT23
RB: 4.7K; R0603
RB1, RB2, RB3, RB4, RB5, RB6, RB7, RB8: 10K; R0603
RDC: 180; R0603
RL: 1K; R0603
RN1, RN2: 390; EXB38V
RP1, RP2: 100K; R0603
RS: 0.2; R2512
RS1, RS2: 100K; R0603
RSC: 1; R0603
RSN1, RSN2: 4K7; R0603
RT: 75K; R0603
RV1, RV2: 10K; R0603
S02: M085MM-8; SCREWTERMINAL-5MM-8
SP1, SP2, SP3, SP4, SP5, SP6, SP7, SP8: PCB-SGAP
T1, T2, T3, T4, T5, T6, T7, T8: AO3400; SOT23
TVS1, TVS2, TVS3, TVS4, TVS5, TVS6, TVS7, TVS8: SMBJ24A; SMB
U$1, U$2: FIDUCIAL; FIDUCIAL_1MM

Connections:
B1: PCA9555.15 (P12)
B2: PCA9555.16 (P13)
B3: JCON.5, PCA9555.17 (P14)
BOOST_V: CB.+, D2.C, QP2.2 (S), RP2.1, RT.1
BPE: PCA9555.18 (P15), QB1.1 (B), RV1.2
BVE: PCA9555.19 (P16), QB2.1 (B), RV2.2
COM: D4.C, JCOM.5, JCOM.6, QP2.3 (D)
DCIN_PRE: D1.A, D3.C, D4.A, J1.3, QP1.2 (S), RP1.1
DCRET: JCON.6, JEXT.3, JEXT.4, RB1.1, RB2.1, RB3.1, RB4.1, RB5.1, RB6.1, RB7.1, RB8.1, RS.2, SP1.1, SP2.1, SP3.1, SP4.1, SP5.1, SP6.1, SP7.1, SP8.1, T1.2 (S), T2.2 (S), T3.2 (S), T4.2 (S), T5.2 (S), T6.2 (S), T7.2 (S), T8.2 (S), TVS1.C, TVS2.C, TVS3.C, TVS4.C, TVS5.C, TVS6.C, TVS7.C, TVS8.C
DGND: 7805.3 (GND), 34063.2 (SWE), 34063.4 (GND), C0.2, C1.2, C2.2, CB.-, CH.2, CL.2, CT.2, J1.1, JCOM.1, JCON.2, JEXT.10, PCA9555.3 (A2), PCA9555.12 (GND), PCA9555.21 (A0), QB1.2 (E), QB2.2 (E), RB.2, RL.2, RS.1, RV1.1, RV2.1
DSCL: JCON.4, JEXT.8, PCA9555.22 (SCL)
DSDA: JCON.3, JEXT.7, PCA9555.23 (SDA)
DVIN: 7805.2 (VO), C1.1, C2.1, CL.1, D3.A, JCOM.4, JCON.1, JEXT.9, LED.A, PCA9555.2 (A1), PCA9555.24 (VCC)
INT: PCA9555.1 (!INT)
unnamed: 34063.1 (SWC), D2.A, L1.P$2 (2)
unnamed: JCOM.2, RSN1.2
unnamed: JCOM.3, RSN2.2
unnamed: RB1.2, RN1.1, T1.1 (G)
unnamed: RB2.2, RN1.2 (1), T2.1 (G)
unnamed: RB3.2, RN1.3 (1), T3.1 (G)
unnamed: RB4.2, RN1.4 (1), T4.1 (G)
unnamed: 34063.3 (TC), CT.1
unnamed: RB5.2, RN2.1, T5.1 (G)
unnamed: RB6.2, RN2.2 (1), T6.1 (G)
unnamed: RB7.2, RN2.3 (1), T7.1 (G)
unnamed: RB8.2, RN2.4 (1), T8.1 (G)
unnamed: 34063.8 (DC), RDC.2
unnamed: 34063.7 (IPK), L1.P$1 (1), RDC.1, RSC.1
unnamed: 34063.6 (VCC), QP1.3 (D), RSC.2
unnamed: LED.C, RL.1
unnamed: 34063.5 (COMP), RB.1, RT.2
unnamed: QP1.1 (G), RP1.2, RS1.1
unnamed: QB2.3 (C), RS2.2
unnamed: QB1.3 (C), RS1.2
unnamed: QP2.1 (G), RP2.2, RS2.1
unnamed: S02.1, SP1.2, T1.3 (D), TVS1.A
unnamed: S02.2, SP2.2, T2.3 (D), TVS2.A
unnamed: S02.3, SP3.2, T3.3 (D), TVS3.A
unnamed: S02.4, SP4.2, T4.3 (D), TVS4.A
unnamed: S02.5, SP5.2, T5.3 (D), TVS5.A
unnamed: S02.6, SP6.2, T6.3 (D), TVS6.A
unnamed: S02.7, SP7.2, T7.3 (D), TVS7.A
unnamed: S02.8, SP8.2, T8.3 (D), TVS8.A
P0: PCA9555.4 (P00), RN1.8 (2)
P1: PCA9555.5 (P01), RN1.7 (2)
P2: PCA9555.6 (P02), RN1.6 (2)
P3: PCA9555.7 (P03), RN1.5 (2)
P4: PCA9555.8 (P04), RN2.8 (2)
P5: PCA9555.9 (P05), RN2.7 (2)
P6: PCA9555.10 (P06), RN2.6 (2)
P7: PCA9555.11 (P07), RN2.5 (2)
RECDC: 7805.1 (VI), C0.1, CH.1, D1.C
S1: JCON.7, RSN1.1
S2: JCON.8, RSN2.1

Notes on the sheet:
BPE
BVE
for curr sensing
(Note: this is N-ch MOSFET, despite the symbol being BJT transistor)

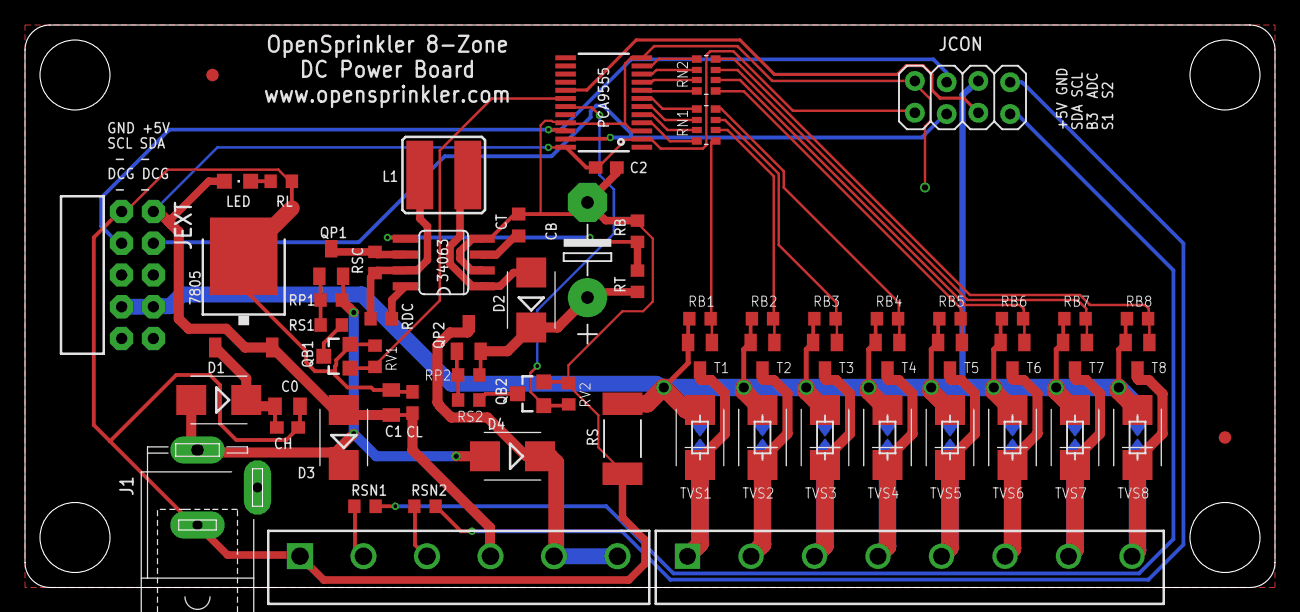
[picture p47: board dcdr_3.2.brd from above]

Board: 2 copper layers, 100.0 x 45.0 mm, 75 parts (0 on the bottom side), 51 nets.
