OpenSprinkler/OpenSprinkler-Hardware/OS/3.0-3.3/AC_driver/acdr_3.2.brd

## EAGLE design OS/3.0-3.3/AC_driver/acdr_3.2.brd (2021-09-10)

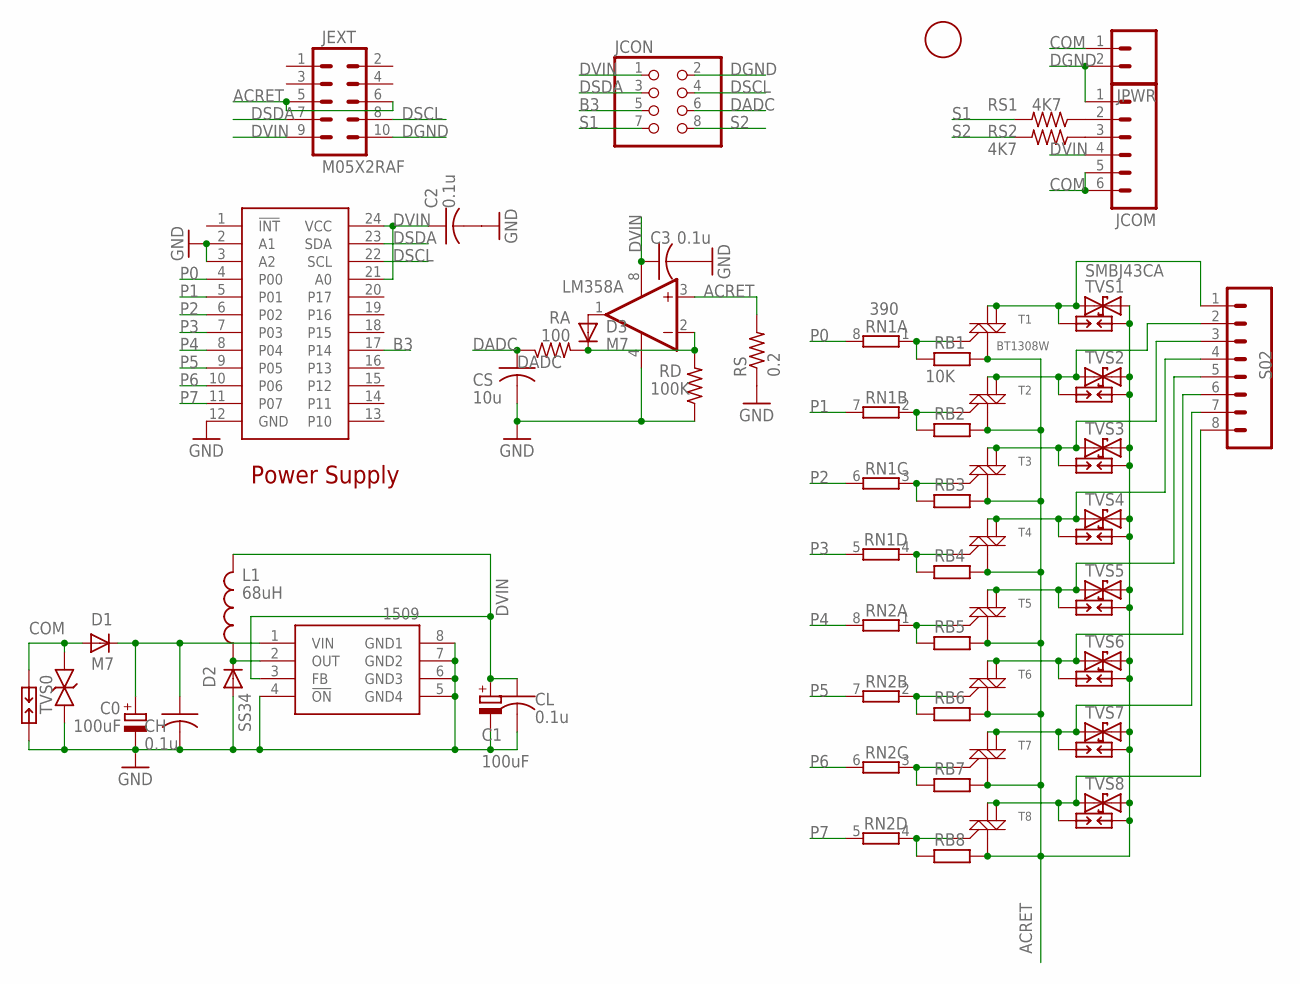
[picture p48: schematic acdr_3.2.sch]

Parts:
1F: FIDUCIAL; FIDUCIAL_1MM
1509: 34063; SO08
C0: 100uF; PANASONIC_E
C1: 100uF; PANASONIC_D
C2, C3: 0.1u; C0603
CH: 0.1u; C0603
CL: 0.1u; C0603
CS: 10u; C0805K
D1, D3: M7; DO-214AC
D2: SS34; SMB
JCOM: M065MM; SCREWTERMINAL-5MM-6
JCON: PINHD-2X4; 2X04
JEXT: M05X2RAF; 2X5-RAF
JPWR: M024MM-X; SCREWTERMINAL-4MM-2-X
L1: 68uH; CDRH125
LM358: OP262D; SO08
PCA9555: PCA9555; TSSOP24
RA: 100; R0603
RB1, RB2, RB3, RB4, RB5, RB6, RB7, RB8: 10K; R0603
RD: 100K; R0603
RN1: 390; EXB38V
RN2: 4R-NEXB38V; EXB38V
RS: 0.2; R2512
RS1, RS2: 4K7; R0603
S02: M085MM-8; SCREWTERMINAL-5MM-8
SP0, SP1, SP2, SP3, SP4, SP5, SP6, SP7, SP8: PCB-SGAP
T1: BT1308W; SOT223
T2, T3, T4, T5, T6, T7, T8: MAC97SOT223; SOT223
TVS0: 43CA; SMB
TVS1: SMBJ43CA; SMB
TVS2, TVS3, TVS4, TVS5, TVS6, TVS7, TVS8: TVSSMB; SMB

Connections:
ACRET: JEXT.5, JEXT.6, LM358.3 (+IN), RB1.1, RB2.1, RB3.1, RB4.1, RB5.1, RB6.1, RB7.1, RB8.1, RS.2, SP1.1, SP2.1, SP3.1, SP4.1, SP5.1, SP6.1, SP7.1, SP8.1, T1.1 (M1), T2.1 (M1), T3.1 (M1), T4.1 (M1), T5.1 (M1), T6.1 (M1), T7.1 (M1), T8.1 (M1), TVS1.C, TVS2.C, TVS3.C, TVS4.C, TVS5.C, TVS6.C, TVS7.C, TVS8.C
B3: JCON.5, PCA9555.17 (P14)
COM: D1.A, JCOM.5, JCOM.6, JPWR.1, SP0.1, TVS0.C
DADC: CS.1, JCON.6, RA.1
DGND: 1509.4 (!ON), 1509.5 (GND4), 1509.6 (GND3), 1509.7 (GND2), 1509.8 (GND1), C0.-, C1.-, C3.2, CH.2, CL.2, CS.2, D2.A, JCOM.1, JCON.2, JEXT.10, JPWR.2, LM358.4 (V-), PCA9555.2 (A1), PCA9555.3 (A2), PCA9555.12 (GND), RD.1, RS.1, SP0.2, TVS0.A
DSCL: JCON.4, JEXT.8, PCA9555.22 (SCL)
DSDA: JCON.3, JEXT.7, PCA9555.23 (SDA)
DVIN: 1509.3 (FB), C1.+, C2.1, C3.1, CL.1, JCOM.4, JCON.1, JEXT.9, L1.2, LM358.8 (V+), PCA9555.21 (A0), PCA9555.24 (VCC)
GND: C2.2
unnamed: JCOM.2, RS1.1
unnamed: JCOM.3, RS2.1
unnamed: D3.C, LM358.2 (-IN), RA.2, RD.2
unnamed: RB1.2, RN1.1, T1.3 (G)
unnamed: RB2.2, RN1.2 (1), T2.3 (G)
unnamed: RB3.2, RN1.3 (1), T3.3 (G)
unnamed: RB4.2, RN1.4 (1), T4.3 (G)
unnamed: RB5.2, RN2.1, T5.3 (G)
unnamed: RB6.2, RN2.2 (1), T6.3 (G)
unnamed: RB7.2, RN2.3 (1), T7.3 (G)
unnamed: RB8.2, RN2.4 (1), T8.3 (G)
unnamed: 1509.2 (OUT), D2.C, L1.1
unnamed: D3.A, LM358.1 (OUT)
unnamed: S02.1, SP1.2, T1.2 (M2), T1.4 (M2-4), TVS1.A
unnamed: S02.2, SP2.2, T2.2 (M2), T2.4 (M2-4), TVS2.A
unnamed: S02.3, SP3.2, T3.2 (M2), T3.4 (M2-4), TVS3.A
unnamed: S02.4, SP4.2, T4.2 (M2), T4.4 (M2-4), TVS4.A
unnamed: S02.5, SP5.2, T5.2 (M2), T5.4 (M2-4), TVS5.A
unnamed: S02.6, SP6.2, T6.2 (M2), T6.4 (M2-4), TVS6.A
unnamed: S02.7, SP7.2, T7.2 (M2), T7.4 (M2-4), TVS7.A
unnamed: S02.8, SP8.2, T8.2 (M2), T8.4 (M2-4), TVS8.A
P0: PCA9555.4 (P00), RN1.8 (2)
P1: PCA9555.5 (P01), RN1.7 (2)
P2: PCA9555.6 (P02), RN1.6 (2)
P3: PCA9555.7 (P03), RN1.5 (2)
P4: PCA9555.8 (P04), RN2.8 (2)
P5: PCA9555.9 (P05), RN2.7 (2)
P6: PCA9555.10 (P06), RN2.6 (2)
P7: PCA9555.11 (P07), RN2.5 (2)
RECAC: 1509.1 (VIN), C0.+, CH.1, D1.C
S1: JCON.7, RS1.2
S2: JCON.8, RS2.2

Notes on the sheet:
Power Supply

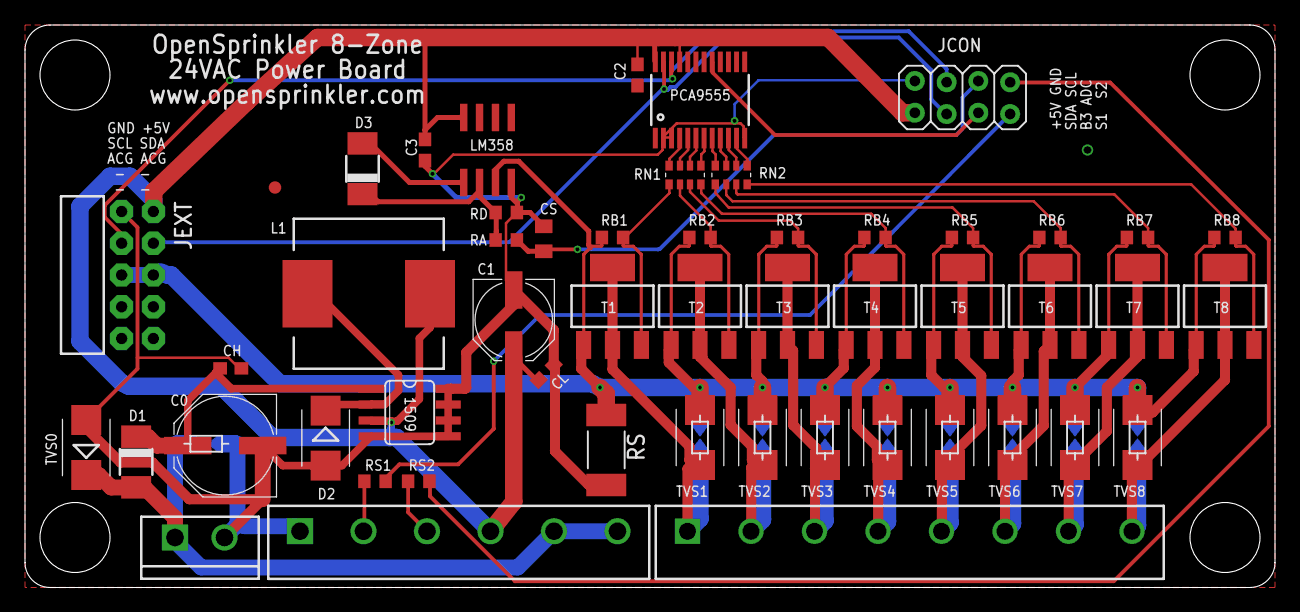
[picture p49: board acdr_3.2.brd from above]

Board: 2 copper layers, 100.0 x 45.0 mm, 61 parts (0 on the bottom side), 40 nets.
