OpenSprinkler/OpenSprinkler-Hardware/OS/3.0-3.3/AC_driver/acdr_3.2_updated.brd

## EAGLE design OS/3.0-3.3/AC_driver/acdr_3.2_updated.brd (2024-04-23)

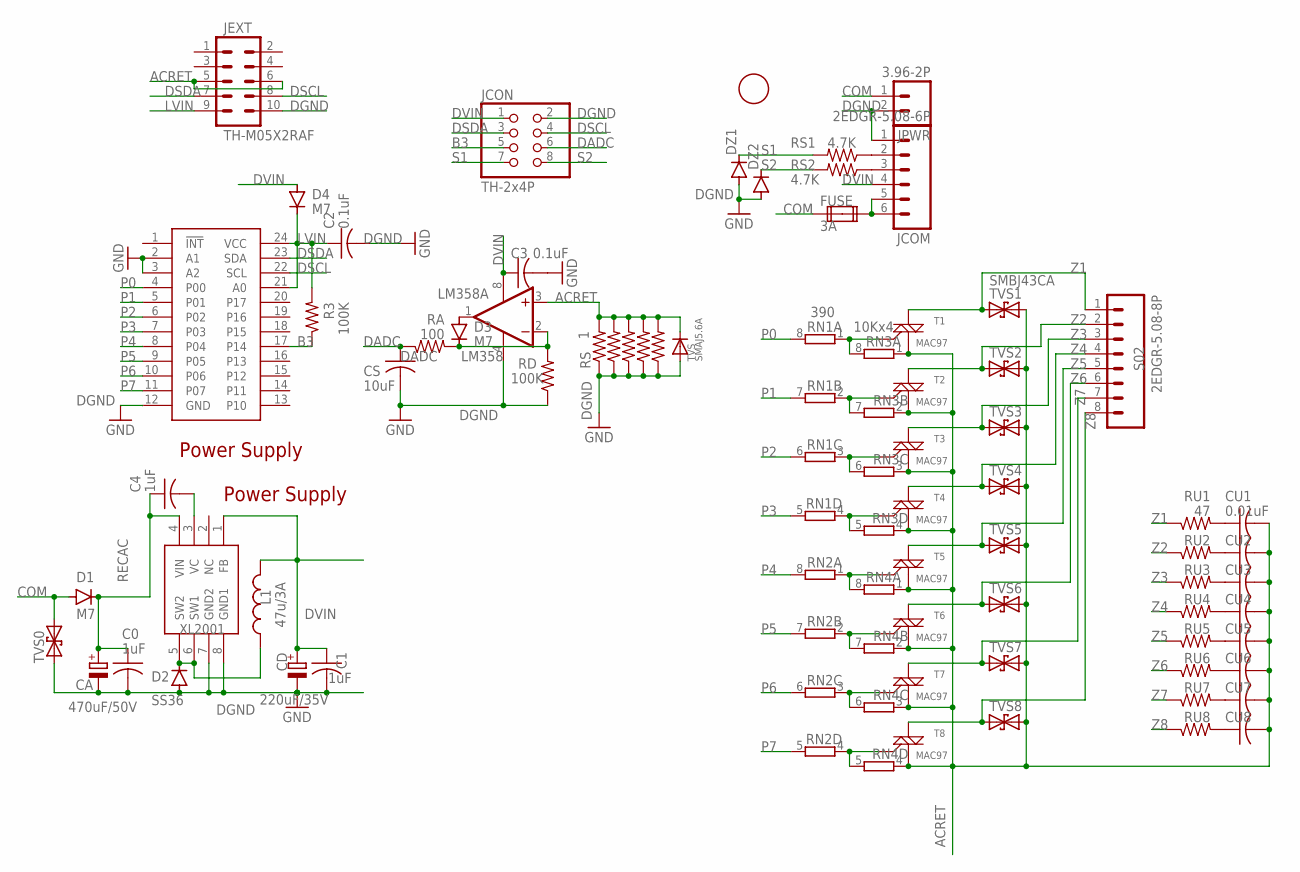
[picture p50: schematic acdr_3.2_updated.sch]

Parts:
1F: FIDUCIAL; FIDUCIAL_1MM
C0, C1, C4: 1uF; C0603K
C2, C3: 0.1uF; C0603K
CA: 470uF/50V; E5-10,5
CD: 220uF/35V; E3,5-8
CS: 10uF; C0805K
CU1, CU2, CU3, CU4, CU5, CU6, CU7, CU8: 0.01uF; C0603K
D1, D3, D4: M7; DO214AC
D2: SS36; SMB
DZ1, DZ2: ZMM5V1; MINIMELF
FUSE: 3A; FUSE1
JCOM: 2EDGR-5.08-6P; SCREWTERMINAL-5MM-6
JCON: TH-2x4P; 2X04
JEXT: TH-M05X2RAF; 2X5-RAF
JPWR: 3.96-2P; SCREWTERMINAL-4MM-2-X
L1: 47u/3A; YT1014
LM358: LM358; SO08
PCA9555: PCA9555; TSSOP24
R3: 100K; R0603
RA: 100; R0603
RD: 100K; R0603
RN1, RN2: 390; EXB38V
RN3, RN4: 10Kx4; EXB38V
RS: 1; R2512
RS1, RS2: 4.7K; R0603
RSA: 1; R2512
RSB: 1; R2512
RSC: 1; R2512
RSD: 1; R2512
RU1, RU2, RU3, RU4, RU5, RU6, RU7, RU8: 47; R0603
S02: 2EDGR-5.08-8P; SCREWTERMINAL-5MM-8
T1, T2, T3, T4, T5, T6, T7, T8: MAC97; TO-92-STRAIGHT
TVS: SMAJ5.6A; SMADIODE
TVS0, TVS1, TVS2, TVS3, TVS4, TVS5, TVS6, TVS7, TVS8: SMBJ43CA; SMB
XL2001: XL2001; SO08

Connections:
ACRET: CU1.2, CU2.2, CU3.2, CU4.2, CU5.2, CU6.2, CU7.2, CU8.2, JEXT.5, JEXT.6, LM358.3 (+IN), RN3.1, RN3.2 (1), RN3.3 (1), RN3.4 (1), RN4.1, RN4.2 (1), RN4.3 (1), RN4.4 (1), RS.2, RSA.2, RSB.2, RSC.2, RSD.2, T1.1 (M1), T2.1 (M1), T3.1 (M1), T4.1 (M1), T5.1 (M1), T6.1 (M1), T7.1 (M1), T8.1 (M1), TVS.C, TVS1.C, TVS2.C, TVS3.C, TVS4.C, TVS5.C, TVS6.C, TVS7.C, TVS8.C
B3: JCON.5, PCA9555.17 (P14), R3.1
COM: D1.A, FUSE.1A, JPWR.1, TVS0.C
DADC: CS.1, JCON.6, RA.1
DGND: C0.2, C1.2, C2.2, C3.2, CA.-, CD.-, CS.2, D2.A, DZ1.A, DZ2.A, JCOM.1, JCON.2, JEXT.10, JPWR.2, LM358.4 (V-), PCA9555.2 (A1), PCA9555.3 (A2), PCA9555.12 (GND), RD.1, RS.1, RSA.1, RSB.1, RSC.1, RSD.1, TVS.A, TVS0.A, XL2001.7 (GND2), XL2001.8 (GND1)
DSCL: JCON.4, JEXT.8, PCA9555.22 (SCL)
DSDA: JCON.3, JEXT.7, PCA9555.23 (SDA)
DVIN: C1.1, C3.1, CD.+, D4.A, JCOM.4, JCON.1, L1.P$2 (2), LM358.8 (V+), XL2001.1 (FB)
FCOM: FUSE.2A, JCOM.5, JCOM.6
LVIN: C2.1, D4.C, JEXT.9, PCA9555.21 (A0), PCA9555.24 (VCC), R3.2
unnamed: JCOM.2, RS1.1
unnamed: CU1.1, RU1.2
unnamed: JCOM.3, RS2.1
unnamed: CU2.1, RU2.2
unnamed: CU3.1, RU3.2
unnamed: CU4.1, RU4.2
unnamed: D3.C, LM358.2 (-IN), RA.2, RD.2
unnamed: RN1.1, RN3.8 (2), T1.2 (G)
unnamed: RN1.2 (1), RN3.7 (2), T2.2 (G)
unnamed: CU5.1, RU5.2
unnamed: CU6.1, RU6.2
unnamed: CU7.1, RU7.2
unnamed: CU8.1, RU8.2
unnamed: RN1.3 (1), RN3.6 (2), T3.2 (G)
unnamed: RN1.4 (1), RN3.5 (2), T4.2 (G)
unnamed: RN2.1, RN4.8 (2), T5.2 (G)
unnamed: RN2.2 (1), RN4.7 (2), T6.2 (G)
unnamed: RN2.3 (1), RN4.6 (2), T7.2 (G)
unnamed: RN2.4 (1), RN4.5 (2), T8.2 (G)
unnamed: D2.C, L1.P$1 (1), XL2001.5 (SW2), XL2001.6 (SW1)
unnamed: C4.2, XL2001.3 (VC)
unnamed: D3.A, LM358.1 (OUT)
P0: PCA9555.4 (P00), RN1.8 (2)
P1: PCA9555.5 (P01), RN1.7 (2)
P2: PCA9555.6 (P02), RN1.6 (2)
P3: PCA9555.7 (P03), RN1.5 (2)
P4: PCA9555.8 (P04), RN2.8 (2)
P5: PCA9555.9 (P05), RN2.7 (2)
P6: PCA9555.10 (P06), RN2.6 (2)
P7: PCA9555.11 (P07), RN2.5 (2)
RECAC: C0.1, C4.1, CA.+, D1.C, XL2001.4 (VIN)
S1: DZ1.C, JCON.7, RS1.2
S2: DZ2.C, JCON.8, RS2.2
Z1: RU1.1, S02.1, T1.3 (M2), TVS1.A
Z2: RU2.1, S02.2, T2.3 (M2), TVS2.A
Z3: RU3.1, S02.3, T3.3 (M2), TVS3.A
Z4: RU4.1, S02.4, T4.3 (M2), TVS4.A
Z5: RU5.1, S02.5, T5.3 (M2), TVS5.A
Z6: RU6.1, S02.6, T6.3 (M2), TVS6.A
Z7: RU7.1, S02.7, T7.3 (M2), TVS7.A
Z8: RU8.1, S02.8, T8.3 (M2), TVS8.A

Notes on the sheet:
Power Supply

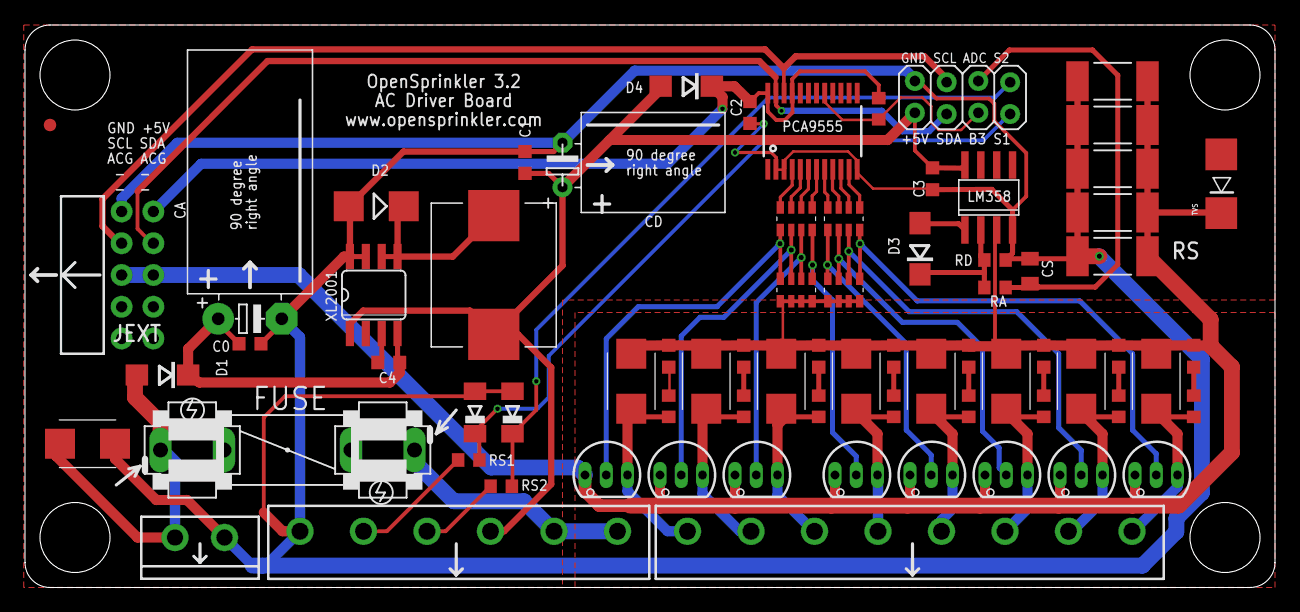
[picture p51: board acdr_3.2_updated.brd from above]

Board: 2 copper layers, 100.0 x 45.0 mm, 73 parts (0 on the bottom side), 51 nets.
