OpenSprinkler/OpenSprinkler-Hardware/OS/3.0-3.3/Master/os31_master.brd

## EAGLE design OS/3.0-3.3/Master/os31_master.brd (2018-06-08)

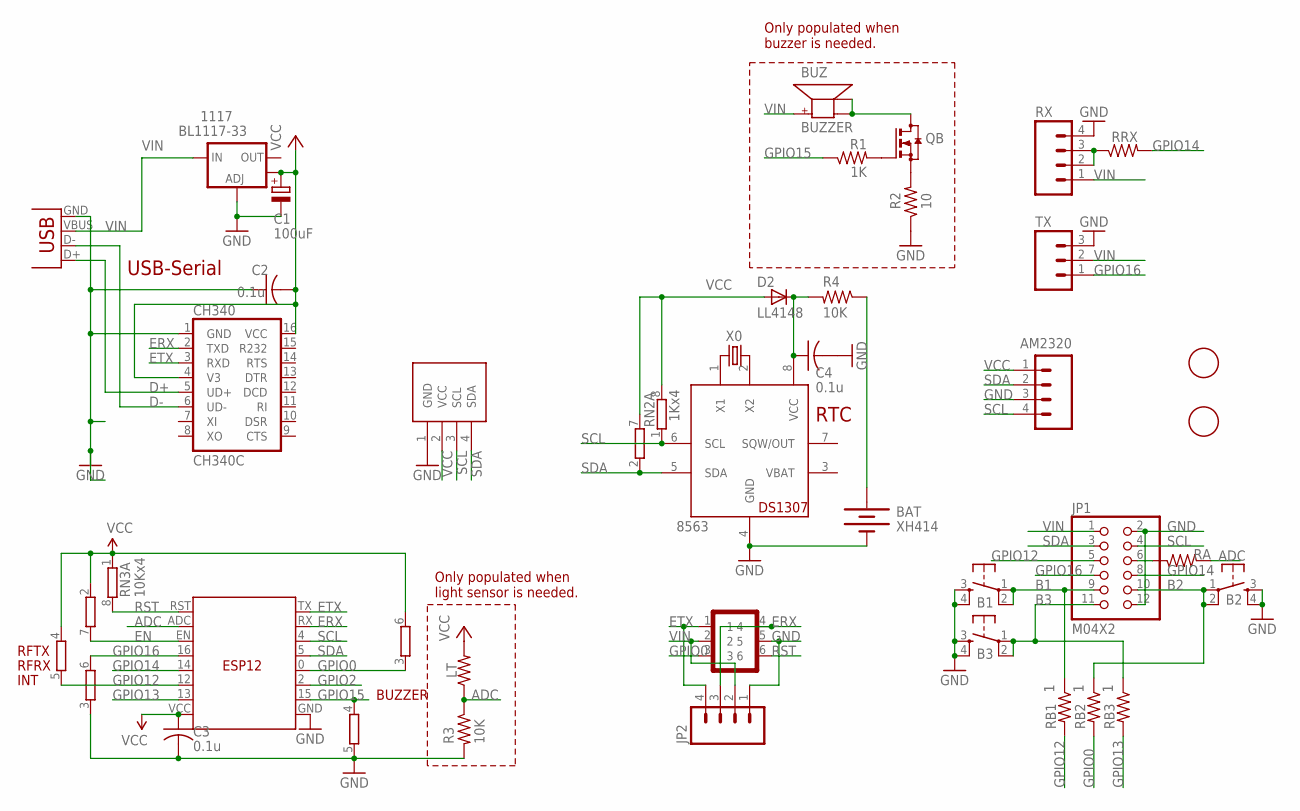
[picture p52: schematic os31_master.sch]

Parts:
1F, 2F: FIDUCIAL; FIDUCIAL_1MM
1117: BL1117-33; SOT223
8563: PCF8563; SO08
AM2320: M04NARROW; 1X04-NARROW
B1, B2, B3: SPST_TACTEVQQ2; EVQ-Q2
BAT: XH414; BATTCON_XH414
BUZ: BUZZER; SMT-8585-BUZZER
C1: 100uF; CT3528
C2, C3, C4: 0.1u; C0603
CH340: CH340C; SO16
D2: LL4148; SOD123
ESP: ESP-12N; ESP12_WES
JP1: M04X2; 2X06
JP2: M04PTH; 1X04
LCD: SSD1306_OLED_I2CSMD3; SSD1306_OLED_I2C_SMD3
LT: 100K; R1206
QB: MMBT3904; SOT23
R1: 1K; R0603
R2: 10; R0603
R3, R4: 10K; R0603
RA: 1; R0603
RB1, RB2, RB3: 1; R0603
RN2: 1Kx4; EXB38V
RN3: 10Kx4; EXB38V
RRX: 1K; R0603
RX: M04LOCK; 1X04_LOCK
TX: M03LOCK; 1X03_LOCK
U$3: GOLDFINGER_2X3
USB: USBMICROB2; USB-MICROB2
X0: 32.768kHz; MM20SS1

Connections:
ADC: ESP.ADC, LT.1, R3.1, RA.2
B1: B1.1, B1.2, JP1.9, RB1.1
B2: B2.1, B2.2, JP1.10, RB2.1
B3: B3.1, B3.2, JP1.11, RB3.1
D+: CH340.5 (UD+), USB.D+
D-: CH340.6 (UD-), USB.D-
EN: ESP.EN, RN3.7 (2)
ERX: CH340.2 (TXD), ESP.RX, JP2.3, U$3.4
ETX: CH340.3 (RXD), ESP.TX, JP2.4, U$3.1
GND: 1117.1 (ADJ), 8563.4 (GND), AM2320.3, B1.3, B1.4, B2.3, B2.4, B3.3, B3.4, BAT.P$1 (-), C1.+ (-), C2.1, C3.2, C4.2, CH340.1 (GND), ESP.GND, JP1.2, JP1.12, JP2.1, LCD.1 (GND), R2.1, R3.2, RN2.5 (2), RN3.3 (1), RX.4, TX.3, U$3.5, USB.GND
GPIO0: ESP.0 (G0), RB2.2, RN2.3 (1), U$3.3
GPIO2: ESP.2 (G2)
GPIO12: ESP.12 (G12), JP1.5, RB1.2, RN3.5 (2)
GPIO13: ESP.13 (G13), RB3.2
GPIO14: ESP.14 (G14), JP1.8, RRX.2
GPIO15: ESP.15 (G15), R1.1, RN2.4 (1)
GPIO16: ESP.16 (G16), JP1.7, RN3.6 (2), TX.1
unnamed: 8563.1 (X1), X0.1
unnamed: BUZ.-, BUZ.A-, QB.3 (D)
unnamed: QB.1 (G), R1.2
unnamed: QB.2 (S), R2.2
unnamed: JP1.6, RA.1
unnamed: 8563.8 (VCC), C4.1, D2.C, R4.2
unnamed: RRX.1, RX.2, RX.3
unnamed: 8563.2 (X2), X0.4 (2)
unnamed: BAT.P$2 (+), R4.1
RST: ESP.RST, RN3.8 (2), U$3.6
SCL: 8563.6 (SCL), AM2320.4, ESP.4 (G4), JP1.4, LCD.3 (SCL), RN2.1
SDA: 8563.5 (SDA), AM2320.2, ESP.5 (G5), JP1.3, LCD.4 (SDA), RN2.2 (1)
VBAT: 8563.3 (VBAT)
VCC: 1117.4 (OUT), AM2320.1, C1.- (+), C2.2, C3.1, CH340.4 (V3), CH340.16 (VCC), D2.A, ESP.VCC, LCD.2 (VCC), LT.2, RN2.6 (2), RN2.7 (2), RN2.8 (2), RN3.1, RN3.2 (1), RN3.4 (1)
VIN: 1117.3 (IN), BUZ.+, JP1.1, JP2.2, RX.1, TX.2, U$3.2, USB.VBUS

Notes on the sheet:
RTC
USB-Serial
RFRX
BUZZER
RFTX
INT
Only populated when buzzer is needed.
Only populated when light sensor is needed.

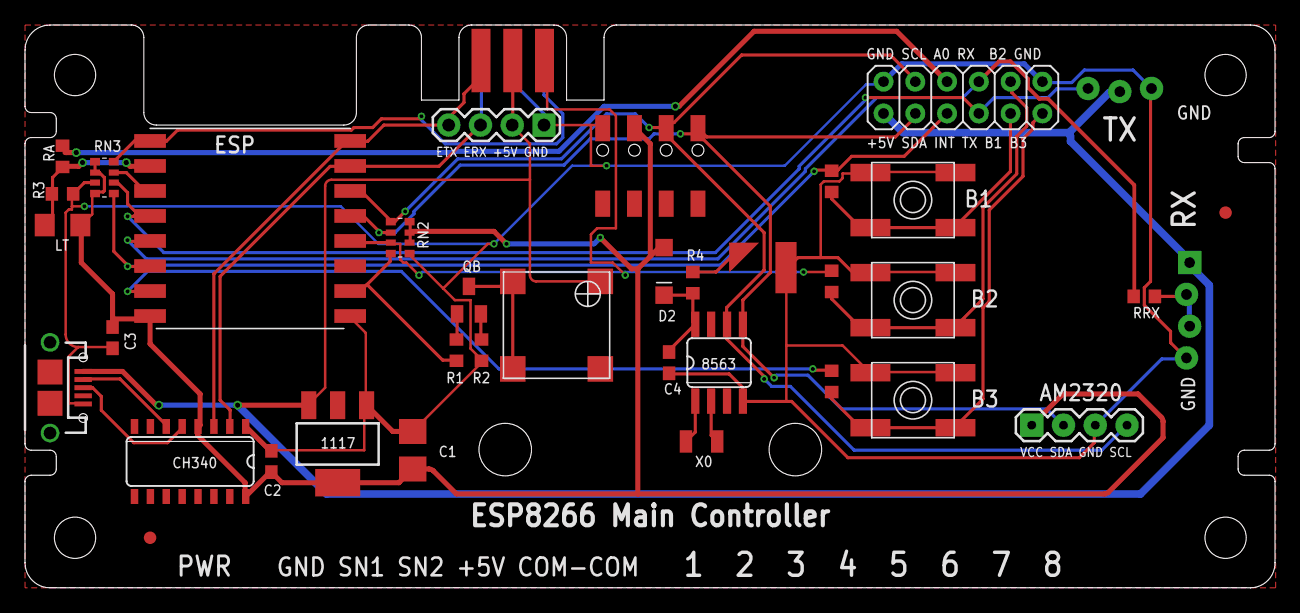
[picture p53: board os31_master.brd from above]

Board: 2 copper layers, 100.0 x 45.0 mm, 38 parts (0 on the bottom side), 30 nets.
