OpenSprinkler/OpenSprinkler-Hardware/OS/3.0-3.3/AC_driver/acdr_3.0.brd

## EAGLE design OS/3.0-3.3/AC_driver/acdr_3.0.brd (2017-06-06)

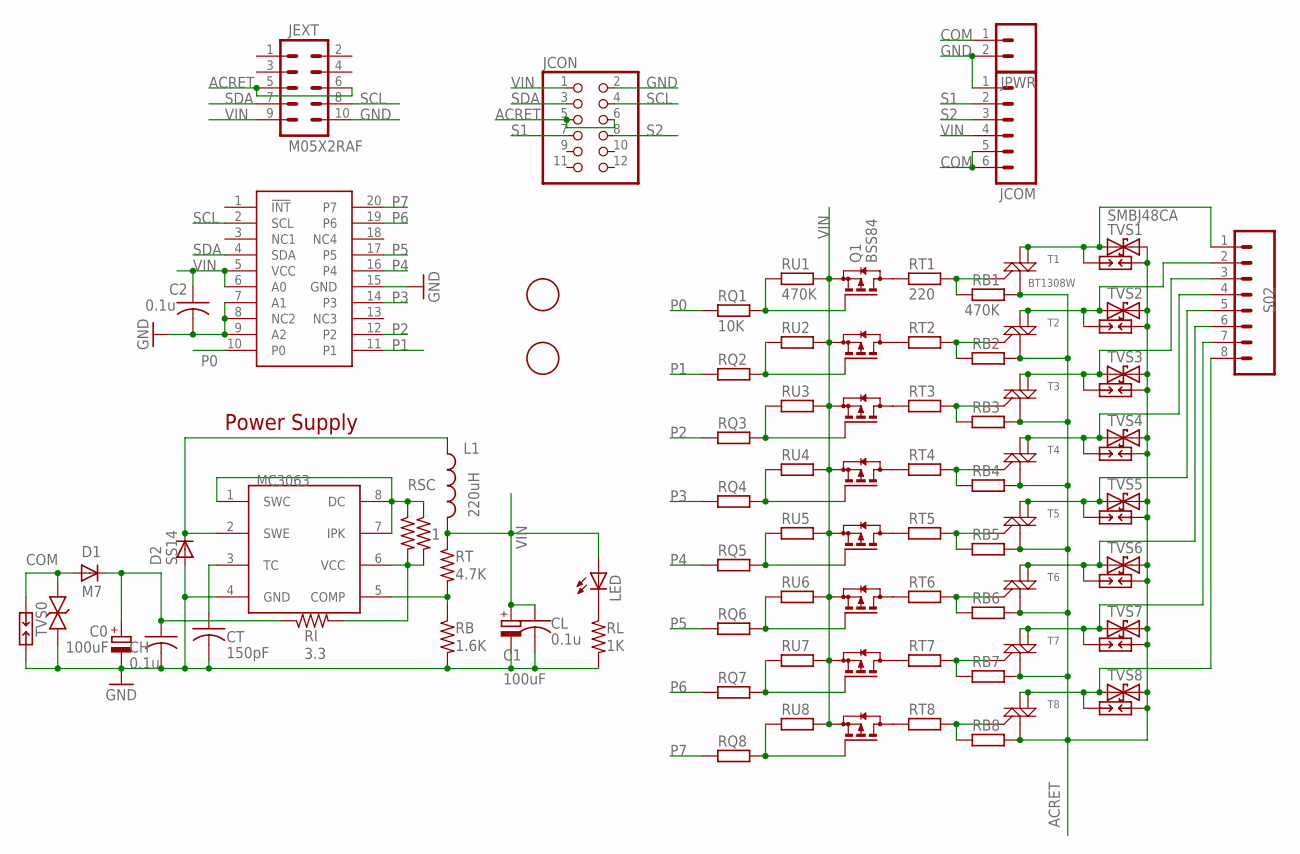
[picture p54: schematic acdr_3.0.sch]

Parts:
C0: 100uF; PANASONIC_E
C1: 100uF; PANASONIC_D
C2: 0.1u; C0603
CH: 0.1u; C0603
CL: 0.1u; C0603
CT: 150pF; C0603K
D1: M7; DO-214AC
D2: SS14; DO-214AC
JCOM: M065MM; SCREWTERMINAL-5MM-6
JCON: PINHD-2X6; 2X06
JEXT: M05X2RAF; 2X5-RAF
JPWR: M024MM-X; SCREWTERMINAL-4MM-2-X
L1: 220uH; SRU1038
LED: LEDCHIPLED_0805; CHIPLED_0805
MC3063: 34063; SO08
PCF8574: PCF8574; SSOP20
Q1, Q2, Q3, Q4, Q5, Q6, Q7, Q8: BSS84; SOT23
RB: 1.6K; R0603
RB1, RB2, RB3, RB4, RB5, RB6, RB7, RB8: 470K; R0603
RI: 3.3; R2010
RL: 1K; R0603
RQ1, RQ2, RQ3, RQ4, RQ5, RQ6, RQ7, RQ8: 10K; R0603
RSC, RSC1: 1; R0805
RT: 4.7K; R0805
RT1, RT2, RT3, RT4, RT5, RT6, RT7, RT8: 220; R0603
RU1, RU2, RU3, RU4, RU5, RU6, RU7, RU8: 470K; R0603
S02: M085MM-8; SCREWTERMINAL-5MM-8
SP0, SP1, SP2, SP3, SP4, SP5, SP6, SP7, SP8: PCB-SGAP
T1: BT1308W; SOT223
T2, T3, T4, T5, T6, T7, T8: MAC97SOT223; SOT223
TVS0: 43CA; SMB
TVS1: SMBJ48CA; SMB
TVS2, TVS3, TVS4, TVS5, TVS6, TVS7, TVS8: TVSSMB; SMB
U$1, U$2: FIDUCIAL; FIDUCIAL_1MM

Connections:
ACRET: JCON.5, JCON.6, JEXT.5, JEXT.6, RB1.1, RB2.1, RB3.1, RB4.1, RB5.1, RB6.1, RB7.1, RB8.1, SP1.1, SP2.1, SP3.1, SP4.1, SP5.1, SP6.1, SP7.1, SP8.1, T1.1 (M1), T2.1 (M1), T3.1 (M1), T4.1 (M1), T5.1 (M1), T6.1 (M1), T7.1 (M1), T8.1 (M1), TVS1.C, TVS2.C, TVS3.C, TVS4.C, TVS5.C, TVS6.C, TVS7.C, TVS8.C
COM: D1.A, JCOM.5, JCOM.6, JPWR.1, SP0.1, TVS0.C
GND: C0.-, C1.-, C2.2, CH.2, CL.2, CT.2, D2.A, JCOM.1, JCON.2, JEXT.10, JPWR.2, MC3063.4 (GND), PCF8574.7 (A1), PCF8574.8 (NC2), PCF8574.9 (A2), PCF8574.15 (GND), RB.2, RL.2, SP0.2, TVS0.A
unnamed: MC3063.1 (SWC), MC3063.7 (IPK), MC3063.8 (DC), RSC.1, RSC1.1
unnamed: Q1.3 (D), RT1.2
unnamed: Q2.3 (D), RT2.2
unnamed: Q3.3 (D), RT3.2
unnamed: Q4.3 (D), RT4.2
unnamed: Q5.3 (D), RT5.2
unnamed: Q6.3 (D), RT6.2
unnamed: RB1.2, RT1.1, T1.3 (G)
unnamed: RB2.2, RT2.1, T2.3 (G)
unnamed: Q7.3 (D), RT7.2
unnamed: Q8.3 (D), RT8.2
unnamed: Q1.1 (G), RQ1.1, RU1.2
unnamed: Q2.1 (G), RQ2.1, RU2.2
unnamed: Q3.1 (G), RQ3.1, RU3.2
unnamed: RB3.2, RT3.1, T3.3 (G)
unnamed: RB4.2, RT4.1, T4.3 (G)
unnamed: D2.C, L1.1, MC3063.2 (SWE)
unnamed: RB5.2, RT5.1, T5.3 (G)
unnamed: RB6.2, RT6.1, T6.3 (G)
unnamed: Q4.1 (G), RQ4.1, RU4.2
unnamed: RB7.2, RT7.1, T7.3 (G)
unnamed: RB8.2, RT8.1, T8.3 (G)
unnamed: Q5.1 (G), RQ5.1, RU5.2
unnamed: CT.1, MC3063.3 (TC)
unnamed: Q6.1 (G), RQ6.1, RU6.2
unnamed: MC3063.5 (COMP), RB.1, RT.2
unnamed: MC3063.6 (VCC), RI.2, RSC.2, RSC1.2
unnamed: LED.C, RL.1
unnamed: Q7.1 (G), RQ7.1, RU7.2
unnamed: Q8.1 (G), RQ8.1, RU8.2
unnamed: S02.1, SP1.2, T1.2 (M2), T1.4 (M2-4), TVS1.A
unnamed: S02.2, SP2.2, T2.2 (M2), T2.4 (M2-4), TVS2.A
unnamed: S02.3, SP3.2, T3.2 (M2), T3.4 (M2-4), TVS3.A
unnamed: S02.4, SP4.2, T4.2 (M2), T4.4 (M2-4), TVS4.A
unnamed: S02.5, SP5.2, T5.2 (M2), T5.4 (M2-4), TVS5.A
unnamed: S02.6, SP6.2, T6.2 (M2), T6.4 (M2-4), TVS6.A
unnamed: S02.7, SP7.2, T7.2 (M2), T7.4 (M2-4), TVS7.A
unnamed: S02.8, SP8.2, T8.2 (M2), T8.4 (M2-4), TVS8.A
P0: PCF8574.10 (P0), RQ1.2
P1: PCF8574.11 (P1), RQ2.2
P2: PCF8574.12 (P2), RQ3.2
P3: PCF8574.14 (P3), RQ4.2
P4: PCF8574.16 (P4), RQ5.2
P5: PCF8574.17 (P5), RQ6.2
P6: PCF8574.19 (P6), RQ7.2
P7: PCF8574.20 (P7), RQ8.2
RECAC: C0.+, CH.1, D1.C, RI.1
S1: JCOM.2, JCON.7
S2: JCOM.3, JCON.8
SCL: JCON.4, JEXT.8, PCF8574.2 (SCL)
SDA: JCON.3, JEXT.7, PCF8574.4 (SDA)
VIN: C1.+, C2.1, CL.1, JCOM.4, JCON.1, JEXT.9, L1.2, LED.A, PCF8574.5 (VCC), PCF8574.6 (A0), Q1.2 (S), Q2.2 (S), Q3.2 (S), Q4.2 (S), Q5.2 (S), Q6.2 (S), Q7.2 (S), Q8.2 (S), RT.1, RU1.1, RU2.1, RU3.1, RU4.1, RU5.1, RU6.1, RU7.1, RU8.1

Notes on the sheet:
Power Supply

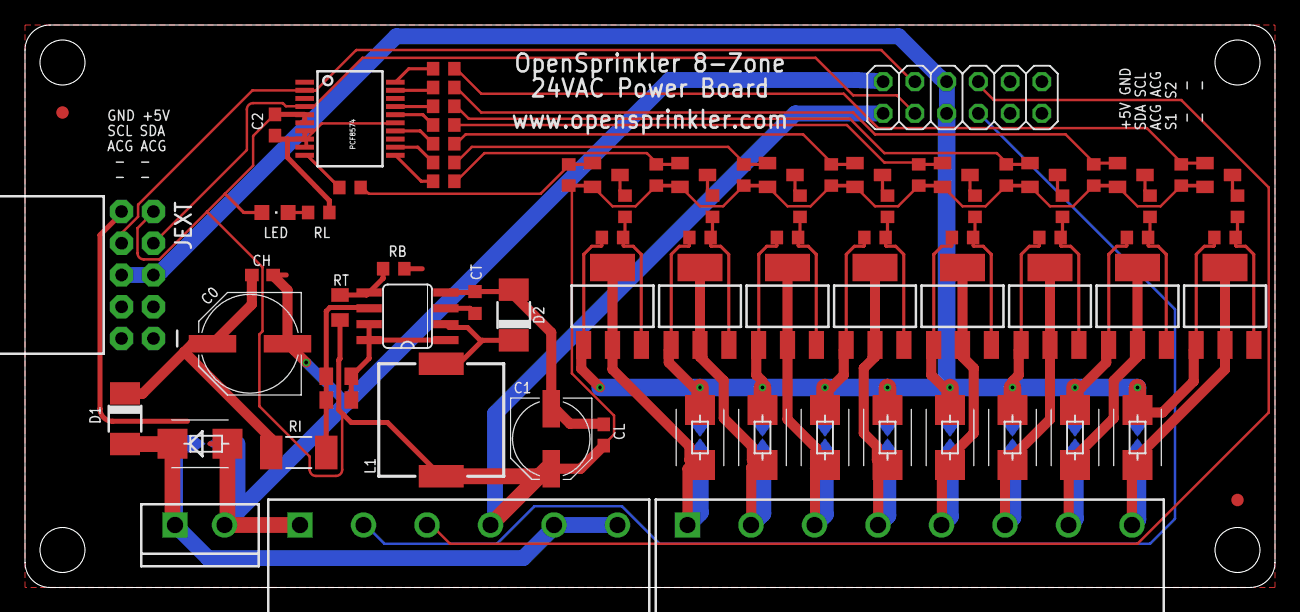
[picture p55: board acdr_3.0.brd from above]

Board: 2 copper layers, 100.0 x 45.0 mm, 91 parts (0 on the bottom side), 55 nets.
