OpenSprinkler/OpenSprinkler-Hardware/OSPi/1.60/ospi160.brd

## EAGLE design OSPi/1.60/ospi160.brd (2024-09-07)

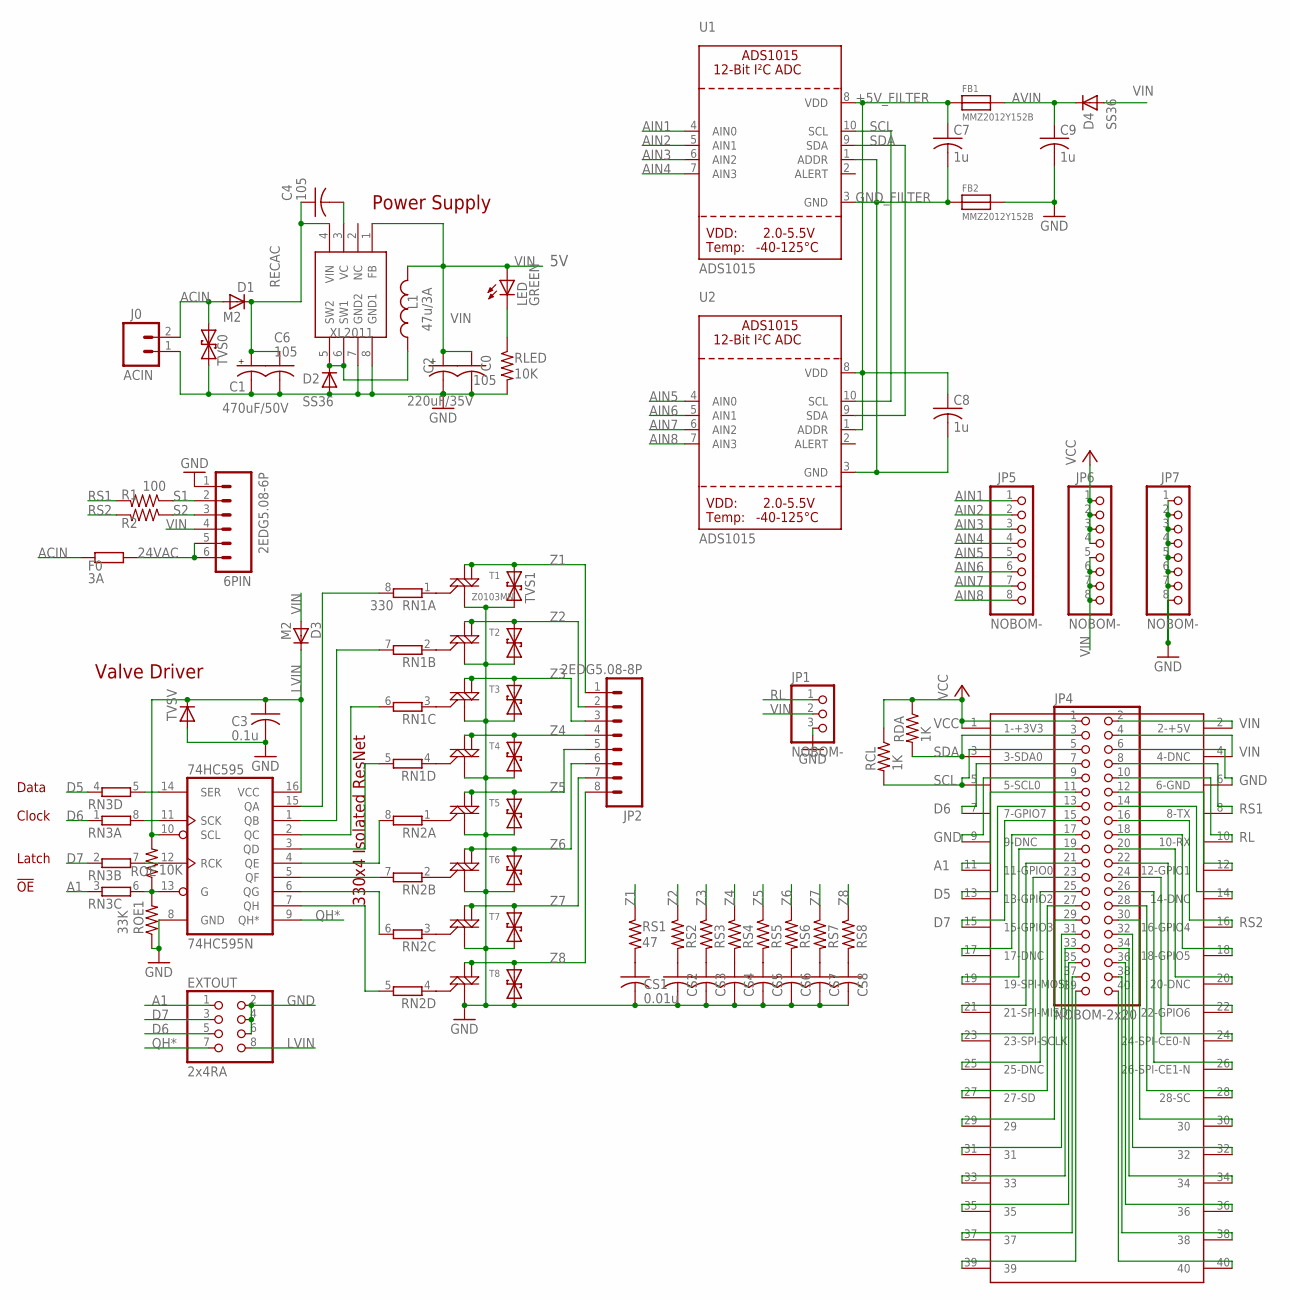
[picture p56: schematic ospi160.sch]

Parts:
6PIN: 2EDG5.08-6P; SCREWTERMINAL-5MM-6
74HC595: 74HC595N; SO16
C0, C4, C6: 105; C0603K
C1: 470uF/50V; E5-10,5
C2: 220uF/35V; E3,5-8
C3: 0.1u; C0603K
C7, C8, C9: 1u; C0603K
CS1, CS2, CS3, CS4, CS5, CS6, CS7, CS8: 0.01u; C0603K
D1, D3: M2; DO-214AC
D2, D4: SS36; SMB
EXTOUT: 2x4RA; 2X04/90
F0: 3A; 0207/15
FB1, FB2: MMZ2012Y152B; 0805
J0: ACIN; SCREWTERMINAL-4MM-2-X
JP1: NOBOM-; 1X03
JP2: 2EDG5.08-8P; SCREWTERMINAL-5MM-8
JP4: NOBOM-2x20; 2X20
JP5, JP6, JP7: NOBOM-; 1X08-CLEANBIG
L1: 47u/3A; YT1014
LED: GREEN; CHIPLED_0805
R1, R2: 100; R0603
RCL: 1K; R0603
RDA: 1K; R0603
RLED: 10K; R0603
RN1, RN2, RN3: 330; EXB38V
ROE: 10K; R0603
ROE1: 33K; R0603
RPI: RPIB+B+; RPIB+
RS1, RS2, RS3, RS4, RS5, RS6, RS7, RS8: 47; R0603
T1, T2, T3, T4, T5, T6, T7, T8: Z0103MN; SOT223
TVS0: TVSSMB; SMB
TVS1, TVS2, TVS3, TVS4, TVS5, TVS6, TVS7, TVS8: SMBJ43CA; SMB
TVSV: SMBJ5.0A; SMA-DIODE_ALT
U1, U2: ADS1015; MSOP10
XL2011: XL2011; SO08

Connections:
24VAC: 6PIN.5, 6PIN.6, F0.2
+5V_FILTER: C7.1, C8.1, FB1.1, U1.8 (VDD), U2.1 (ADDR), U2.8 (VDD)
A1: EXTOUT.1, JP4.11, RN3.3 (1), RPI.11 (11-GPIO0)
ACIN: D1.A, F0.1, J0.2, TVS0.C
AIN1: JP5.1, U1.4 (AIN0)
AIN2: JP5.2, U1.5 (AIN1)
AIN3: JP5.3, U1.6 (AIN2)
AIN4: JP5.4, U1.7 (AIN3)
AIN5: JP5.5, U2.4 (AIN0)
AIN6: JP5.6, U2.5 (AIN1)
AIN7: JP5.7, U2.6 (AIN2)
AIN8: JP5.8, U2.7 (AIN3)
AVIN: C9.1, D4.C, FB1.2
D5: JP4.13, RN3.4 (1), RPI.13 (13-GPIO2)
D6: EXTOUT.5, JP4.7, RN3.1, RPI.7 (7-GPIO7)
D7: EXTOUT.3, JP4.15, RN3.2 (1), RPI.15 (15-GPIO3)
GND: 6PIN.1, 74HC595.8 (GND), C0.2, C1.-, C2.-, C3.2, C6.2, C9.2, CS1.2, CS2.2, CS3.2, CS4.2, CS5.2, CS6.2, CS7.2, CS8.2, D2.A, EXTOUT.2, EXTOUT.4, EXTOUT.6, FB2.2, J0.1, JP1.3, JP4.6, JP4.9, JP7.1, JP7.2, JP7.3, JP7.4, JP7.5, JP7.6, JP7.7, JP7.8, RLED.2, ROE1.1, RPI.6 (6-GND), RPI.9 (9-DNC), T1.1 (M1), T2.1 (M1), T3.1 (M1), T4.1 (M1), T5.1 (M1), T6.1 (M1), T7.1 (M1), T8.1 (M1), TVS0.A, TVS1.C, TVS2.C, TVS3.C, TVS4.C, TVS5.C, TVS6.C, TVS7.C, TVS8.C, TVSV.A, XL2011.7 (GND2), XL2011.8 (GND1)
GND_FILTER: C7.2, C8.2, FB2.1, U1.1 (ADDR), U1.3 (GND), U2.3 (GND)
LVIN: 74HC595.10 (SCL), 74HC595.16 (VCC), C3.1, D3.C, EXTOUT.8, ROE.2, TVSV.C
unnamed: LED.C, RLED.1
unnamed: RN1.1, T1.3 (G)
unnamed: 74HC595.5 (QF), RN2.7 (2)
unnamed: 74HC595.6 (QG), RN2.6 (2)
unnamed: RN1.2 (1), T2.3 (G)
unnamed: 74HC595.7 (QH), RN2.5 (2)
unnamed: CS1.1, RS1.2
unnamed: CS2.1, RS2.2
unnamed: 74HC595.4 (QE), RN2.8 (2)
unnamed: 74HC595.3 (QD), RN1.5 (2)
unnamed: 74HC595.2 (QC), RN1.6 (2)
unnamed: 74HC595.1 (QB), RN1.7 (2)
unnamed: 74HC595.15 (QA), RN1.8 (2)
unnamed: RN1.3 (1), T3.3 (G)
unnamed: CS3.1, RS3.2
unnamed: CS4.1, RS4.2
unnamed: CS5.1, RS5.2
unnamed: RN1.4 (1), T4.3 (G)
unnamed: CS6.1, RS6.2
unnamed: RN2.1, T5.3 (G)
unnamed: CS7.1, RS7.2
unnamed: CS8.1, RS8.2
unnamed: D2.C, L1.P$1 (1), XL2011.5 (SW2), XL2011.6 (SW1)
unnamed: C4.2, XL2011.3 (VC)
unnamed: RN2.2 (1), T6.3 (G)
unnamed: RN2.3 (1), T7.3 (G)
unnamed: RN2.4 (1), T8.3 (G)
unnamed: 74HC595.14 (SER), RN3.5 (2)
unnamed: 74HC595.11 (SCK), RN3.8 (2)
unnamed: 74HC595.12 (RCK), RN3.7 (2)
unnamed: JP4.12, RPI.12 (12-GPIO1)
unnamed: JP4.14, RPI.14 (14-DNC)
unnamed: 74HC595.13 (G), RN3.6 (2), ROE.1, ROE1.2
unnamed: JP4.23, RPI.23 (23-SPI-SCLK)
unnamed: JP4.25, RPI.25 (25-DNC)
unnamed: JP4.27, RPI.27 (27-SD)
unnamed: JP4.29, RPI.29
unnamed: JP4.39, RPI.39
unnamed: JP4.37, RPI.37
unnamed: JP4.17, RPI.17 (17-DNC)
unnamed: JP4.19, RPI.19 (19-SPI-MOSI)
unnamed: JP4.21, RPI.21 (21-SPI-MISO)
unnamed: JP4.35, RPI.35
unnamed: JP4.33, RPI.33
unnamed: JP4.31, RPI.31
unnamed: JP4.34, RPI.34
unnamed: JP4.36, RPI.36
unnamed: JP4.38, RPI.38
unnamed: JP4.40, RPI.40
unnamed: JP4.18, RPI.18 (18-GPIO5)
unnamed: JP4.20, RPI.20 (20-DNC)
unnamed: JP4.22, RPI.22 (22-GPIO6)
unnamed: JP4.24, RPI.24 (24-SPI-CE0-N)
unnamed: JP4.26, RPI.26 (26-SPI-CE1-N)
unnamed: JP4.28, RPI.28 (28-SC)
unnamed: JP4.30, RPI.30
unnamed: JP4.32, RPI.32
QH*: 74HC595.9 (QH*), EXTOUT.7
RECAC: C1.+, C4.1, C6.1, D1.C, XL2011.4 (VIN)
RL: JP1.1, JP4.10, RPI.10 (10-RX)
RS1: JP4.8, R1.2, RPI.8 (8-TX)
RS2: JP4.16, R2.2, RPI.16 (16-GPIO4)
S1: 6PIN.2, R1.1
S2: 6PIN.3, R2.1
SCL: JP4.5, RCL.2, RPI.5 (5-SCL0), U1.10 (SCL), U2.10 (SCL)
SDA: JP4.3, RDA.2, RPI.3 (3-SDA0), U1.9 (SDA), U2.9 (SDA)
VCC: JP4.1, JP6.1, JP6.2, JP6.3, JP6.4, RCL.1, RDA.1, RPI.1 (1-+3V3)
VIN: 6PIN.4, C0.1, C2.+, D3.A, D4.A, JP1.2, JP4.2, JP4.4, JP6.5, JP6.6, JP6.7, JP6.8, L1.P$2 (2), LED.A, RPI.2 (2-+5V), RPI.4 (4-DNC), XL2011.1 (FB)
Z1: JP2.1, RS1.1, T1.2 (M2), T1.4 (M2-4), TVS1.A
Z2: JP2.2, RS2.1, T2.2 (M2), T2.4 (M2-4), TVS2.A
Z3: JP2.3, RS3.1, T3.2 (M2), T3.4 (M2-4), TVS3.A
Z4: JP2.4, RS4.1, T4.2 (M2), T4.4 (M2-4), TVS4.A
Z5: JP2.5, RS5.1, T5.2 (M2), T5.4 (M2-4), TVS5.A
Z6: JP2.6, RS6.1, T6.2 (M2), T6.4 (M2-4), TVS6.A
Z7: JP2.7, RS7.1, T7.2 (M2), T7.4 (M2-4), TVS7.A
Z8: JP2.8, RS8.1, T8.2 (M2), T8.4 (M2-4), TVS8.A

Notes on the sheet:
Power Supply
Valve Driver
Data
Clock
Latch
330x4 Isolated ResNet
!OE

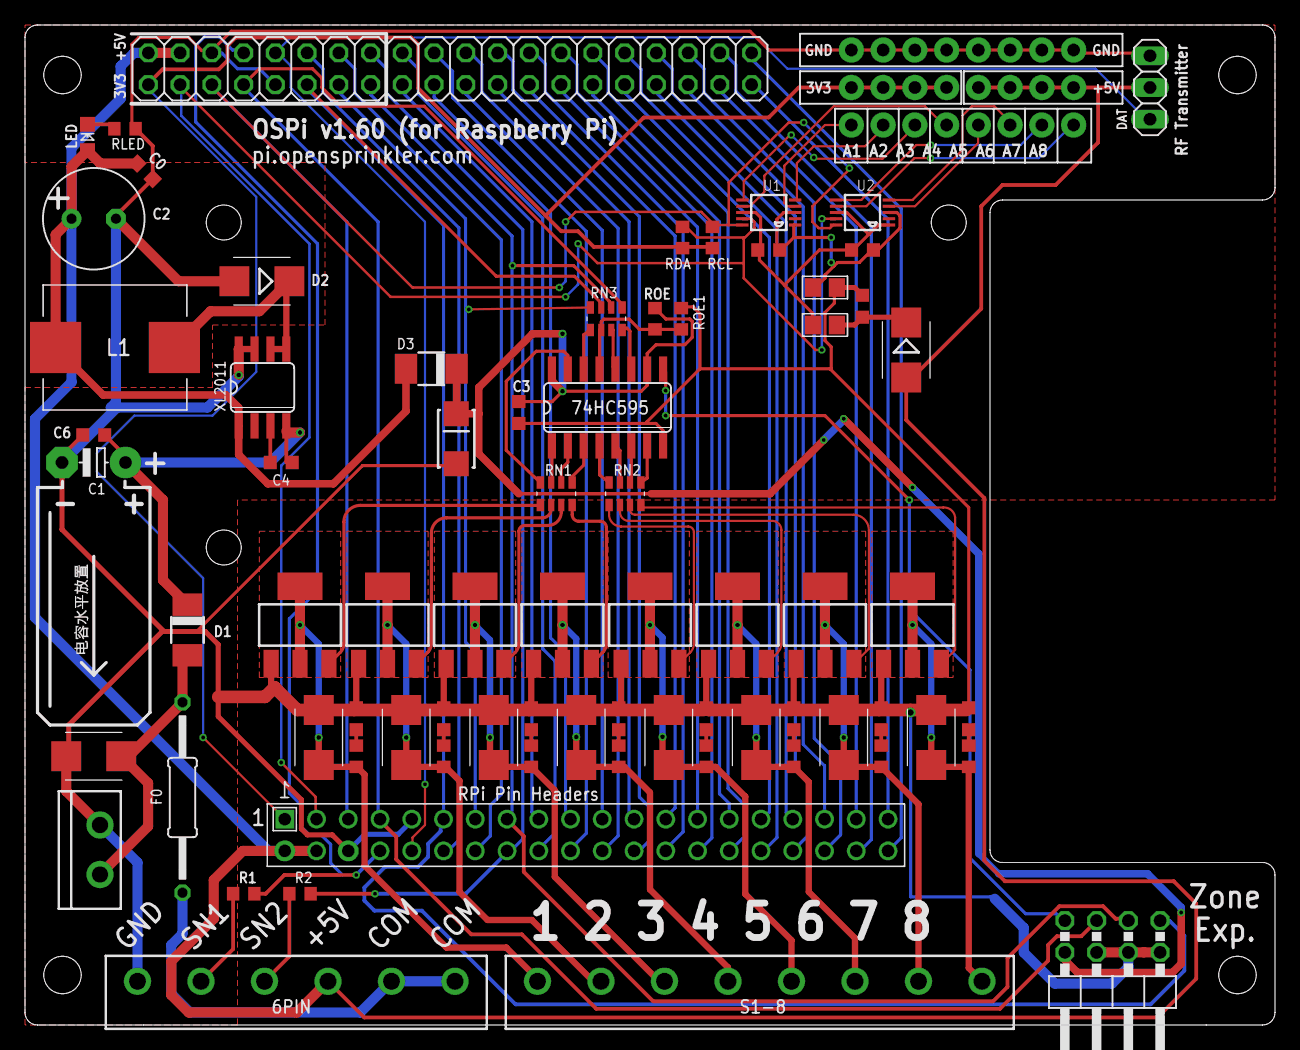
[picture p57: board ospi160.brd from above]

Board: 2 copper layers, 100.0 x 80.0 mm, 76 parts (1 on the bottom side), 95 nets.
