OpenSprinkler/OpenSprinkler-Hardware/OSPi/1.51/ospi151.brd

## EAGLE design OSPi/1.51/ospi151.brd (2021-08-04)

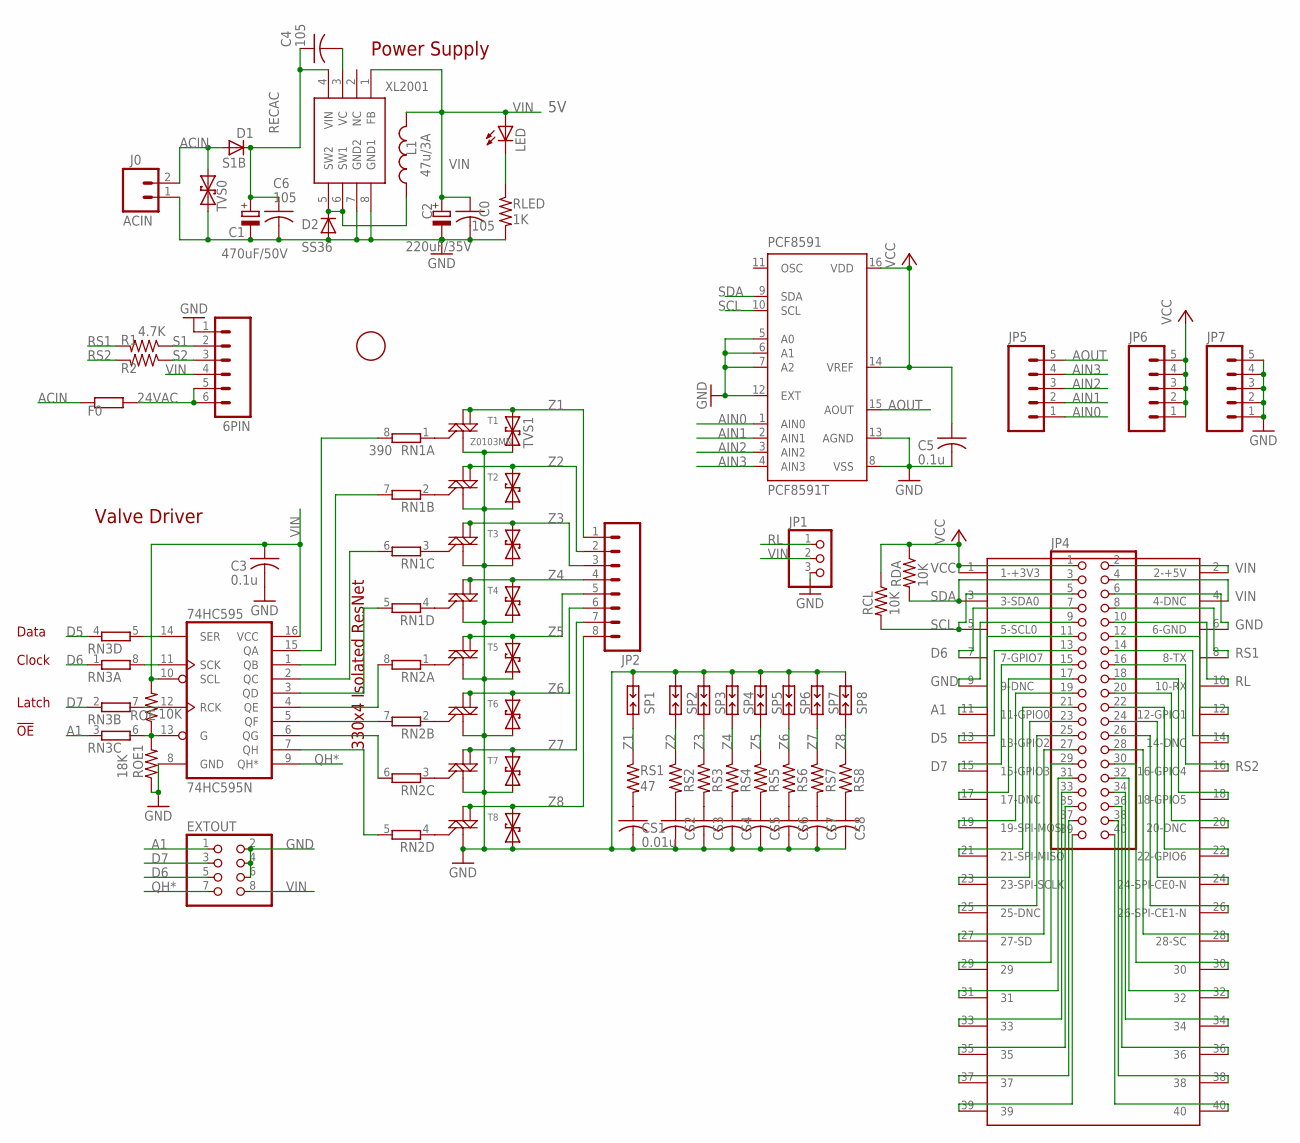
[picture p58: schematic ospi151.sch]

Parts:
1F: FIDUCIAL; FIDUCIAL_1MM
6PIN: M065MM; SCREWTERMINAL-5MM-6
74HC595: 74HC595N; SO16
C0, C4, C6: 105; C0603K
C1: 470uF/50V; E5-10,5
C2: 220uF/35V; E3,5-8
C3, C5: 0.1u; C0603K
CS1, CS2, CS3, CS4, CS5, CS6, CS7, CS8: 0.01u; C0603K
D1: S1B; DO-214AC
D2: SS36; SMB
EXTOUT: PINHD-2X4/90; 2X04/90
F0: R-EU_0207/15; 0207/15
J0: ACIN; SCREWTERMINAL-4MM-2-X
JP1: PINHD-1X3; 1X03
JP2: M085MM-8; SCREWTERMINAL-5MM-8
JP4: PINHD-2X20; 2X20
JP5, JP6, JP7: M05PTH; 1X05
L1: 47u/3A; YT1014
LED: LEDCHIPLED_0805; CHIPLED_0805
PCF8591: PCF8591T; SO16W
R1, R2: 4.7K; R0603
RCL: 10K; R0603
RDA: 10K; R0603
RLED: 1K; R0603
RN1, RN2, RN3: 390; EXB38V
ROE: 10K; R0603
ROE1: 18K; R0603
RS1, RS2, RS3, RS4, RS5, RS6, RS7, RS8: 47; R0603
SP1, SP2, SP3, SP4, SP5, SP6, SP7, SP8: PCB-SGAP
T1: Z0103MN; SOT223
T2, T3, T4, T5, T6, T7, T8: BT1308W; SOT223
TVS0, TVS1, TVS2, TVS3, TVS4, TVS5, TVS6, TVS7, TVS8: SMBJ45CA; SMB
U$2: RPIB+B+; RPIB+
XL2001: XL2011; SO08

Connections:
24VAC: 6PIN.5, 6PIN.6, F0.2
A1: EXTOUT.1, JP4.11, RN3.3 (1), U$2.11 (11-GPIO0)
ACIN: D1.A, F0.1, J0.2, TVS0.C
AIN0: JP5.1, PCF8591.1 (AIN0)
AIN1: JP5.2, PCF8591.2 (AIN1)
AIN2: JP5.3, PCF8591.3 (AIN2)
AIN3: JP5.4, PCF8591.4 (AIN3)
AOUT: JP5.5, PCF8591.15 (AOUT)
D5: JP4.13, RN3.4 (1), U$2.13 (13-GPIO2)
D6: EXTOUT.5, JP4.7, RN3.1, U$2.7 (7-GPIO7)
D7: EXTOUT.3, JP4.15, RN3.2 (1), U$2.15 (15-GPIO3)
GND: 6PIN.1, 74HC595.8 (GND), C0.2, C1.-, C2.-, C3.2, C5.2, C6.2, CS1.2, CS2.2, CS3.2, CS4.2, CS5.2, CS6.2, CS7.2, CS8.2, D2.A, EXTOUT.2, EXTOUT.4, EXTOUT.6, J0.1, JP1.3, JP4.6, JP4.9, JP7.1, JP7.2, JP7.3, JP7.4, JP7.5, PCF8591.5 (A0), PCF8591.6 (A1), PCF8591.7 (A2), PCF8591.8 (VSS), PCF8591.12 (EXT), PCF8591.13 (AGND), RLED.2, ROE1.1, SP1.1, SP2.1, SP3.1, SP4.1, SP5.1, SP6.1, SP7.1, SP8.1, T1.1 (M1), T2.1 (M1), T3.1 (M1), T4.1 (M1), T5.1 (M1), T6.1 (M1), T7.1 (M1), T8.1 (M1), TVS0.A, TVS1.C, TVS2.C, TVS3.C, TVS4.C, TVS5.C, TVS6.C, TVS7.C, TVS8.C, U$2.6 (6-GND), U$2.9 (9-DNC), XL2001.7 (GND2), XL2001.8 (GND1)
unnamed: LED.C, RLED.1
unnamed: RN1.1, T1.3 (G)
unnamed: 74HC595.5 (QF), RN2.7 (2)
unnamed: 74HC595.6 (QG), RN2.6 (2)
unnamed: RN1.2 (1), T2.3 (G)
unnamed: 74HC595.7 (QH), RN2.5 (2)
unnamed: CS1.1, RS1.2
unnamed: CS2.1, RS2.2
unnamed: 74HC595.4 (QE), RN2.8 (2)
unnamed: 74HC595.3 (QD), RN1.5 (2)
unnamed: 74HC595.2 (QC), RN1.6 (2)
unnamed: 74HC595.1 (QB), RN1.7 (2)
unnamed: 74HC595.15 (QA), RN1.8 (2)
unnamed: RN1.3 (1), T3.3 (G)
unnamed: CS3.1, RS3.2
unnamed: CS4.1, RS4.2
unnamed: CS5.1, RS5.2
unnamed: RN1.4 (1), T4.3 (G)
unnamed: CS6.1, RS6.2
unnamed: RN2.1, T5.3 (G)
unnamed: CS7.1, RS7.2
unnamed: CS8.1, RS8.2
unnamed: D2.C, L1.P$1 (1), XL2001.5 (SW2), XL2001.6 (SW1)
unnamed: C4.2, XL2001.3 (VC)
unnamed: RN2.2 (1), T6.3 (G)
unnamed: RN2.3 (1), T7.3 (G)
unnamed: RN2.4 (1), T8.3 (G)
unnamed: 74HC595.14 (SER), RN3.5 (2)
unnamed: 74HC595.11 (SCK), RN3.8 (2)
unnamed: 74HC595.12 (RCK), RN3.7 (2)
unnamed: JP4.12, U$2.12 (12-GPIO1)
unnamed: JP4.14, U$2.14 (14-DNC)
unnamed: 74HC595.13 (G), RN3.6 (2), ROE.1, ROE1.2
unnamed: JP4.23, U$2.23 (23-SPI-SCLK)
unnamed: JP4.25, U$2.25 (25-DNC)
unnamed: JP4.27, U$2.27 (27-SD)
unnamed: JP4.29, U$2.29
unnamed: JP4.39, U$2.39
unnamed: JP4.37, U$2.37
unnamed: JP4.17, U$2.17 (17-DNC)
unnamed: JP4.19, U$2.19 (19-SPI-MOSI)
unnamed: JP4.21, U$2.21 (21-SPI-MISO)
unnamed: JP4.35, U$2.35
unnamed: JP4.33, U$2.33
unnamed: JP4.31, U$2.31
unnamed: JP4.34, U$2.34
unnamed: JP4.36, U$2.36
unnamed: JP4.38, U$2.38
unnamed: JP4.40, U$2.40
unnamed: JP4.18, U$2.18 (18-GPIO5)
unnamed: JP4.20, U$2.20 (20-DNC)
unnamed: JP4.22, U$2.22 (22-GPIO6)
unnamed: JP4.24, U$2.24 (24-SPI-CE0-N)
unnamed: JP4.26, U$2.26 (26-SPI-CE1-N)
unnamed: JP4.28, U$2.28 (28-SC)
unnamed: JP4.30, U$2.30
unnamed: JP4.32, U$2.32
QH*: 74HC595.9 (QH*), EXTOUT.7
RECAC: C1.+, C4.1, C6.1, D1.C, XL2001.4 (VIN)
RL: JP1.1, JP4.10, U$2.10 (10-RX)
RS1: JP4.8, R1.2, U$2.8 (8-TX)
RS2: JP4.16, R2.2, U$2.16 (16-GPIO4)
S1: 6PIN.2, R1.1
S2: 6PIN.3, R2.1
SCL: JP4.5, PCF8591.10 (SCL), RCL.2, U$2.5 (5-SCL0)
SDA: JP4.3, PCF8591.9 (SDA), RDA.2, U$2.3 (3-SDA0)
VCC: C5.1, JP4.1, JP6.1, JP6.2, JP6.3, JP6.4, JP6.5, PCF8591.14 (VREF), PCF8591.16 (VDD), RCL.1, RDA.1, U$2.1 (1-+3V3)
VIN: 6PIN.4, 74HC595.10 (SCL), 74HC595.16 (VCC), C0.1, C2.+, C3.1, EXTOUT.8, JP1.2, JP4.2, JP4.4, L1.P$2 (2), LED.A, ROE.2, U$2.2 (2-+5V), U$2.4 (4-DNC), XL2001.1 (FB)
Z1: JP2.1, RS1.1, SP1.2, T1.2 (M2), T1.4 (M2-4), TVS1.A
Z2: JP2.2, RS2.1, SP2.2, T2.2 (M2), T2.4 (M2-4), TVS2.A
Z3: JP2.3, RS3.1, SP3.2, T3.2 (M2), T3.4 (M2-4), TVS3.A
Z4: JP2.4, RS4.1, SP4.2, T4.2 (M2), T4.4 (M2-4), TVS4.A
Z5: JP2.5, RS5.1, SP5.2, T5.2 (M2), T5.4 (M2-4), TVS5.A
Z6: JP2.6, RS6.1, SP6.2, T6.2 (M2), T6.4 (M2-4), TVS6.A
Z7: JP2.7, RS7.1, SP7.2, T7.2 (M2), T7.4 (M2-4), TVS7.A
Z8: JP2.8, RS8.1, SP8.2, T8.2 (M2), T8.4 (M2-4), TVS8.A

Notes on the sheet:
Power Supply
Valve Driver
Data
Clock
Latch
330x4 Isolated ResNet
!OE

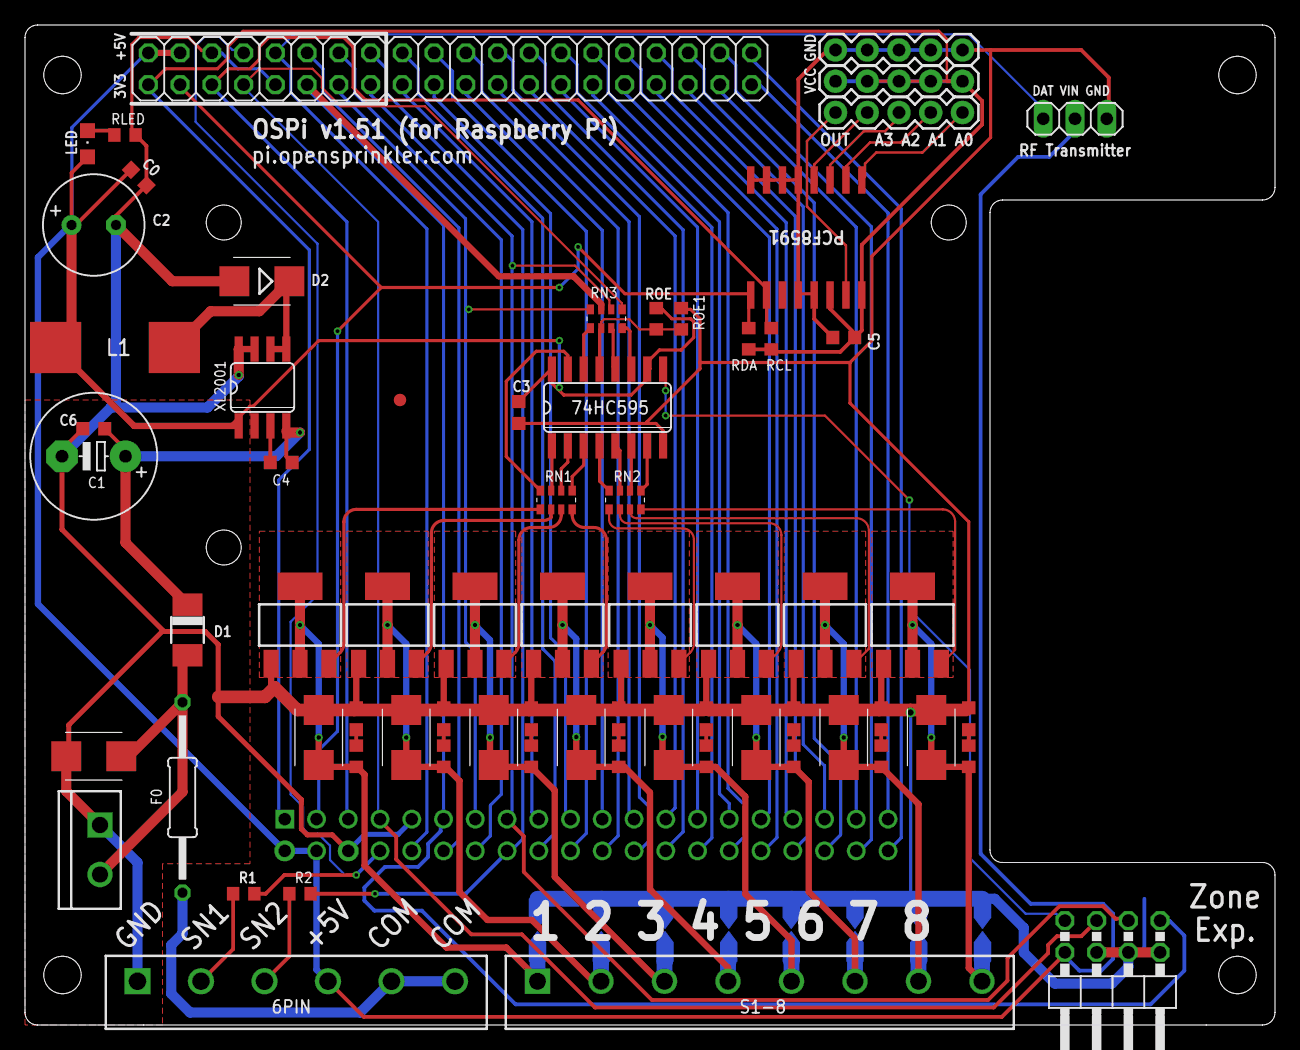
[picture p59: board ospi151.brd from above]

Board: 2 copper layers, 100.0 x 80.0 mm, 77 parts (1 on the bottom side), 88 nets.
