OpenSprinkler/OpenSprinkler-Hardware/Expander/3.0/DC/exp31dc.brd

## EAGLE design Expander/3.0/DC/exp31dc.brd (2019-06-13)

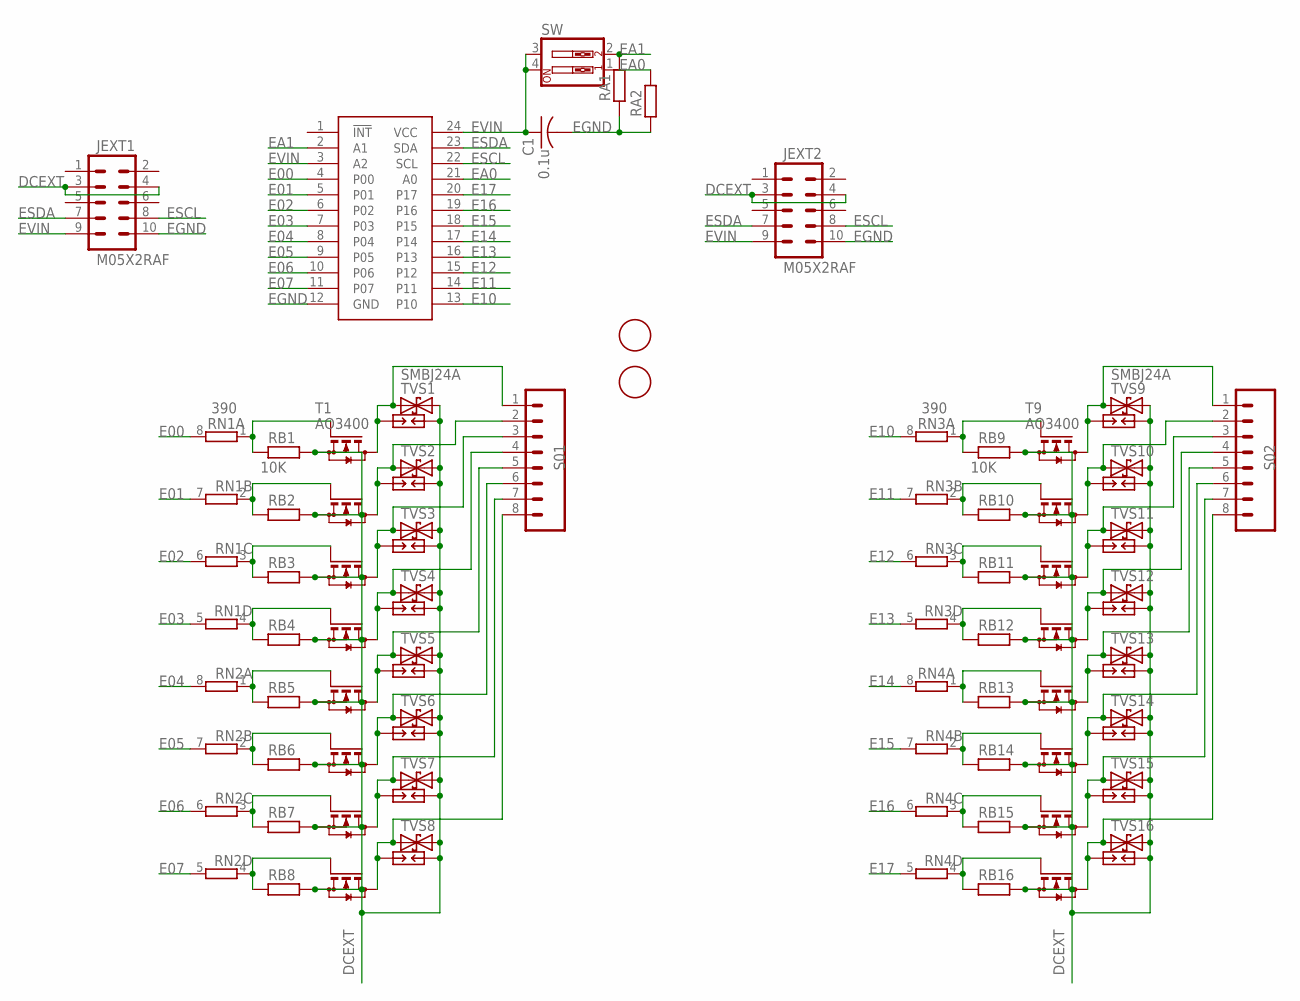
[picture p62: schematic exp31dc.sch]

Parts:
C1: 0.1u; C0603
JEXT1, JEXT2: M05X2RAF; 2X5-RAF
PCA9555: PCA9555; TSSOP24
RA1, RA2: 10K; R0603
RB1, RB2, RB3, RB4, RB5, RB6, RB7, RB8, RB9, RB10, RB11, RB12, RB13, RB14, RB15, RB16: 10K; R0603
RN1, RN2, RN3, RN4: 390; EXB38V
S01, S02: M085MM-8; SCREWTERMINAL-5MM-8
SP1, SP2, SP3, SP4, SP5, SP6, SP7, SP8, SP9, SP10, SP11, SP12, SP13, SP14, SP15, SP16: PCB-SGAP
SW: SW_DIP-2; DIPSWITCH-02
T1, T2, T3, T4, T5, T6, T7, T8, T9, T10, T11, T12, T13, T14, T15, T16: AO3400; SOT23
TVS1, TVS2, TVS3, TVS4, TVS5, TVS6, TVS7, TVS8, TVS9, TVS10, TVS11, TVS12, TVS13, TVS14, TVS15, TVS16: SMBJ24A; SMB
U$1, U$2: FIDUCIAL; FIDUCIAL_1MM

Connections:
DCEXT: JEXT1.3, JEXT1.4, JEXT2.3, JEXT2.4, RB1.1, RB2.1, RB3.1, RB4.1, RB5.1, RB6.1, RB7.1, RB8.1, RB9.1, RB10.1, RB11.1, RB12.1, RB13.1, RB14.1, RB15.1, RB16.1, SP1.1, SP2.1, SP3.1, SP4.1, SP5.1, SP6.1, SP7.1, SP8.1, SP9.1, SP10.1, SP11.1, SP12.1, SP13.1, SP14.1, SP15.1, SP16.1, T1.2 (S), T2.2 (S), T3.2 (S), T4.2 (S), T5.2 (S), T6.2 (S), T7.2 (S), T8.2 (S), T9.2 (S), T10.2 (S), T11.2 (S), T12.2 (S), T13.2 (S), T14.2 (S), T15.2 (S), T16.2 (S), TVS1.C, TVS2.C, TVS3.C, TVS4.C, TVS5.C, TVS6.C, TVS7.C, TVS8.C, TVS9.C, TVS10.C, TVS11.C, TVS12.C, TVS13.C, TVS14.C, TVS15.C, TVS16.C
E00: PCA9555.4 (P00), RN1.8 (2)
E01: PCA9555.5 (P01), RN1.7 (2)
E02: PCA9555.6 (P02), RN1.6 (2)
E03: PCA9555.7 (P03), RN1.5 (2)
E04: PCA9555.8 (P04), RN2.8 (2)
E05: PCA9555.9 (P05), RN2.7 (2)
E06: PCA9555.10 (P06), RN2.6 (2)
E07: PCA9555.11 (P07), RN2.5 (2)
E10: PCA9555.13 (P10), RN3.8 (2)
E11: PCA9555.14 (P11), RN3.7 (2)
E12: PCA9555.15 (P12), RN3.6 (2)
E13: PCA9555.16 (P13), RN3.5 (2)
E14: PCA9555.17 (P14), RN4.8 (2)
E15: PCA9555.18 (P15), RN4.7 (2)
E16: PCA9555.19 (P16), RN4.6 (2)
E17: PCA9555.20 (P17), RN4.5 (2)
EA0: PCA9555.21 (A0), RA2.1, SW.1
EA1: PCA9555.2 (A1), RA1.1, SW.2
EGND: C1.2, JEXT1.10, JEXT2.10, PCA9555.12 (GND), RA1.2, RA2.2
ESCL: JEXT1.8, JEXT2.8, PCA9555.22 (SCL)
ESDA: JEXT1.7, JEXT2.7, PCA9555.23 (SDA)
EVIN: C1.1, JEXT1.9, JEXT2.9, PCA9555.3 (A2), PCA9555.24 (VCC), SW.3, SW.4
unnamed: RB9.2, RN3.1, T9.1 (G)
unnamed: RB4.2, RN1.4 (1), T4.1 (G)
unnamed: RB3.2, RN1.3 (1), T3.1 (G)
unnamed: RB1.2, RN1.1, T1.1 (G)
unnamed: RB2.2, RN1.2 (1), T2.1 (G)
unnamed: RB10.2, RN3.2 (1), T10.1 (G)
unnamed: RB5.2, RN2.1, T5.1 (G)
unnamed: RB6.2, RN2.2 (1), T6.1 (G)
unnamed: RB7.2, RN2.3 (1), T7.1 (G)
unnamed: RB8.2, RN2.4 (1), T8.1 (G)
unnamed: RB11.2, RN3.3 (1), T11.1 (G)
unnamed: RB12.2, RN3.4 (1), T12.1 (G)
unnamed: RB13.2, RN4.1, T13.1 (G)
unnamed: RB14.2, RN4.2 (1), T14.1 (G)
unnamed: RB15.2, RN4.3 (1), T15.1 (G)
unnamed: RB16.2, RN4.4 (1), T16.1 (G)
unnamed: S02.1, SP9.2, T9.3 (D), TVS9.A
unnamed: S02.2, SP10.2, T10.3 (D), TVS10.A
unnamed: S02.3, SP11.2, T11.3 (D), TVS11.A
unnamed: S02.4, SP12.2, T12.3 (D), TVS12.A
unnamed: S02.5, SP13.2, T13.3 (D), TVS13.A
unnamed: S02.6, SP14.2, T14.3 (D), TVS14.A
unnamed: S02.7, SP15.2, T15.3 (D), TVS15.A
unnamed: S02.8, SP16.2, T16.3 (D), TVS16.A
unnamed: S01.1, SP1.2, T1.3 (D), TVS1.A
unnamed: S01.2, SP2.2, T2.3 (D), TVS2.A
unnamed: S01.3, SP3.2, T3.3 (D), TVS3.A
unnamed: S01.4, SP4.2, T4.3 (D), TVS4.A
unnamed: S01.5, SP5.2, T5.3 (D), TVS5.A
unnamed: S01.6, SP6.2, T6.3 (D), TVS6.A
unnamed: S01.7, SP7.2, T7.3 (D), TVS7.A
unnamed: S01.8, SP8.2, T8.3 (D), TVS8.A

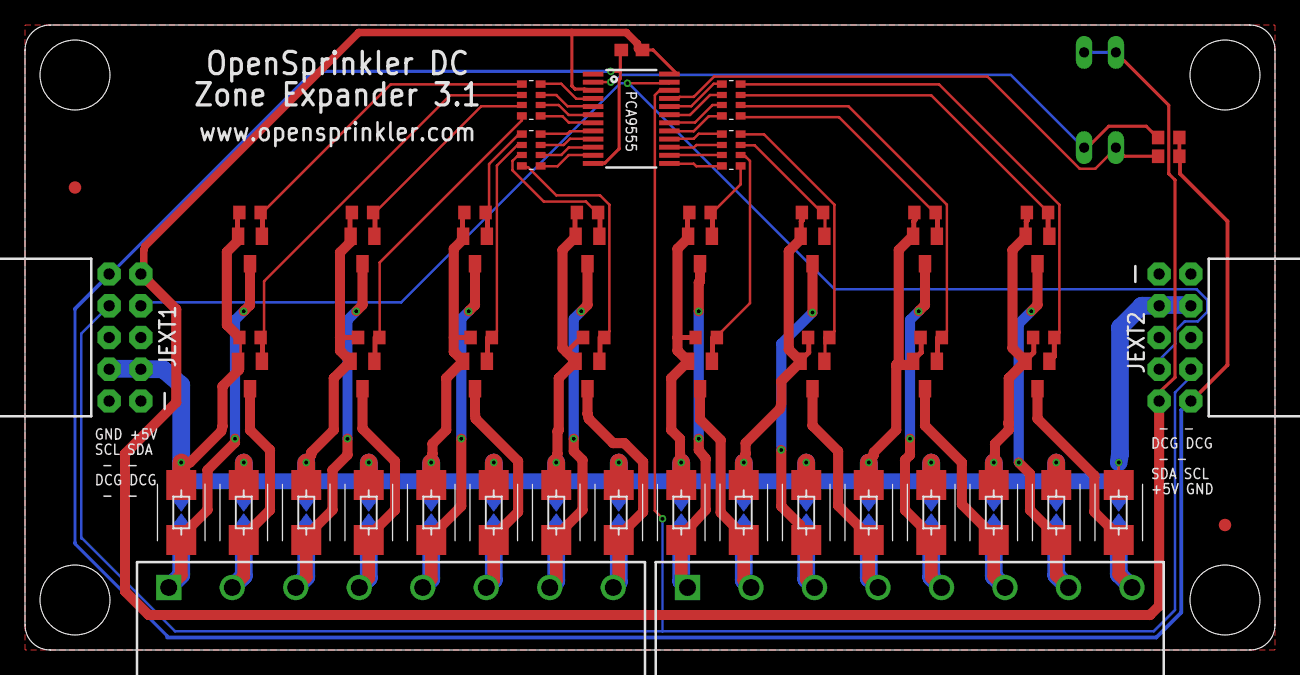
[picture p63: board exp31dc.brd from above]

Board: 2 copper layers, 100.0 x 50.0 mm, 79 parts (1 on the bottom side), 55 nets.
