OpenSprinkler/OpenSprinkler-Hardware/Expander/2.1/DC/exp21dc.brd

## EAGLE design Expander/2.1/DC/exp21dc.brd (2017-06-06)

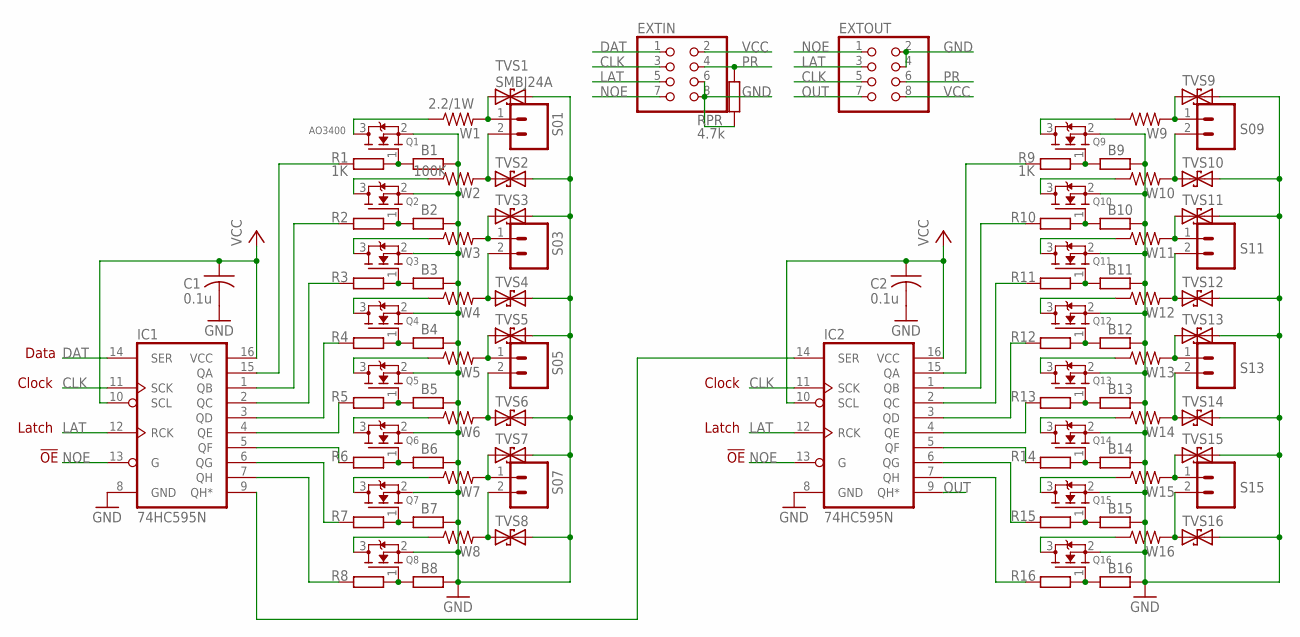
[picture p66: schematic exp21dc.sch]

Parts:
B1, B2, B3, B4, B5, B6, B7, B8, B9, B10, B11, B12, B13, B14, B15, B16: 100K; R0603
C1, C2: 0.1u; C0603K
EXTIN: PINHD-2X4/90; 2X04/90
EXTOUT: PINHD-2X4/90; 2X04/90
IC1, IC2: 74HC595N; SO16
Q1: AO3400; SOT23
Q2, Q3, Q4, Q5, Q6, Q7, Q8, Q9, Q10, Q11, Q12, Q13, Q14, Q15, Q16: MOSFET-NREFLOW; SOT23
R1, R2, R3, R4, R5, R6, R7, R8, R9, R10, R11, R12, R13, R14, R15, R16: 1K; R0603
RPR: 4.7k; R0603
S01, S03, S05, S07, S09, S11, S13, S15: M025MM-X; SCREWTERMINAL-5MM-2-X
TVS1: SMBJ24A; SMB
TVS2, TVS3, TVS4, TVS5, TVS6, TVS7, TVS8, TVS9, TVS10, TVS11, TVS12, TVS13, TVS14, TVS15, TVS16: TVSSMB; SMB
W1: 2.2/1W; R2512
W2, W3, W4, W5, W6, W7, W8, W9, W10, W11, W12, W13, W14, W15, W16: R-US_R2512; R2512

Connections:
CLK: EXTIN.3, EXTOUT.5, IC1.11 (SCK), IC2.11 (SCK)
DAT: EXTIN.1, IC1.14 (SER)
GND: B1.1, B2.1, B3.1, B4.1, B5.1, B6.1, B7.1, B8.1, B9.1, B10.1, B11.1, B12.1, B13.1, B14.1, B15.1, B16.1, C1.2, C2.2, EXTIN.6, EXTIN.8, EXTOUT.2, EXTOUT.4, IC1.8 (GND), IC2.8 (GND), Q1.2 (S), Q2.2 (S), Q3.2 (S), Q4.2 (S), Q5.2 (S), Q6.2 (S), Q7.2 (S), Q8.2 (S), Q9.2 (S), Q10.2 (S), Q11.2 (S), Q12.2 (S), Q13.2 (S), Q14.2 (S), Q15.2 (S), Q16.2 (S), RPR.1, TVS1.C (2), TVS2.C (2), TVS3.C (2), TVS4.C (2), TVS5.C (2), TVS6.C (2), TVS7.C (2), TVS8.C (2), TVS9.C (2), TVS10.C (2), TVS11.C (2), TVS12.C (2), TVS13.C (2), TVS14.C (2), TVS15.C (2), TVS16.C (2)
LAT: EXTIN.5, EXTOUT.3, IC1.12 (RCK), IC2.12 (RCK)
unnamed: S01.1, TVS1.A (1), W1.2
unnamed: S03.1, TVS3.A (1), W3.2
unnamed: S05.1, TVS5.A (1), W5.2
unnamed: IC1.5 (QF), R6.2
unnamed: IC1.6 (QG), R7.2
unnamed: S07.1, TVS7.A (1), W7.2
unnamed: IC1.7 (QH), R8.2
unnamed: B1.2, Q1.1 (G), R1.1
unnamed: Q1.3 (D), W1.1
unnamed: IC1.4 (QE), R5.2
unnamed: IC1.3 (QD), R4.2
unnamed: IC1.2 (QC), R3.2
unnamed: IC1.1 (QB), R2.2
unnamed: IC1.15 (QA), R1.2
unnamed: B2.2, Q2.1 (G), R2.1
unnamed: Q2.3 (D), W2.1
unnamed: S01.2, TVS2.A (1), W2.2
unnamed: B3.2, Q3.1 (G), R3.1
unnamed: Q3.3 (D), W3.1
unnamed: S03.2, TVS4.A (1), W4.2
unnamed: B4.2, Q4.1 (G), R4.1
unnamed: Q4.3 (D), W4.1
unnamed: S05.2, TVS6.A (1), W6.2
unnamed: IC2.5 (QF), R14.2
unnamed: S07.2, TVS8.A (1), W8.2
unnamed: IC2.6 (QG), R15.2
unnamed: IC2.7 (QH), R16.2
unnamed: IC2.4 (QE), R13.2
unnamed: IC2.3 (QD), R12.2
unnamed: IC2.2 (QC), R11.2
unnamed: IC2.1 (QB), R10.2
unnamed: IC2.15 (QA), R9.2
unnamed: S09.2, TVS10.A (1), W10.2
unnamed: S11.2, TVS12.A (1), W12.2
unnamed: S13.2, TVS14.A (1), W14.2
unnamed: S15.2, TVS16.A (1), W16.2
unnamed: S09.1, TVS9.A (1), W9.2
unnamed: S11.1, TVS11.A (1), W11.2
unnamed: S13.1, TVS13.A (1), W13.2
unnamed: S15.1, TVS15.A (1), W15.2
unnamed: B9.2, Q9.1 (G), R9.1
unnamed: B10.2, Q10.1 (G), R10.1
unnamed: B11.2, Q11.1 (G), R11.1
unnamed: B12.2, Q12.1 (G), R12.1
unnamed: B13.2, Q13.1 (G), R13.1
unnamed: B14.2, Q14.1 (G), R14.1
unnamed: B15.2, Q15.1 (G), R15.1
unnamed: B16.2, Q16.1 (G), R16.1
unnamed: IC1.9 (QH*), IC2.14 (SER)
unnamed: B5.2, Q5.1 (G), R5.1
unnamed: B6.2, Q6.1 (G), R6.1
unnamed: B7.2, Q7.1 (G), R7.1
unnamed: B8.2, Q8.1 (G), R8.1
unnamed: Q5.3 (D), W5.1
unnamed: Q6.3 (D), W6.1
unnamed: Q7.3 (D), W7.1
unnamed: Q8.3 (D), W8.1
unnamed: Q9.3 (D), W9.1
unnamed: Q10.3 (D), W10.1
unnamed: Q11.3 (D), W11.1
unnamed: Q12.3 (D), W12.1
unnamed: Q13.3 (D), W13.1
unnamed: Q14.3 (D), W14.1
unnamed: Q15.3 (D), W15.1
unnamed: Q16.3 (D), W16.1
NOE: EXTIN.7, EXTOUT.1, IC1.13 (G), IC2.13 (G)
OUT: EXTOUT.7, IC2.9 (QH*)
PR: EXTIN.4, EXTOUT.6, RPR.2
VCC: C1.1, C2.1, EXTIN.2, EXTOUT.8, IC1.10 (SCL), IC1.16 (VCC), IC2.10 (SCL), IC2.16 (VCC)

Notes on the sheet:
Data
Clock
Latch
!OE

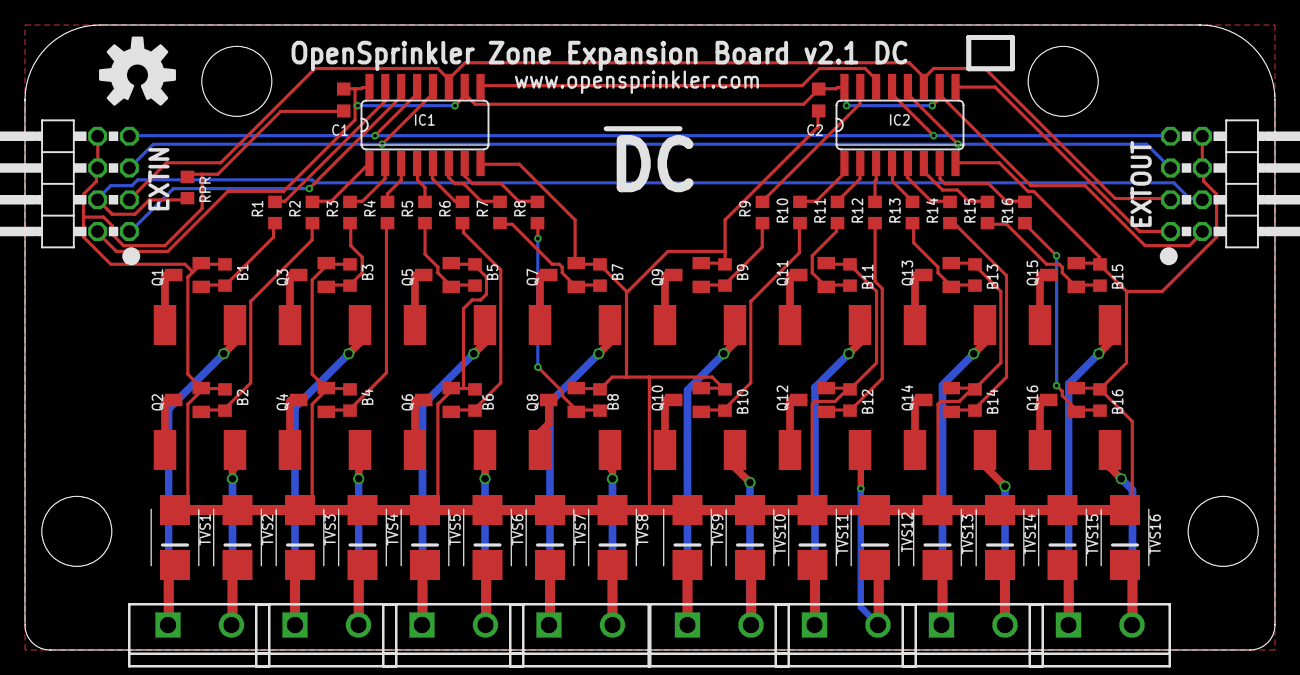
[picture p67: board exp21dc.brd from above]

Board: 2 copper layers, 100.0 x 50.0 mm, 95 parts (0 on the bottom side), 73 nets.
