OpenSprinkler/OpenSprinkler-Hardware/Expander/3.0/DC/exp30dc.brd

## EAGLE design Expander/3.0/DC/exp30dc.brd (2017-06-06)

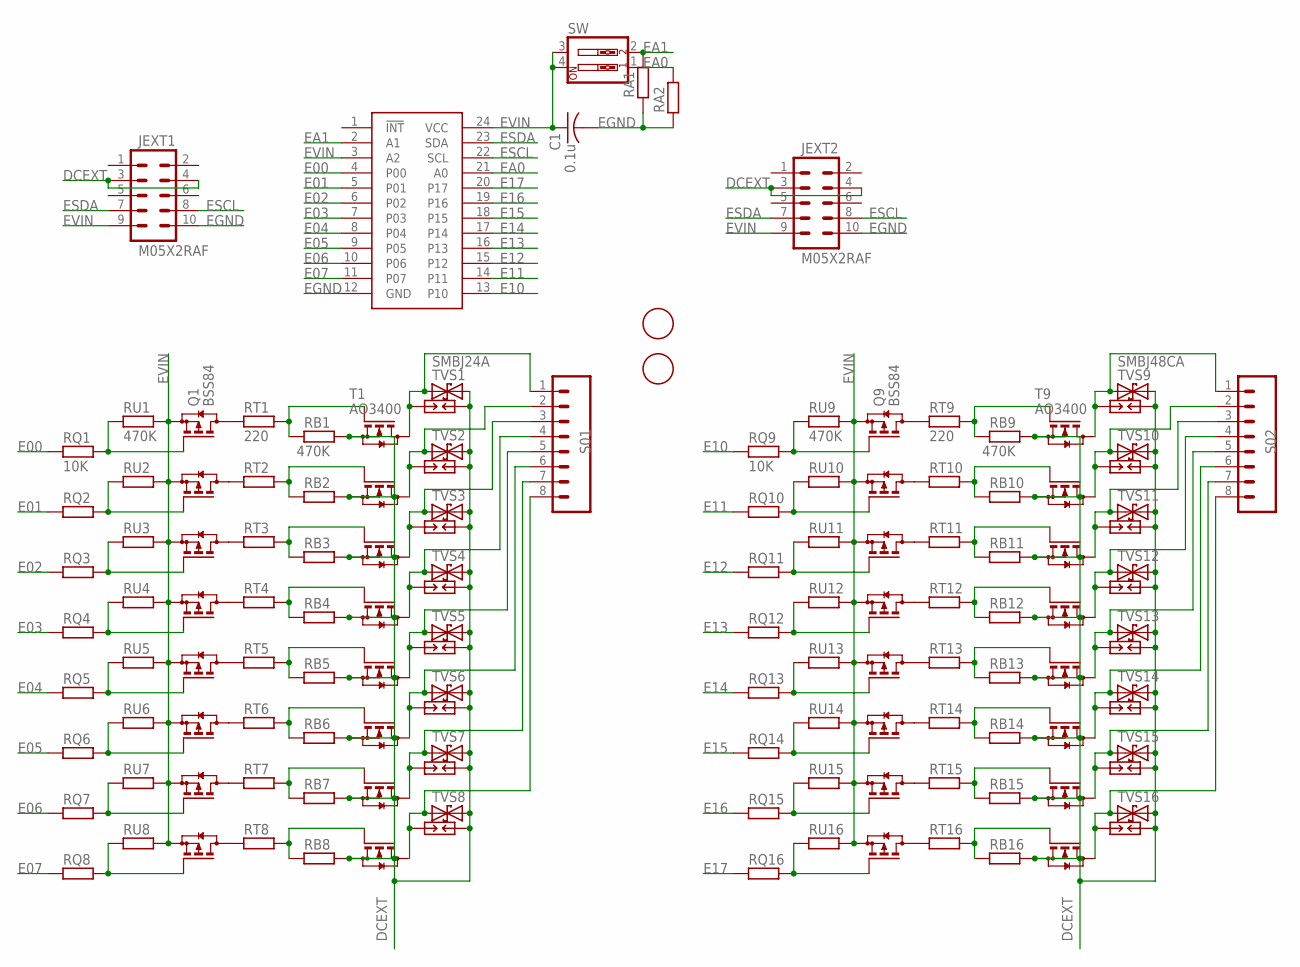
[picture p68: schematic exp30dc.sch]

Parts:
C1: 0.1u; C0603
JEXT1, JEXT2: M05X2RAF; 2X5-RAF
PCF8575: PCF8575; SSOP24
Q1, Q2, Q3, Q4, Q5, Q6, Q7, Q8, Q9, Q10, Q11, Q12, Q13, Q14, Q15, Q16: BSS84; SOT23
RA1, RA2: 10K; R0603
RB1, RB2, RB3, RB4, RB5, RB6, RB7, RB8, RB9, RB10, RB11, RB12, RB13, RB14, RB15, RB16: 470K; R0603
RQ1, RQ2, RQ3, RQ4, RQ5, RQ6, RQ7, RQ8, RQ9, RQ10, RQ11, RQ12, RQ13, RQ14, RQ15, RQ16: 10K; R0603
RT1, RT2, RT3, RT4, RT5, RT6, RT7, RT8, RT9, RT10, RT11, RT12, RT13, RT14, RT15, RT16: 220; R0603
RU1, RU2, RU3, RU4, RU5, RU6, RU7, RU8, RU9, RU10, RU11, RU12, RU13, RU14, RU15, RU16: 470K; R0603
S01, S02: M085MM-8; SCREWTERMINAL-5MM-8
SP1, SP2, SP3, SP4, SP5, SP6, SP7, SP8, SP9, SP10, SP11, SP12, SP13, SP14, SP15, SP16: PCB-SGAP
SW: SW_DIP-2; DIPSWITCH-02
T1, T2, T3, T4, T5, T6, T7, T8, T9, T10, T11, T12, T13, T14, T15, T16: AO3400; SOT23
TVS1: SMBJ24A; SMB
TVS2, TVS3, TVS4, TVS5, TVS6, TVS7, TVS8, TVS10, TVS11, TVS12, TVS13, TVS14, TVS15, TVS16: TVSSMB; SMB
TVS9: SMBJ48CA; SMB
U$1, U$2: FIDUCIAL; FIDUCIAL_1MM

Connections:
DCEXT: JEXT1.3, JEXT1.4, JEXT2.3, JEXT2.4, RB1.1, RB2.1, RB3.1, RB4.1, RB5.1, RB6.1, RB7.1, RB8.1, RB9.1, RB10.1, RB11.1, RB12.1, RB13.1, RB14.1, RB15.1, RB16.1, SP1.1, SP2.1, SP3.1, SP4.1, SP5.1, SP6.1, SP7.1, SP8.1, SP9.1, SP10.1, SP11.1, SP12.1, SP13.1, SP14.1, SP15.1, SP16.1, T1.2 (S), T2.2 (S), T3.2 (S), T4.2 (S), T5.2 (S), T6.2 (S), T7.2 (S), T8.2 (S), T9.2 (S), T10.2 (S), T11.2 (S), T12.2 (S), T13.2 (S), T14.2 (S), T15.2 (S), T16.2 (S), TVS1.C, TVS2.C, TVS3.C, TVS4.C, TVS5.C, TVS6.C, TVS7.C, TVS8.C, TVS9.C, TVS10.C, TVS11.C, TVS12.C, TVS13.C, TVS14.C, TVS15.C, TVS16.C
E00: PCF8575.4 (P00), RQ1.2
E01: PCF8575.5 (P01), RQ2.2
E02: PCF8575.6 (P02), RQ3.2
E03: PCF8575.7 (P03), RQ4.2
E04: PCF8575.8 (P04), RQ5.2
E05: PCF8575.9 (P05), RQ6.2
E06: PCF8575.10 (P06), RQ7.2
E07: PCF8575.11 (P07), RQ8.2
E10: PCF8575.13 (P10), RQ9.2
E11: PCF8575.14 (P11), RQ10.2
E12: PCF8575.15 (P12), RQ11.2
E13: PCF8575.16 (P13), RQ12.2
E14: PCF8575.17 (P14), RQ13.2
E15: PCF8575.18 (P15), RQ14.2
E16: PCF8575.19 (P16), RQ15.2
E17: PCF8575.20 (P17), RQ16.2
EA0: PCF8575.21 (A0), RA2.1, SW.1
EA1: PCF8575.2 (A1), RA1.1, SW.2
EGND: C1.2, JEXT1.10, JEXT2.10, PCF8575.12 (GND), RA1.2, RA2.2
ESCL: JEXT1.8, JEXT2.8, PCF8575.22 (SCL)
ESDA: JEXT1.7, JEXT2.7, PCF8575.23 (SDA)
EVIN: C1.1, JEXT1.9, JEXT2.9, PCF8575.3 (A2), PCF8575.24 (VCC), Q1.2 (S), Q2.2 (S), Q3.2 (S), Q4.2 (S), Q5.2 (S), Q6.2 (S), Q7.2 (S), Q8.2 (S), Q9.2 (S), Q10.2 (S), Q11.2 (S), Q12.2 (S), Q13.2 (S), Q14.2 (S), Q15.2 (S), Q16.2 (S), RU1.1, RU2.1, RU3.1, RU4.1, RU5.1, RU6.1, RU7.1, RU8.1, RU9.1, RU10.1, RU11.1, RU12.1, RU13.1, RU14.1, RU15.1, RU16.1, SW.3, SW.4
unnamed: RB9.2, RT9.1, T9.1 (G)
unnamed: Q1.3 (D), RT1.2
unnamed: Q2.3 (D), RT2.2
unnamed: Q3.3 (D), RT3.2
unnamed: Q4.3 (D), RT4.2
unnamed: Q5.3 (D), RT5.2
unnamed: Q6.3 (D), RT6.2
unnamed: RB1.2, RT1.1, T1.1 (G)
unnamed: RB2.2, RT2.1, T2.1 (G)
unnamed: Q7.3 (D), RT7.2
unnamed: Q8.3 (D), RT8.2
unnamed: Q1.1 (G), RQ1.1, RU1.2
unnamed: Q2.1 (G), RQ2.1, RU2.2
unnamed: Q3.1 (G), RQ3.1, RU3.2
unnamed: RB3.2, RT3.1, T3.1 (G)
unnamed: RB4.2, RT4.1, T4.1 (G)
unnamed: RB10.2, RT10.1, T10.1 (G)
unnamed: RB5.2, RT5.1, T5.1 (G)
unnamed: RB6.2, RT6.1, T6.1 (G)
unnamed: Q4.1 (G), RQ4.1, RU4.2
unnamed: RB7.2, RT7.1, T7.1 (G)
unnamed: RB8.2, RT8.1, T8.1 (G)
unnamed: Q5.1 (G), RQ5.1, RU5.2
unnamed: RB11.2, RT11.1, T11.1 (G)
unnamed: Q6.1 (G), RQ6.1, RU6.2
unnamed: RB12.2, RT12.1, T12.1 (G)
unnamed: RB13.2, RT13.1, T13.1 (G)
unnamed: RB14.2, RT14.1, T14.1 (G)
unnamed: RB15.2, RT15.1, T15.1 (G)
unnamed: RB16.2, RT16.1, T16.1 (G)
unnamed: Q7.1 (G), RQ7.1, RU7.2
unnamed: Q8.1 (G), RQ8.1, RU8.2
unnamed: S02.1, SP9.2, T9.3 (D), TVS9.A
unnamed: S02.2, SP10.2, T10.3 (D), TVS10.A
unnamed: S02.3, SP11.2, T11.3 (D), TVS11.A
unnamed: S02.4, SP12.2, T12.3 (D), TVS12.A
unnamed: S02.5, SP13.2, T13.3 (D), TVS13.A
unnamed: S02.6, SP14.2, T14.3 (D), TVS14.A
unnamed: S02.7, SP15.2, T15.3 (D), TVS15.A
unnamed: S02.8, SP16.2, T16.3 (D), TVS16.A
unnamed: Q9.3 (D), RT9.2
unnamed: Q10.3 (D), RT10.2
unnamed: Q11.3 (D), RT11.2
unnamed: Q12.3 (D), RT12.2
unnamed: Q13.3 (D), RT13.2
unnamed: Q14.3 (D), RT14.2
unnamed: Q15.3 (D), RT15.2
unnamed: Q16.3 (D), RT16.2
unnamed: Q9.1 (G), RQ9.1, RU9.2
unnamed: S01.1, SP1.2, T1.3 (D), TVS1.A
unnamed: S01.2, SP2.2, T2.3 (D), TVS2.A
unnamed: S01.3, SP3.2, T3.3 (D), TVS3.A
unnamed: S01.4, SP4.2, T4.3 (D), TVS4.A
unnamed: S01.5, SP5.2, T5.3 (D), TVS5.A
unnamed: S01.6, SP6.2, T6.3 (D), TVS6.A
unnamed: S01.7, SP7.2, T7.3 (D), TVS7.A
unnamed: S01.8, SP8.2, T8.3 (D), TVS8.A
unnamed: Q10.1 (G), RQ10.1, RU10.2
unnamed: Q11.1 (G), RQ11.1, RU11.2
unnamed: Q12.1 (G), RQ12.1, RU12.2
unnamed: Q13.1 (G), RQ13.1, RU13.2
unnamed: Q14.1 (G), RQ14.1, RU14.2
unnamed: Q15.1 (G), RQ15.1, RU15.2
unnamed: Q16.1 (G), RQ16.1, RU16.2

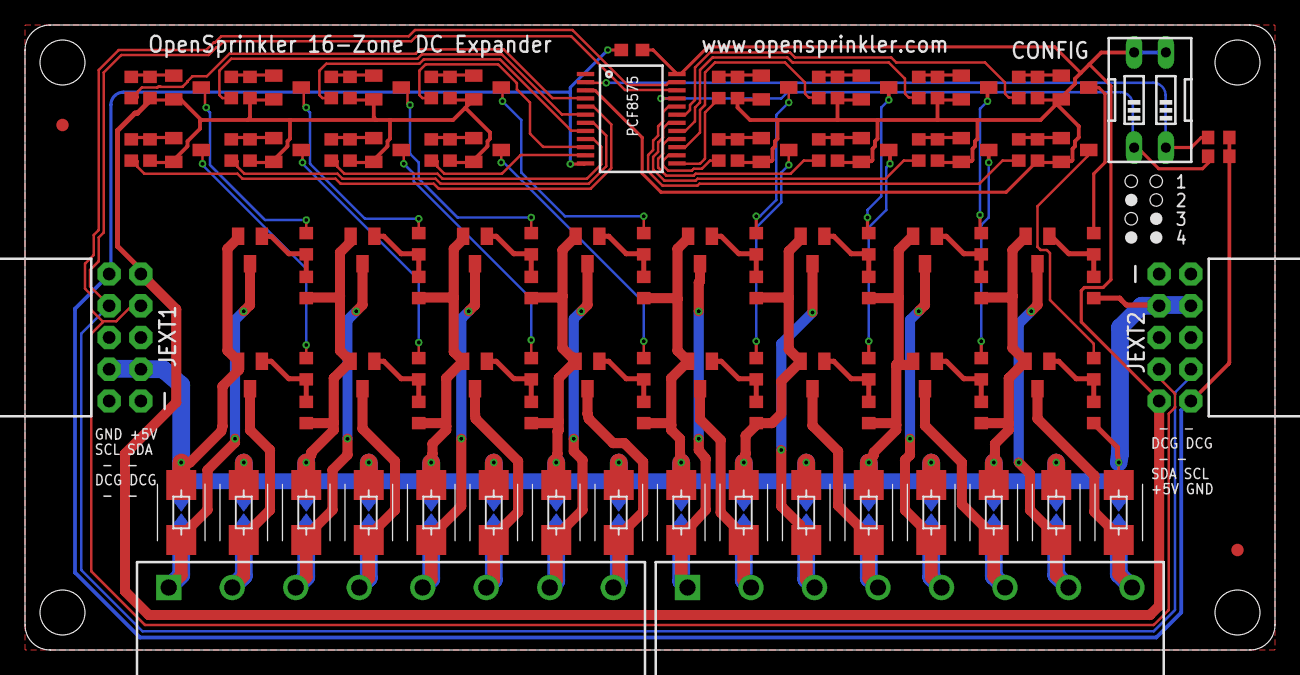
[picture p69: board exp30dc.brd from above]

Board: 2 copper layers, 100.0 x 50.0 mm, 139 parts (0 on the bottom side), 87 nets.
