OpenSprinkler/OpenSprinkler-Hardware/(commit log)

2017-06-06 add all hardware design files
    [acdr.brd, acdr.sch, dcdr.brd, dcdr.sch, exp21ac.brd, exp21ac.sch, exp21dc.brd, exp21dc.sch]
2018-06-08 add expander 3.0 revision 1
    [exp31ac.brd, exp31ac.sch, exp31dc.brd, exp31dc.sch]
2018-06-08 add OS3.0 revision 1 design; rename ac/dc driver board files
    [acdr_3.0.brd, acdr_3.0.sch, dcdr_3.0.brd, dcdr_3.0.sch, os31_master.brd, os31_master.sch]
2018-06-08 add AC driver 3.1 and DC driver 3.1
    [acdr_3.1.brd, acdr_3.1.sch, dcdr_3.1.brd, dcdr_3.1.sch]
2019-06-13 check in OS 3.2 design files; modify readme
    [acdr_3.2.brd, acdr_3.2.sch, dcdr_3.2.brd, dcdr_3.2.sch, exp31ac.brd, exp31dc.brd, os32_master.brd, os32_master.sch]
2019-06-14 add latch 3.1 driver board
    [latdr31.brd, latdr31.sch]
2020-06-19 add ospi 1.44, 1.5 hardware files; move ospi 1.43 files out of AC folder
    [ospi143.brd, ospi143.sch, ospi144.brd, ospi144.sch, ospi150.brd, ospi150.sch]
2021-08-04 add OSPi 1.51 hardware design files
    [ospi151.brd, ospi151.sch]
2021-09-10 add schematic PNG for acdr_3.2
2021-09-10 correct the pull down resistor value
    [acdr_3.2.brd, acdr_3.2.sch]
2021-10-09 correcting os3.2 dc driver part number
    [dcdr_3.2.brd, dcdr_3.2.sch]
2022-09-04 add ospi version 1.52 eagle files
    [ospi152.brd, ospi152.sch]
2022-09-12 add ospi152 3D printable enclosure design
    [OSPi152.stl, OSPi152_no_frontpanel.stl]
2022-09-13 check in laser cut acrylic enclosure design
2022-09-13 check in readme for laser cut design
2023-12-19 add OS3.3 master board design files
    [os33_master.brd, os33_master.sch, ospi152.brd, ospi152.sch]
2024-04-23 add updated ac driver design files
    [acdr_3.2_updated.brd, acdr_3.2_updated.sch]
2024-09-07 add OSPi v1.60 hardware design files
    [ospi160.brd, ospi160.sch]
2024-09-26 add ospi20 hardware design files; reorganize enclosure folder
    [OSPi152.stl, OSPi152_no_frontpanel.stl, ospi20_bom.xlsx]
2024-09-27 check in ospi20 3D enclosure design
    [ospi20_colored_print.3mf, ospi20_tight.stl]
2025-05-08 add missing latch 3.2 files
    [latdr32.brd, latdr32.sch]
2025-09-07 update license, readme, and reorganize folders
    [acdr_3.0.brd, acdr_3.0.sch, acdr_3.1.brd, acdr_3.1.sch, acdr_3.2.brd, acdr_3.2.sch, acdr_3.2_updated.brd, acdr_3.2_updated.sch]
2025-09-22 add enclosure files for os3.3
    [os33_bottom.stl, os33_top.stl]
2025-10-22 add dc 3.3 hardware files
    [dcdr_3.3.brd, dcdr_3.3.sch]
2025-11-04 add image exports for os2.3 hardware design files
    [os23ac.sch]
